daaaaaaaaaniel/claude-schematic-monomachine-workflow/explore/header-candidates/A2/floorplan-control.png

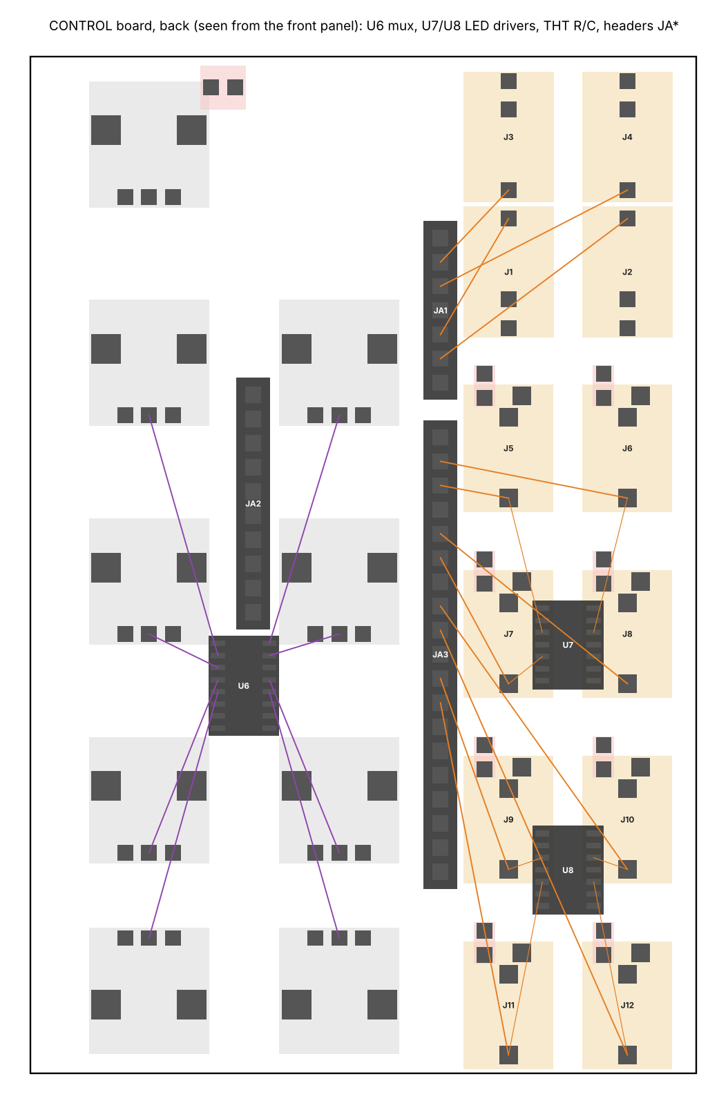
explore/header-candidates/A2/floorplan-control.png
