daaaaaaaaaniel/claude-schematic-monomachine-workflow/explore/header-candidates/A2/floorplan-crossing.png

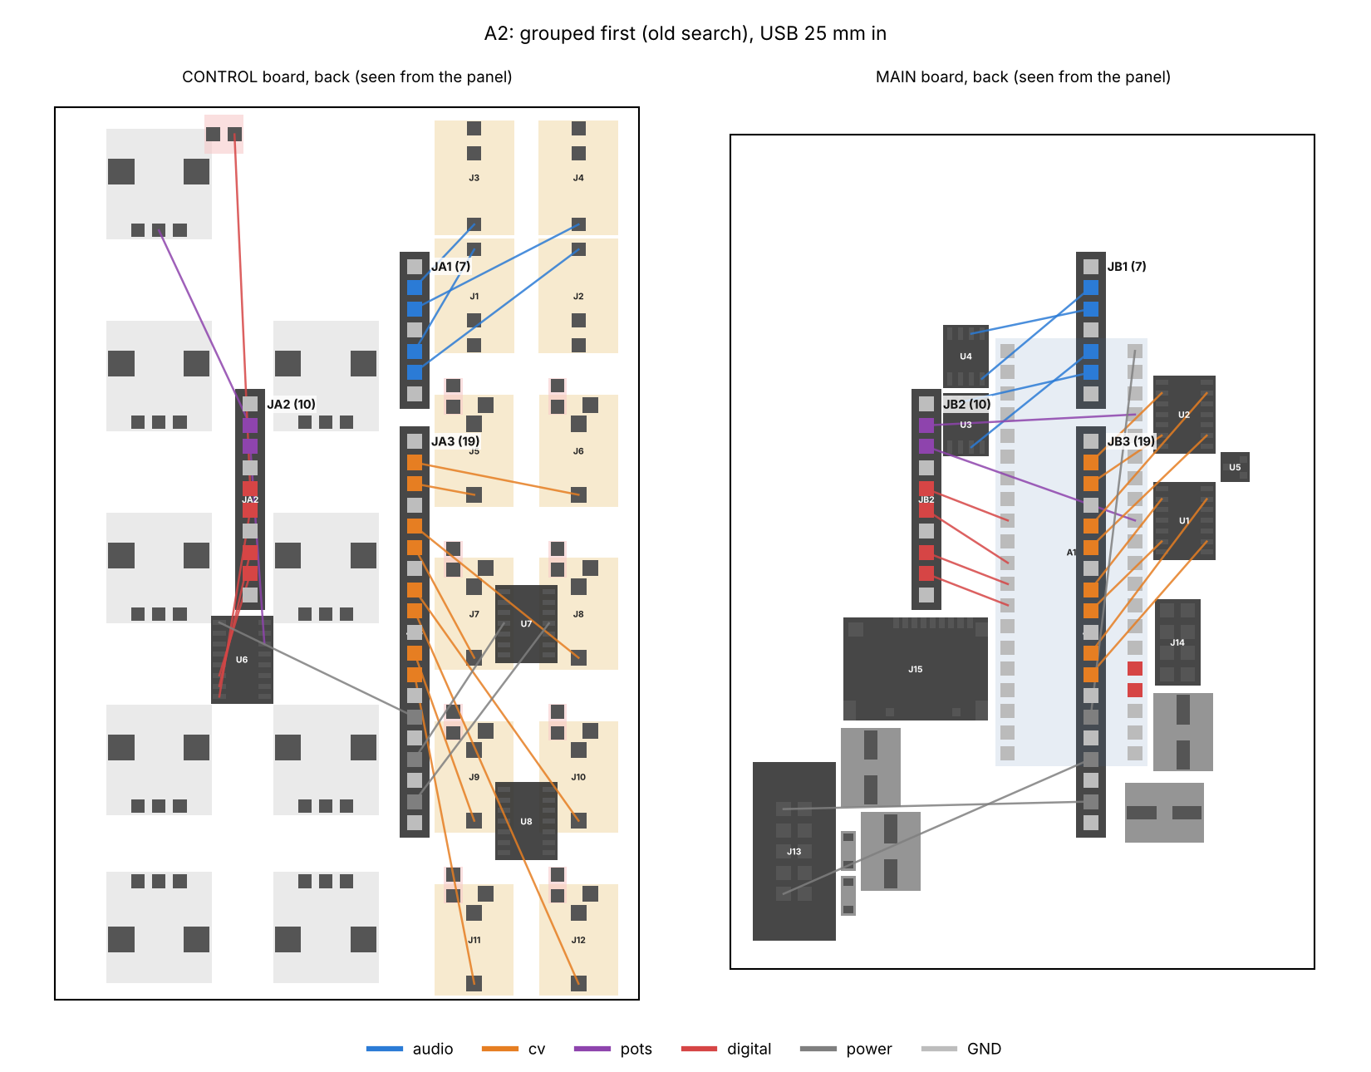
explore/header-candidates/A2/floorplan-crossing.png
