daaaaaaaaaniel/claude-schematic-monomachine-workflow/explore/header-candidates/A2/floorplan-main.png

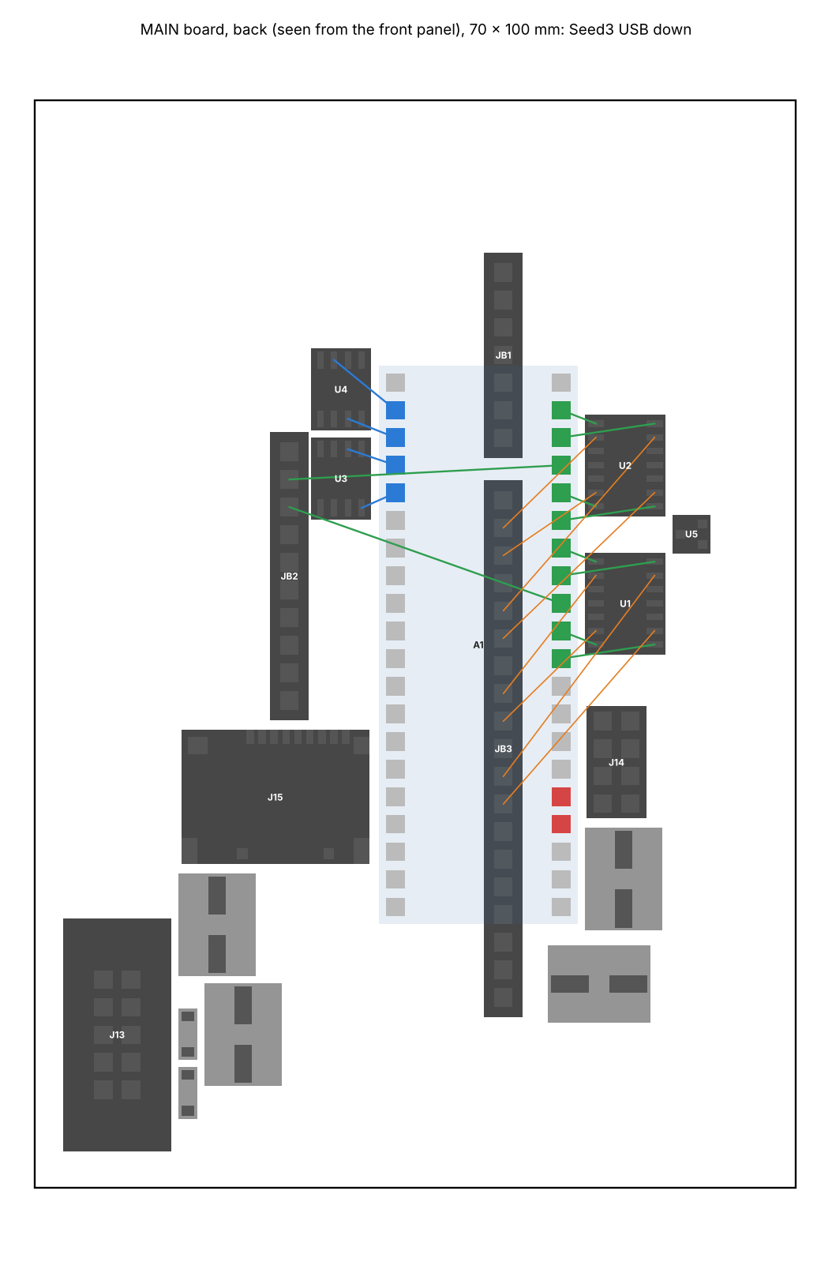
explore/header-candidates/A2/floorplan-main.png
