daaaaaaaaaniel/claude-schematic-monomachine-workflow/explore/header-candidates/A/floorplan-crossing.png

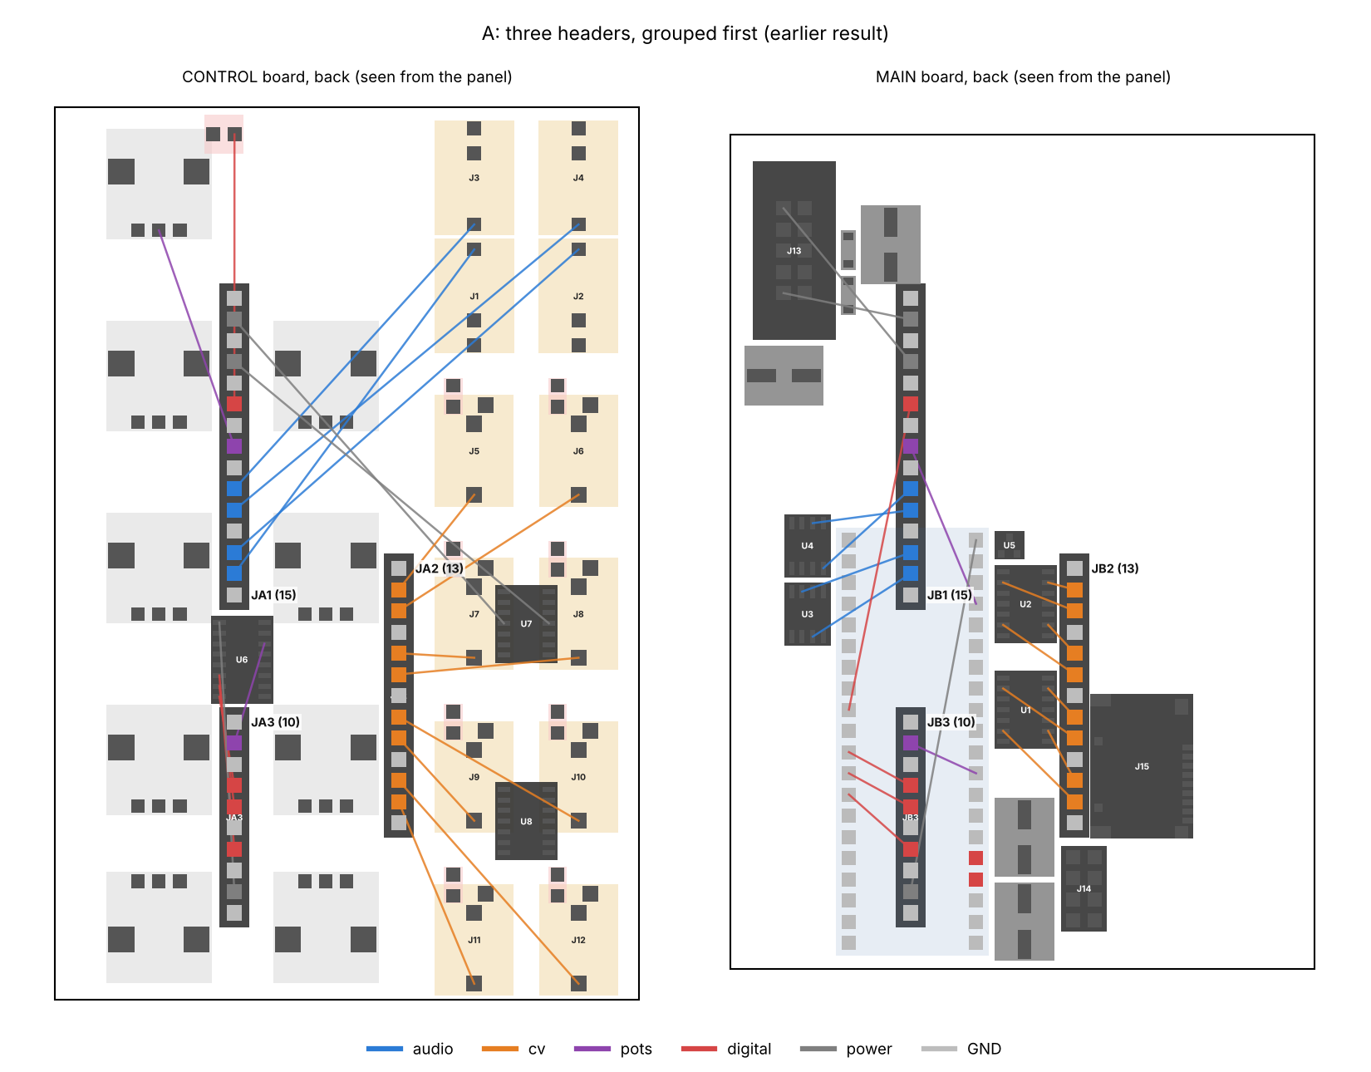
explore/header-candidates/A/floorplan-crossing.png
