daaaaaaaaaniel/claude-schematic-monomachine-workflow/explore/header-candidates/B/floorplan-crossing.png

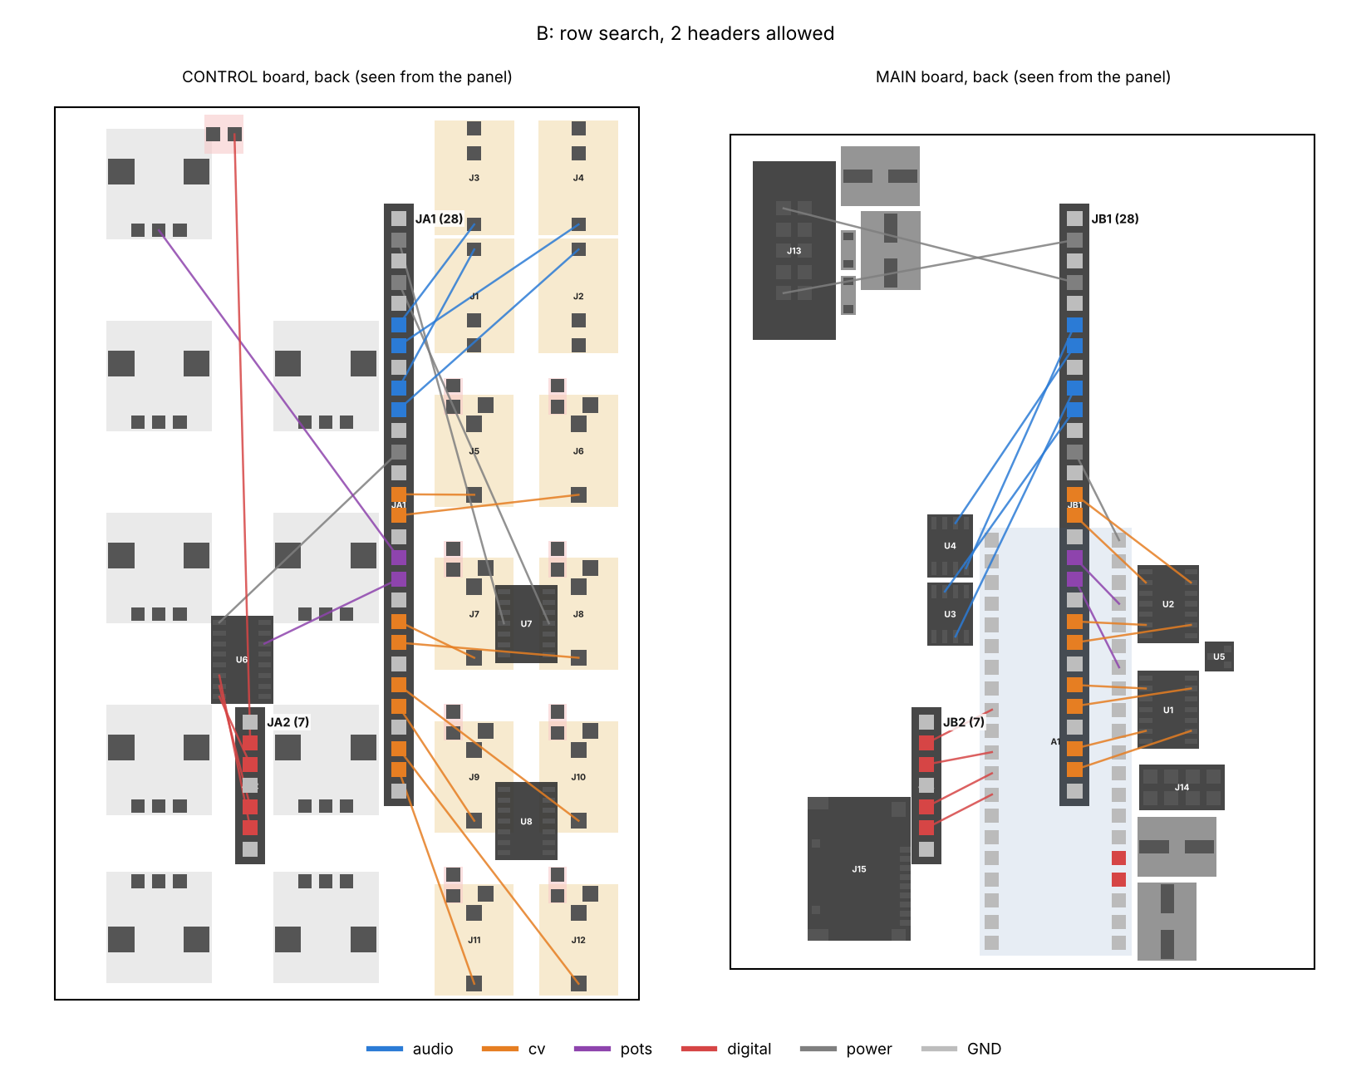
explore/header-candidates/B/floorplan-crossing.png
