daaaaaaaaaniel/claude-schematic-monomachine-workflow/explore/header-candidates/C2/floorplan-control.png

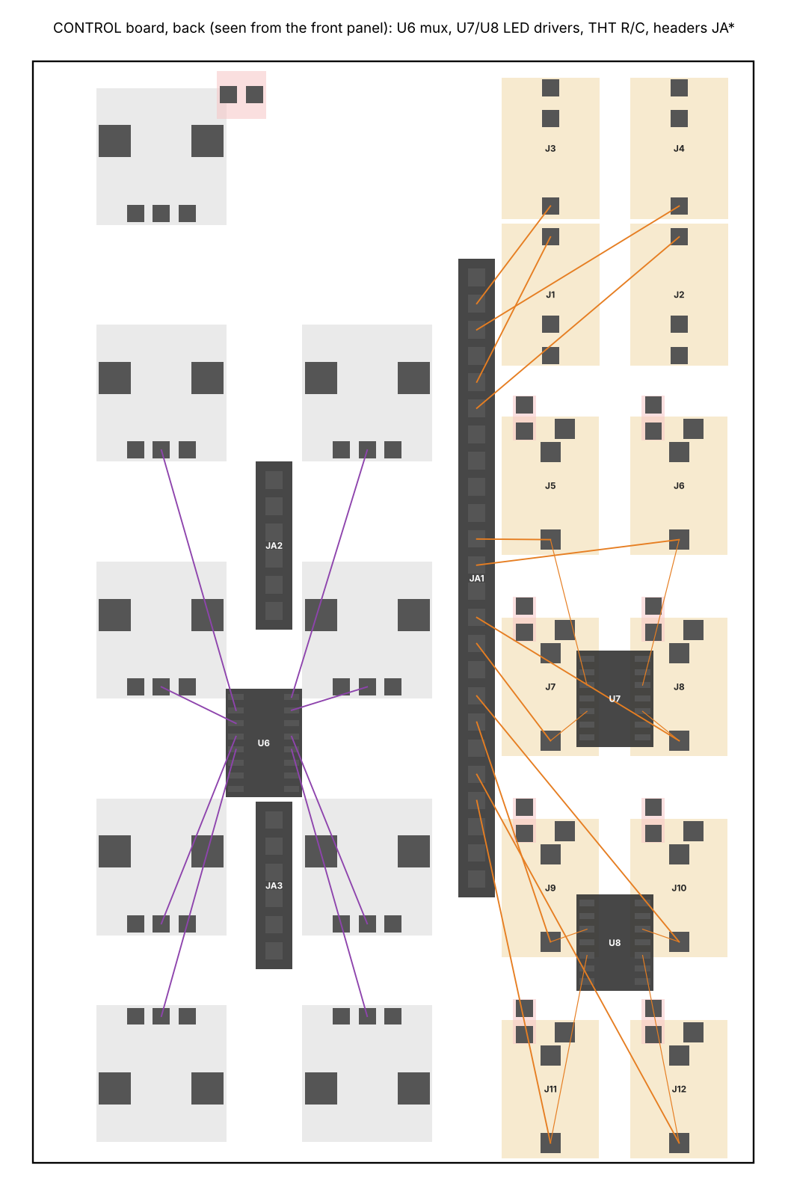
explore/header-candidates/C2/floorplan-control.png
