daaaaaaaaaniel/claude-schematic-monomachine-workflow/explore/header-candidates/C2/floorplan-crossing.png

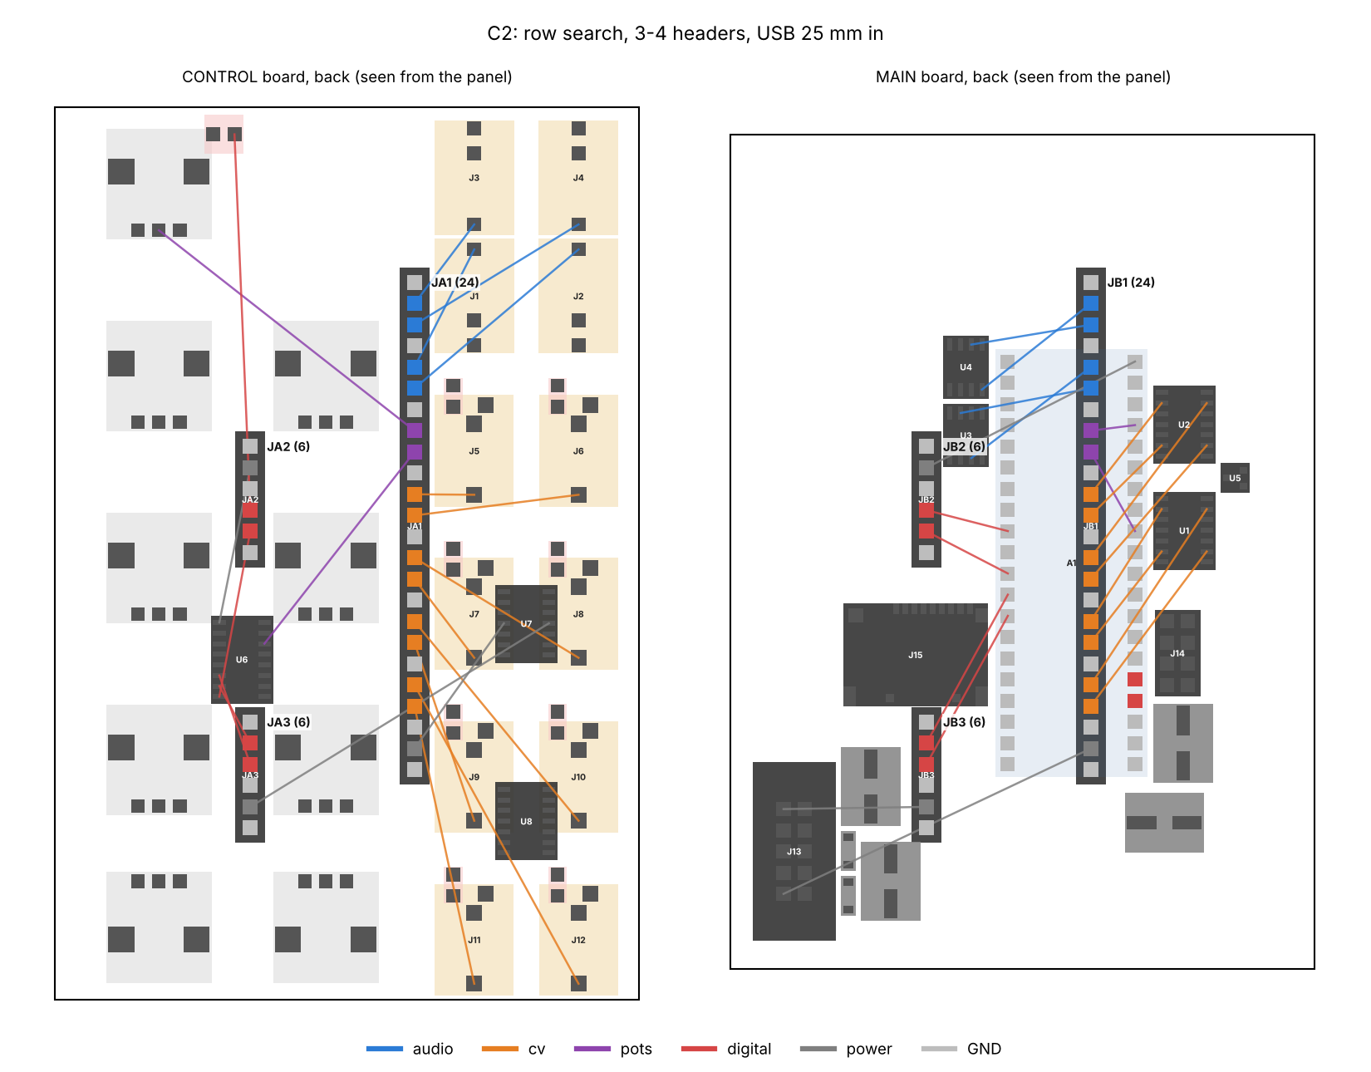
explore/header-candidates/C2/floorplan-crossing.png
