daaaaaaaaaniel/claude-schematic-monomachine-workflow/explore/header-candidates/C/floorplan-crossing.png

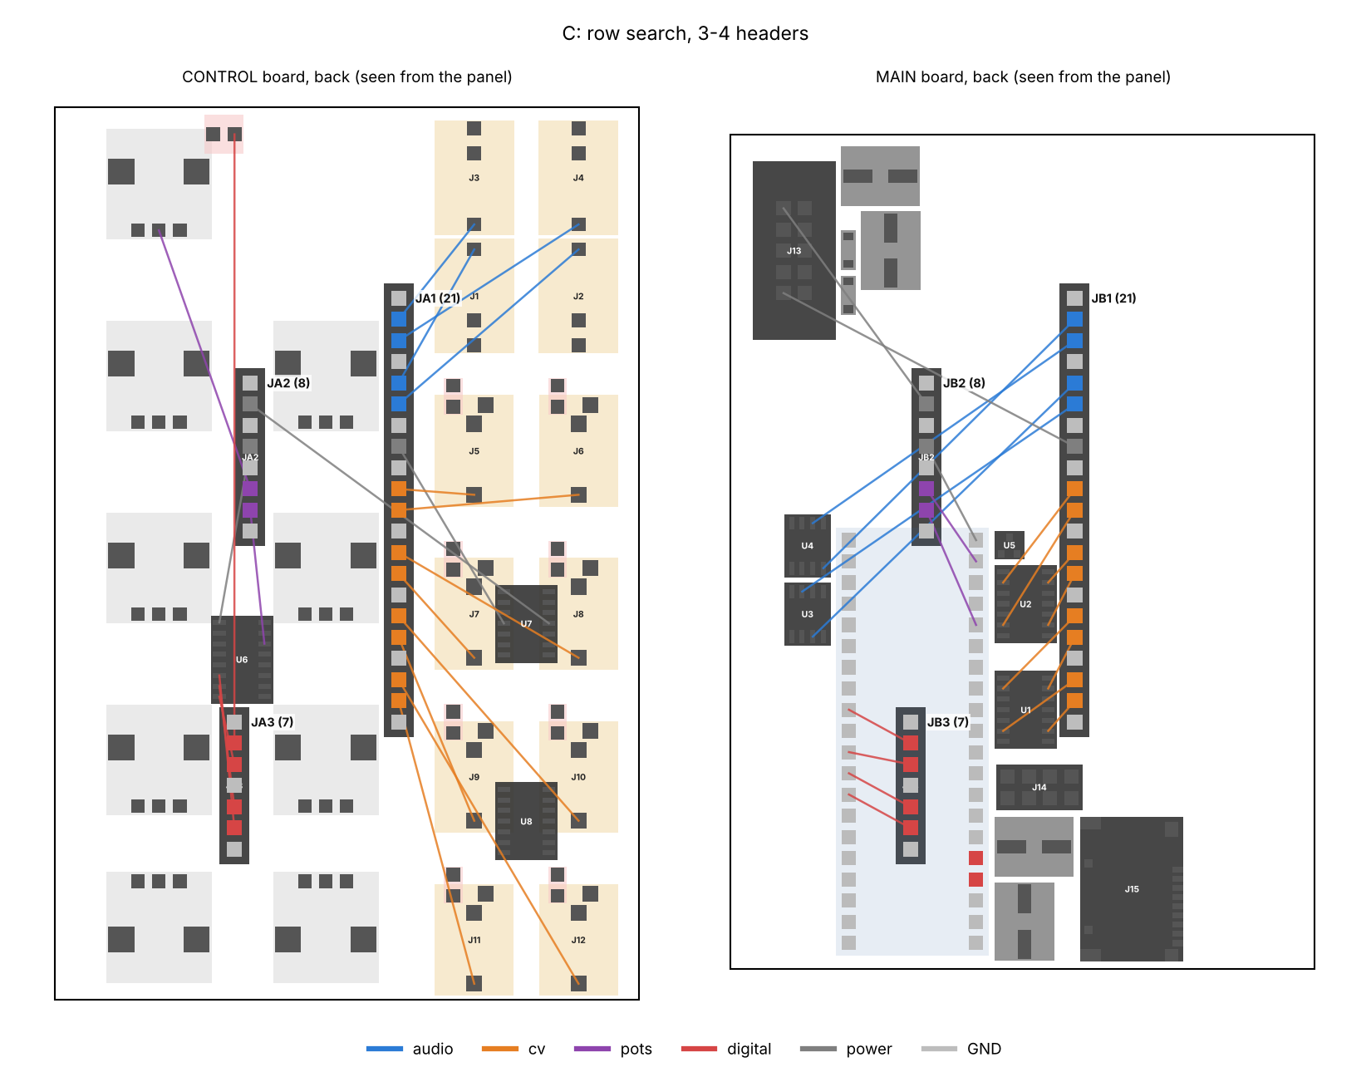
explore/header-candidates/C/floorplan-crossing.png
