daaaaaaaaaniel/claude-schematic-monomachine-workflow/explore/header-candidates/D/floorplan-crossing.png

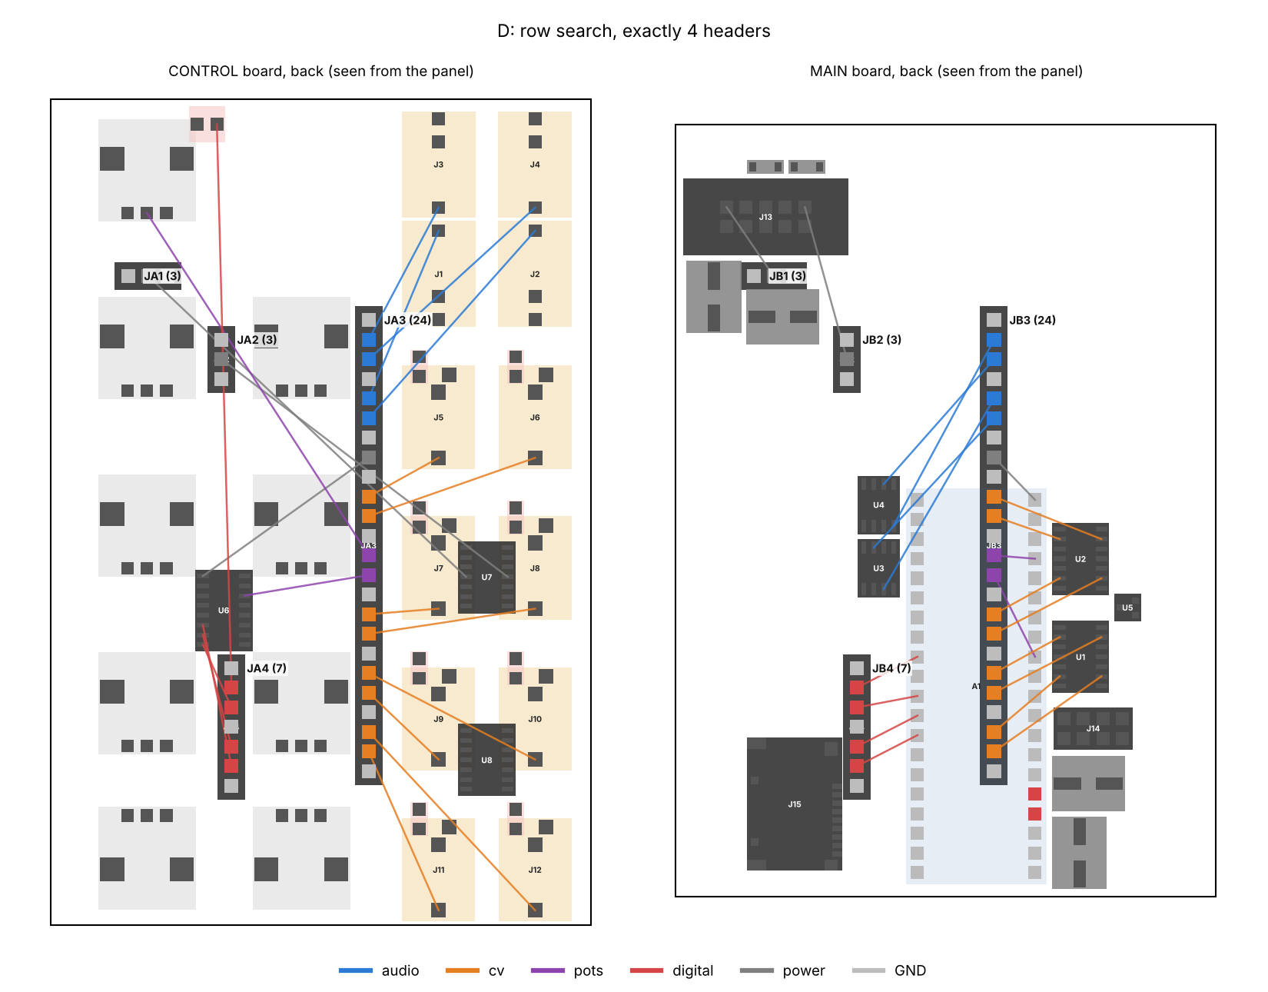
explore/header-candidates/D/floorplan-crossing.png
