daaaaaaaaaniel/claude-schematic-monomachine-workflow/pcb/out/floorplan-control.png

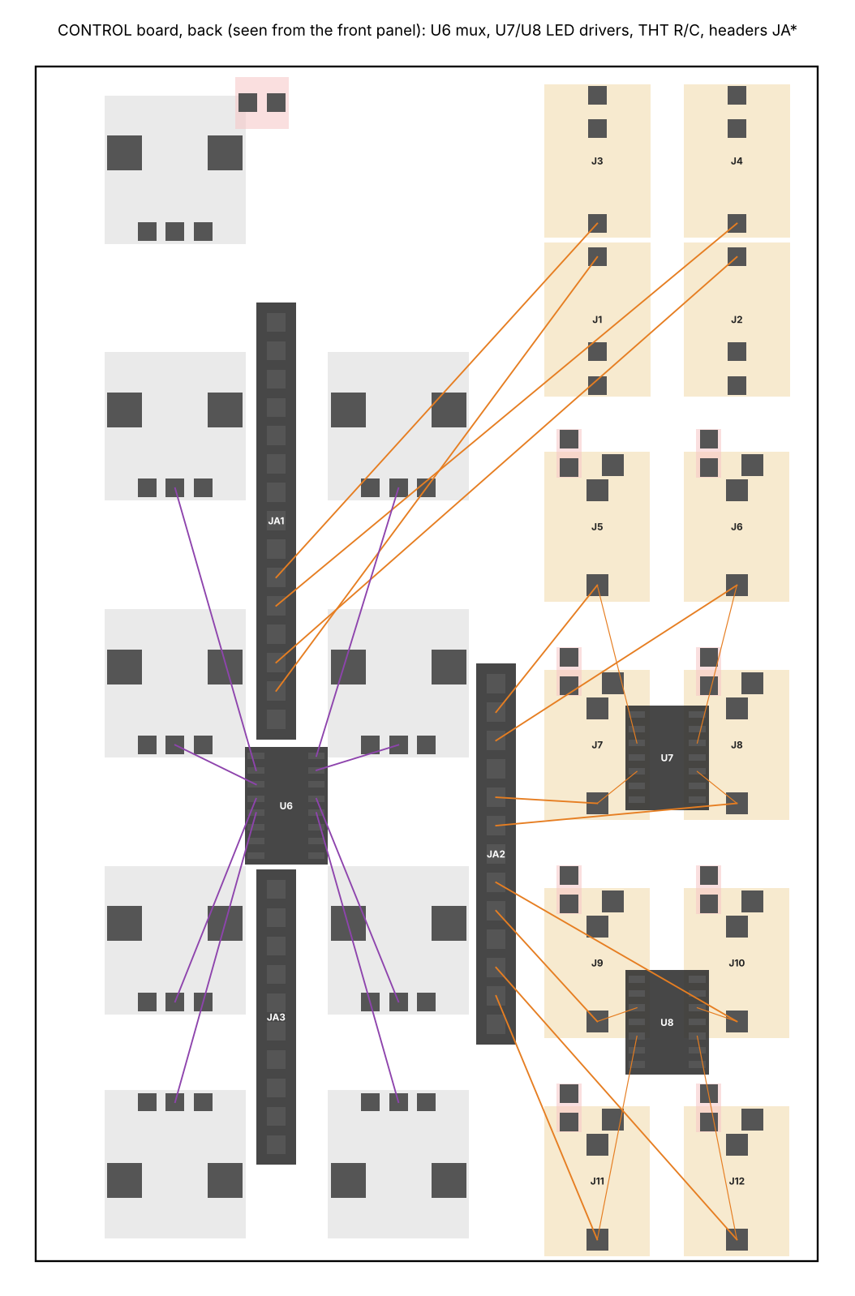
pcb/out/floorplan-control.png
