daaaaaaaaaniel/claude-schematic-monomachine-workflow/pcb/out/floorplan-main.png

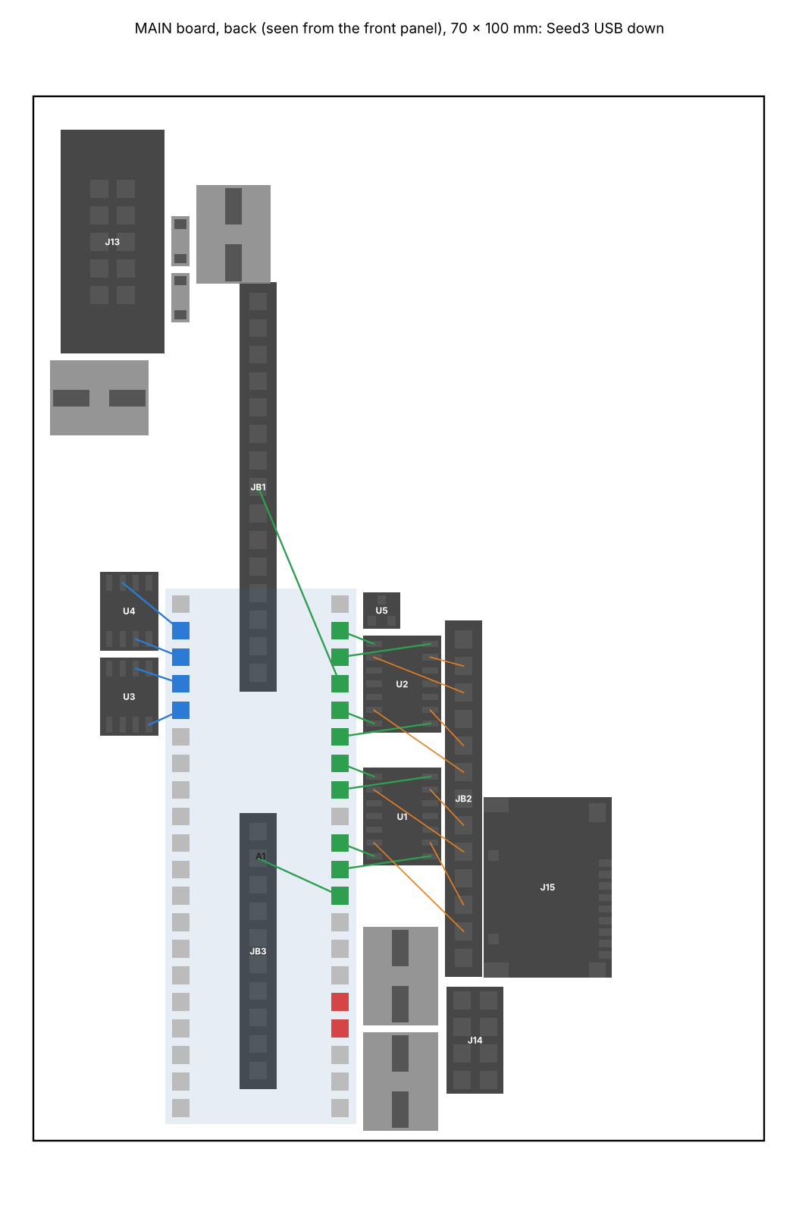
pcb/out/floorplan-main.png
