daaaaaaaaaniel/claude-schematic-monomachine-workflow/pcb/out/pcb-placement.png

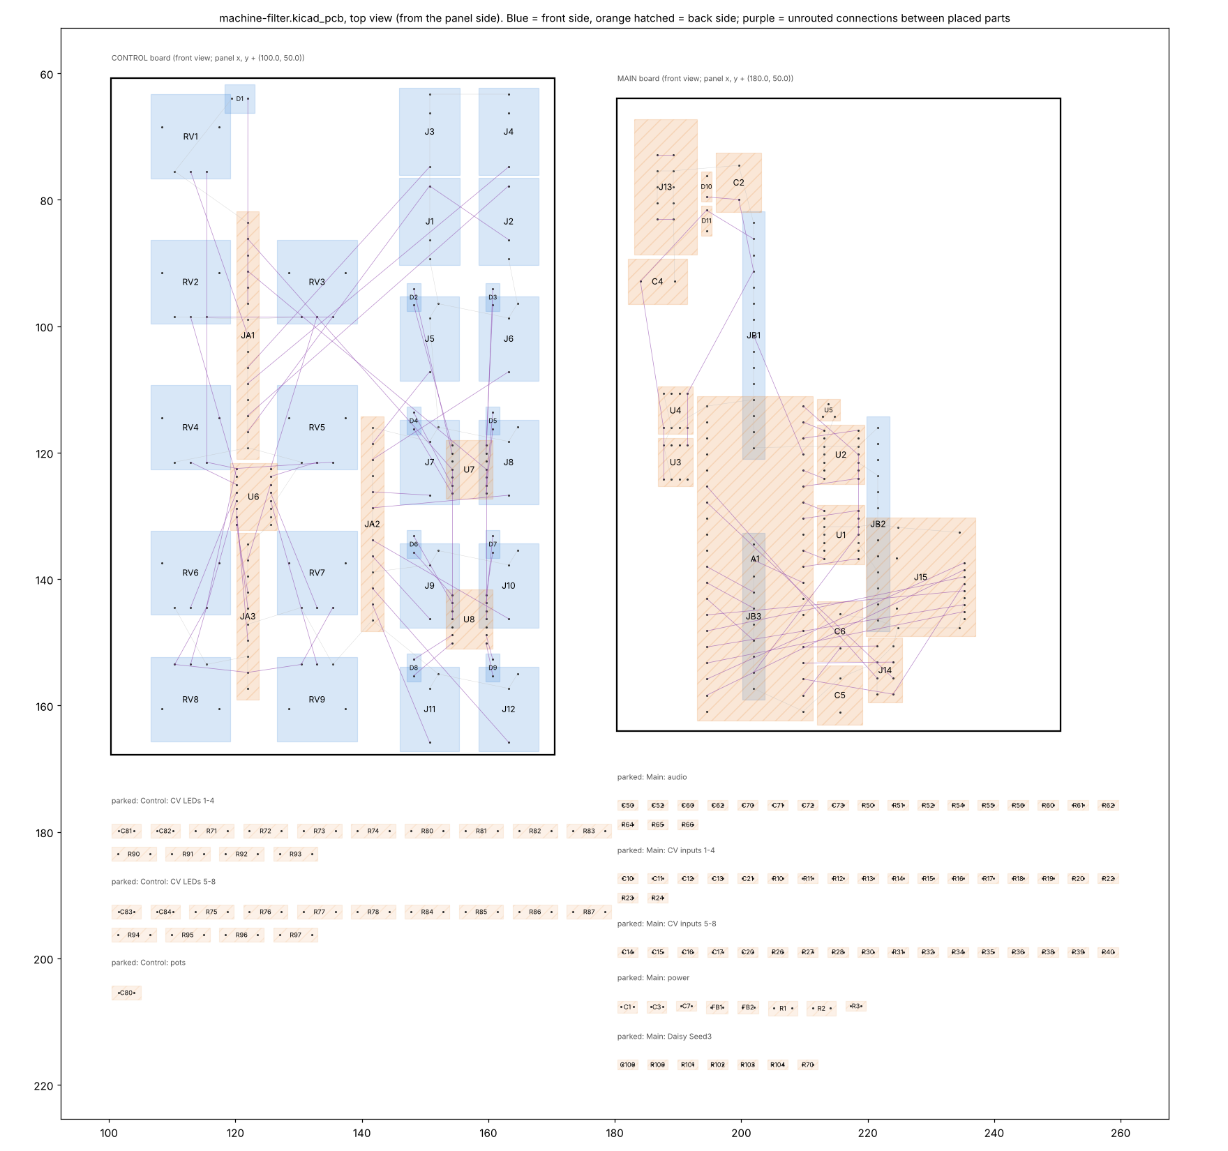
pcb/out/pcb-placement.png
