daaaaaaaaaniel/claude-schematic-monomachine-workflow/pcb/sim/ngspice-checks.png

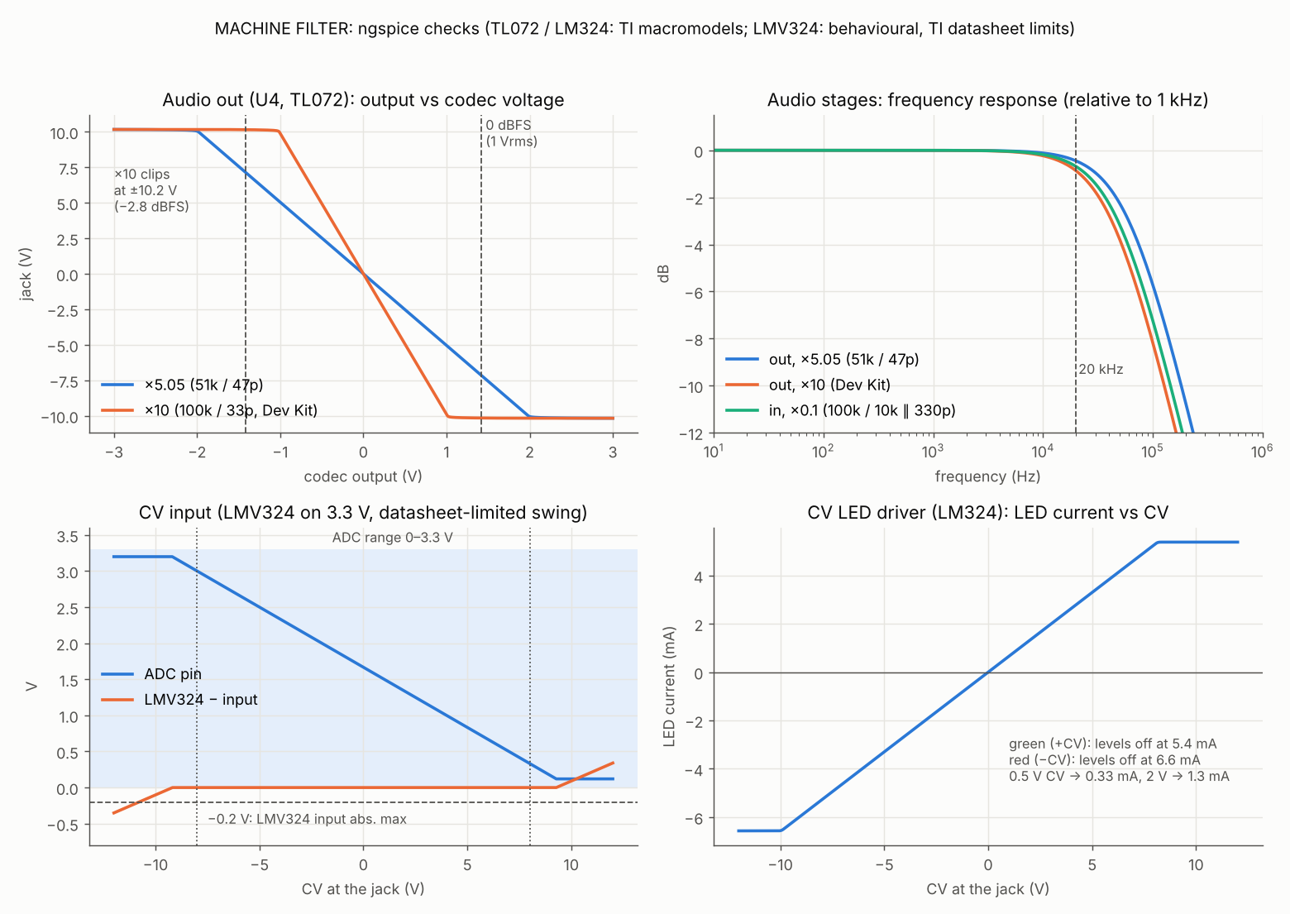
pcb/sim/ngspice-checks.png
