daaaaaaaaaniel/claude-schematic-monomachine-workflow/pcb/out/bom.csv

Reference | Value | Footprint | LCSC | MPN | Board | Assembly | DNP | QUANTITY
A1 | Daisy Seed3 | filter-module:Daisy_Seed_ES_Sockets |  | Electrosmith Daisy Seed3 on 2x 1x20 2.54 mm sockets | main | hand |  | 1
C1,C3 | 10u 25V | filter-module:C_0805 | C15850 | CL21A106KAYNNNE | main | JLC (SMD) |  | 2
C2,C4-C6 | 100u 35V | Capacitor_SMD:CP_Elec_6.3x7.7 | C72478 | RVT1V101M0607 | main | JLC (SMD) |  | 4
C7,C20,C21,C70-C73,C100 | 100n | filter-module:C_0603 | C14663 | CC0603KRX7R9BB104 | main | JLC (SMD) |  | 8
C10-C17 | 1n | filter-module:C_0603 | C1588 | CL10B102KB8NNNC | main | JLC (SMD) |  | 8
C50,C52 | 330p | filter-module:C_0603 | C1664 | CL10C331JB8NNNC | main | JLC (SMD) |  | 2
C60,C62 | 47p | filter-module:C_0603 | C1671 | CL10C470JB8NNNC | main | JLC (SMD) |  | 2
C80-C84 | 100n | Capacitor_THT:C_Disc_D3.0mm_W1.6mm_P2.50mm |  | 100 nF 50 V X7R ceramic, 2.5 mm pitch | control | hand |  | 5
D1 | red 3 mm | filter-module:LED_3mm_C1A2 |  | 3 mm red LED, diffused | control | hand |  | 1
D2-D9 | red/green 3 mm | filter-module:LED_3mm_Raised |  | 3 mm red/green bicolour LED, 2 leads (anti-parallel), diffused | control | hand |  | 8
D10,D11 | B5819W | filter-module:D_SOD-123 | C8598 | B5819W SL | main | JLC (SMD) |  | 2
FB1,FB2 | 600R@100MHz 0.5A | filter-module:R_0805_2012Metric | C1017 | GZ2012D601TF | main | JLC (SMD) |  | 2
J1-J4 | PJ398SM | filter-module:PJ398SM_Jack_ES |  | Thonkiconn PJ398SM | control | hand |  | 4
J5-J12 | PJ398SM | filter-module:PJ398SM_Jack_4ms_BentGND |  | Thonkiconn PJ398SM, sleeve leg bent to the footprint | control | hand |  | 8
J13 | EURO PWR 2x5 | filter-module:Pins_2x05_2.54mm_TH_EurorackPower_Shrouded |  | 2x5 2.54 mm shrouded box header | main | hand |  | 1
J14 | EXPANSION 2x4 | filter-module:Pins_2x04_2.54mm_TH |  | 2x4 2.54 mm pin header, unshrouded (d) | main | hand |  | 1
J15 | TF-01A | filter-module:TF-01A | C91145 | HRO TF-01A microSD socket, push-push (optional, DNP) | main | JLC (SMD) | DNP | 1
JA1 | 1x15 socket | Connector_PinSocket_2.54mm:PinSocket_1x15_P2.54mm_Vertical |  | 2.54 mm female header 1x15, 8.5 mm (as the Seed3 sockets) | control | hand |  | 1
JA2 | 1x13 socket | Connector_PinSocket_2.54mm:PinSocket_1x13_P2.54mm_Vertical |  | 2.54 mm female header 1x13, 8.5 mm (as the Seed3 sockets) | control | hand |  | 1
JA3 | 1x10 socket | Connector_PinSocket_2.54mm:PinSocket_1x10_P2.54mm_Vertical |  | 2.54 mm female header 1x10, 8.5 mm (as the Seed3 sockets) | control | hand |  | 1
JB1 | 1x15 header | Connector_PinHeader_2.54mm:PinHeader_1x15_P2.54mm_Vertical |  | 2.54 mm male pin header 1x15 | main | hand |  | 1
JB2 | 1x13 header | Connector_PinHeader_2.54mm:PinHeader_1x13_P2.54mm_Vertical |  | 2.54 mm male pin header 1x13 | main | hand |  | 1
JB3 | 1x10 header | Connector_PinHeader_2.54mm:PinHeader_1x10_P2.54mm_Vertical |  | 2.54 mm male pin header 1x10 | main | hand |  | 1
R1,R2 | 3.3 0.75W | filter-module:R_1206_3216Metric | C2577888 | SG73P2BTTD3R30F | main | JLC (SMD) |  | 2
R3,R70 | 1k | filter-module:R_0603 | C21190 | 0603WAF1001T5E | main | JLC (SMD) |  | 2
R10,R14 | 100k 0.1% | filter-module:R_0603 | C122538 | RT0603BRD07100KL | main | JLC (SMD) |  | 2
R11,R13,R15,R17 | 20k 0.1% | filter-module:R_0603 | C723637 | RT0603BRD0720KL | main | JLC (SMD) |  | 4
R12,R16 | 120k 25ppm | filter-module:R_0603 | C862537 | RT0603DRD07120KL | main | JLC (SMD) |  | 2
R18,R20,R22,R24,R26,R28,R30,R32,R34,R36,R38,R40 | 120k | filter-module:R_0603 | C25808 | 0603WAF1203T5E | main | JLC (SMD) |  | 12
R19,R23,R27,R31,R35,R39 | 20k | filter-module:R_0603 | C4184 | 0603WAF2002T5E | main | JLC (SMD) |  | 6
R50,R54 | 100k | filter-module:R_0603 | C25803 | 0603WAF1003T5E | main | JLC (SMD) |  | 2
R51,R55,R60,R64 | 10k | filter-module:R_0603 | C25804 | 0603WAF1002T5E | main | JLC (SMD) |  | 4
R52,R56,R62,R66 | 100 | filter-module:R_0603 | C22775 | 0603WAF1000T5E | main | JLC (SMD) |  | 4
R61,R65 | 51k | filter-module:R_0603 | C23196 | 0603WAF5102T5E | main | JLC (SMD) |  | 2
R71-R78 | 1.5k | Resistor_THT:R_Axial_DIN0204_L3.6mm_D1.6mm_P5.08mm_Horizontal |  | 1.5k 1/8 W 1% metal film, axial DIN0204 | control | hand |  | 8
R80-R87 | 10k | Resistor_THT:R_Axial_DIN0204_L3.6mm_D1.6mm_P5.08mm_Horizontal |  | 10k 1/8 W 1% metal film, axial DIN0204 | control | hand |  | 8
R90-R97 | 1M | Resistor_THT:R_Axial_DIN0204_L3.6mm_D1.6mm_P5.08mm_Horizontal |  | 1M 1/8 W 1% metal film, axial DIN0204 | control | hand |  | 8
R100-R104 | 47k | filter-module:R_0603 | C25819 | 0603WAF4702T5E | main | JLC (SMD) |  | 5
RV1-RV9 | B10k | filter-module:Pot_9mm_SnapIn_ES |  | Alpha RD901F 9 mm B10k (any shaft) | control | hand |  | 9
U1,U2 | LMV324 | filter-module:SOIC-14_3.9x8.65mm_Pitch1.27mm | C7974 | LMV324IDR | main | JLC (SMD) |  | 2
U3,U4 | TL072 | filter-module:SOIC-8_3.9x4.9mm_Pitch1.27mm | C6961 | TL072CDT | main | JLC (SMD) |  | 2
U5 | LM4040-10 | filter-module:SOT-23 | C201738 | LM4040C10IDBZR | main | JLC (SMD) |  | 1
U6 | 74HC4051 | filter-module:SOIC-16_3.9x9.9mm_Pitch1.27mm | C9386 | 74HC4051D,653 | control | hand |  | 1
U7,U8 | LM324 | filter-module:SOIC-14_3.9x8.65mm_Pitch1.27mm | C71035 | LM324DT | control | hand |  | 2
