daaaaaaaaaniel/claude-schematic-monomachine-workflow/pcb/out/machine-filter.pdf

1 | 2 | 3 | 4 | 5 | 6 | 7 | 8

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
Size: A3 | Rev: beta | F Date: 2026-10-06
KiCad E.D.A. 10.0.6 | Id: 1/12

## Title: MACHINE FILTER

### File: machine-filter.kicad_sch

### Sheet: /

## MACHINE FILTER (Seed3 build): both boards

Drawn by pcb/design/gen_sch.py from boards.py; netlist checked against machine_filter.py (SKiDL).

Circuit blocks after Electrosmith's Seed3 Eurorack Dev Kit Rev3 (MIT).

### Page 1: MACHINE FILTER: two boards

Control: connector File: control-connector.kicad_sch Control: pots

File: control-pots.kicad_sch

### Control: CV LEDs 5-8

# File: control-cv-leds-5-8.kicad_sch Main: CV inputs 5-8

File: main-cv-inputs-5-8.kicad_sch

### Control: CV LEDs 1-4

File: control-cv-leds-1-4.kicad_sch

Main: power File: main-power.kicad_sch

### Main: CV inputs 1-4

File: main-cv-inputs-1-4.kicad_sch

### Main: Daisy Seed3

File: main-seed3.kicad_sch Control: jacks

File: control-jacks.kicad_sch

### Main: audio

File: main-audio.kicad_sch | Main: connector File: main-connector.kicad_sch

page 11

EQ FREQ, EQ GAIN, DIST, SMPL RATE

# LED drivers (U8) ADC stages (U1) page 5

EQ FREQ, EQ GAIN, DIST, SMPL RATE

page 4 | page 6

JAn plugs onto JBn, pin k to pin k, about 11 mm apart. Every net on the control board is its own copper, so it has its exactly the one-circuit SKiDL netlist (machine_filter.py).

BASE, WIDTH, HP RES, LP RES

ADC stages (U2) page 10 BASE, WIDTH, HP RES, LP RES
LED drivers (U7) | codec -> U4 -> OUT L / OUT R

page 7

JB1, JB2, JB3

to the control board

IN L / IN R -> U3 -> codec page 12

JA1, JA2, JA3

to the main board Daisy Seed3 (A1)

### MAIN board

### CONTROL board

through-hole resistors and capacitors, female headers JA1, JA2, JA3. 1 | MACHINE FILTER: two boards

JLC SMD assembly, 70 x 100 mm. Back: Daisy Seed3 on sockets, power entry, CV ADC stages U1/U2, audio U3/U4,

Hand-soldered, 70 x 107 mm. Front: 12 jacks, 9 pots, 9 LEDs. Back: pot multiplexer U6, LED drivers U7/U8 (SOIC),

How they meet own name: the main board's name with the prefix CTL_ (CTL_GND, CTL_+12V, CTL_CV_BASE, ...). CTL_x meets x only at MAIN board (JLC SMD assembly)

page 2

Eurorack power entry Seed3 VIN filter -10 V reference | page 3

the header pins (pages 7 and 12), as in the hardware. tools/check_netlist.py checks that the boards joined there are

expansion header J14

clip-LED resistor R70 microSD J15 (optional)

# CONTROL board (hand-soldered)

page 8

12 jacks

clip LED D1

page 9

9 pots

pot multiplexer U6

one KiCad project; the PCB file holds both boards side by side, cut apart for fabrication by tools/separate.sh (KiKit) -10 V reference U5, expansion header J14, optional microSD J15 (DNP). Front: male headers JB1 (15 pins), JB2 (13 pins), JB3 (10 pins).

## Two boards, one module

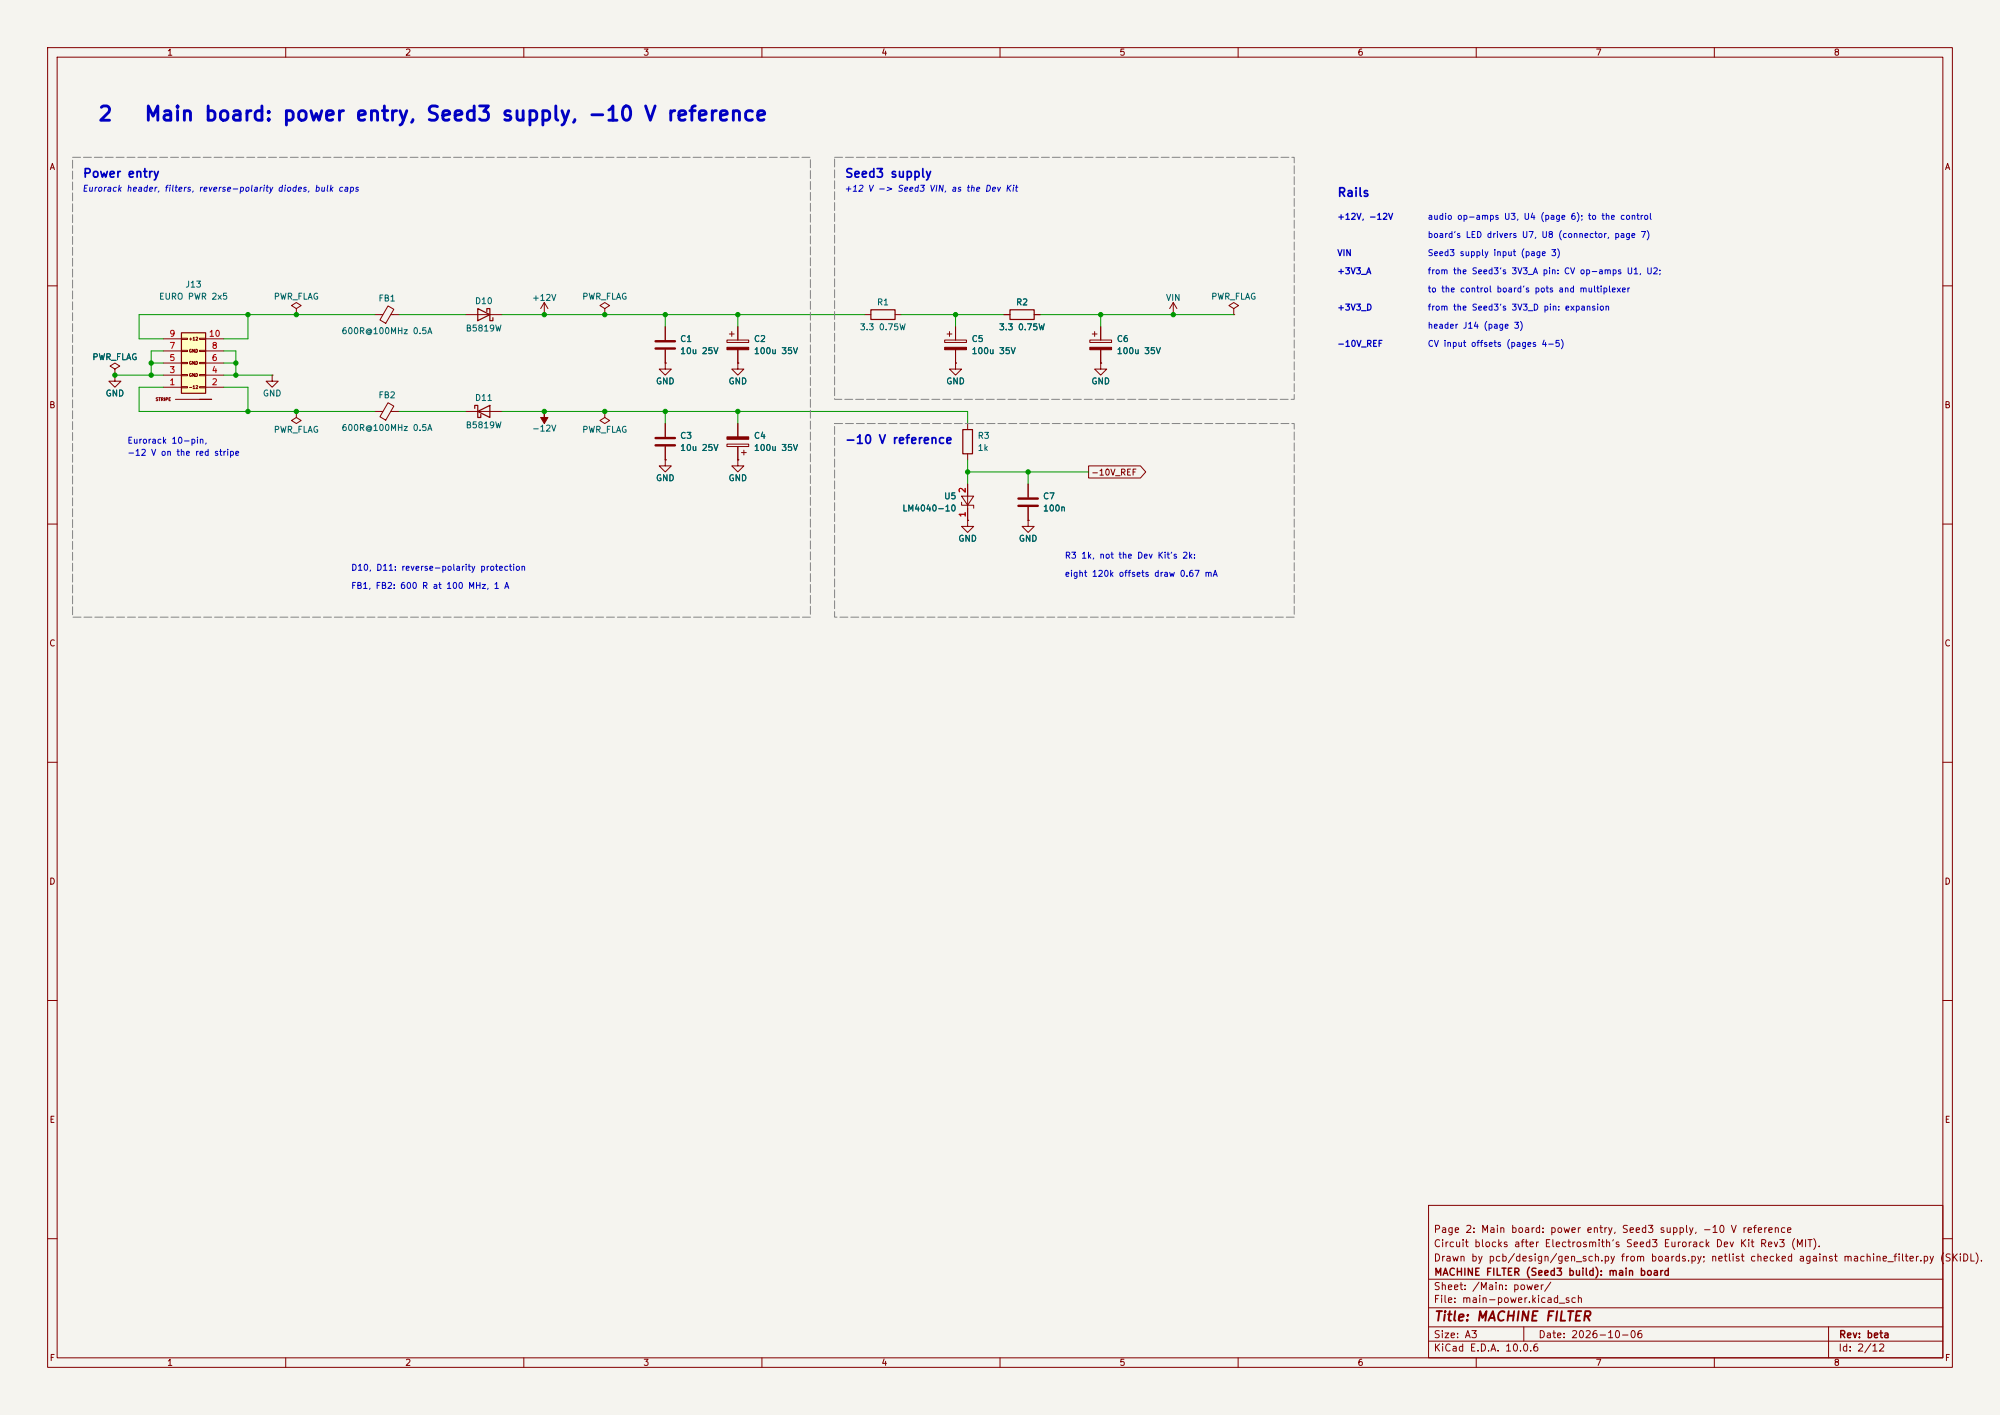
[picture p14: page 2]

FB1, FB2: 600 R at 100 MHz, 1 A Power entry

Rails -12 V on the red stripe Eurorack 10-pin,

from the Seed3's 3V3_A pin: CV op-amps U1, U2; Seed3 supply input (page 3) board's LED drivers U7, U8 (connector, page 7) audio op-amps U3, U4 (page 6); to the control VIN -10 V reference

to the control board's pots and multiplexer

from the Seed3's 3V3_D pin: expansion

GND -12 1 | 2

eight 120k offsets draw 0.67 mA

Page 2: Main board: power entry, Seed3 supply, -10 V reference
Circuit blocks after Electrosmith's Seed3 Eurorack Dev Kit Rev3 (MIT).
Drawn by pcb/design/gen_sch.py from boards.py; netlist checked against machine_filter.py (SKiDL).
MACHINE FILTER (Seed3 build): main board
Sheet: /Main: power/
File: main-power.kicad_sch

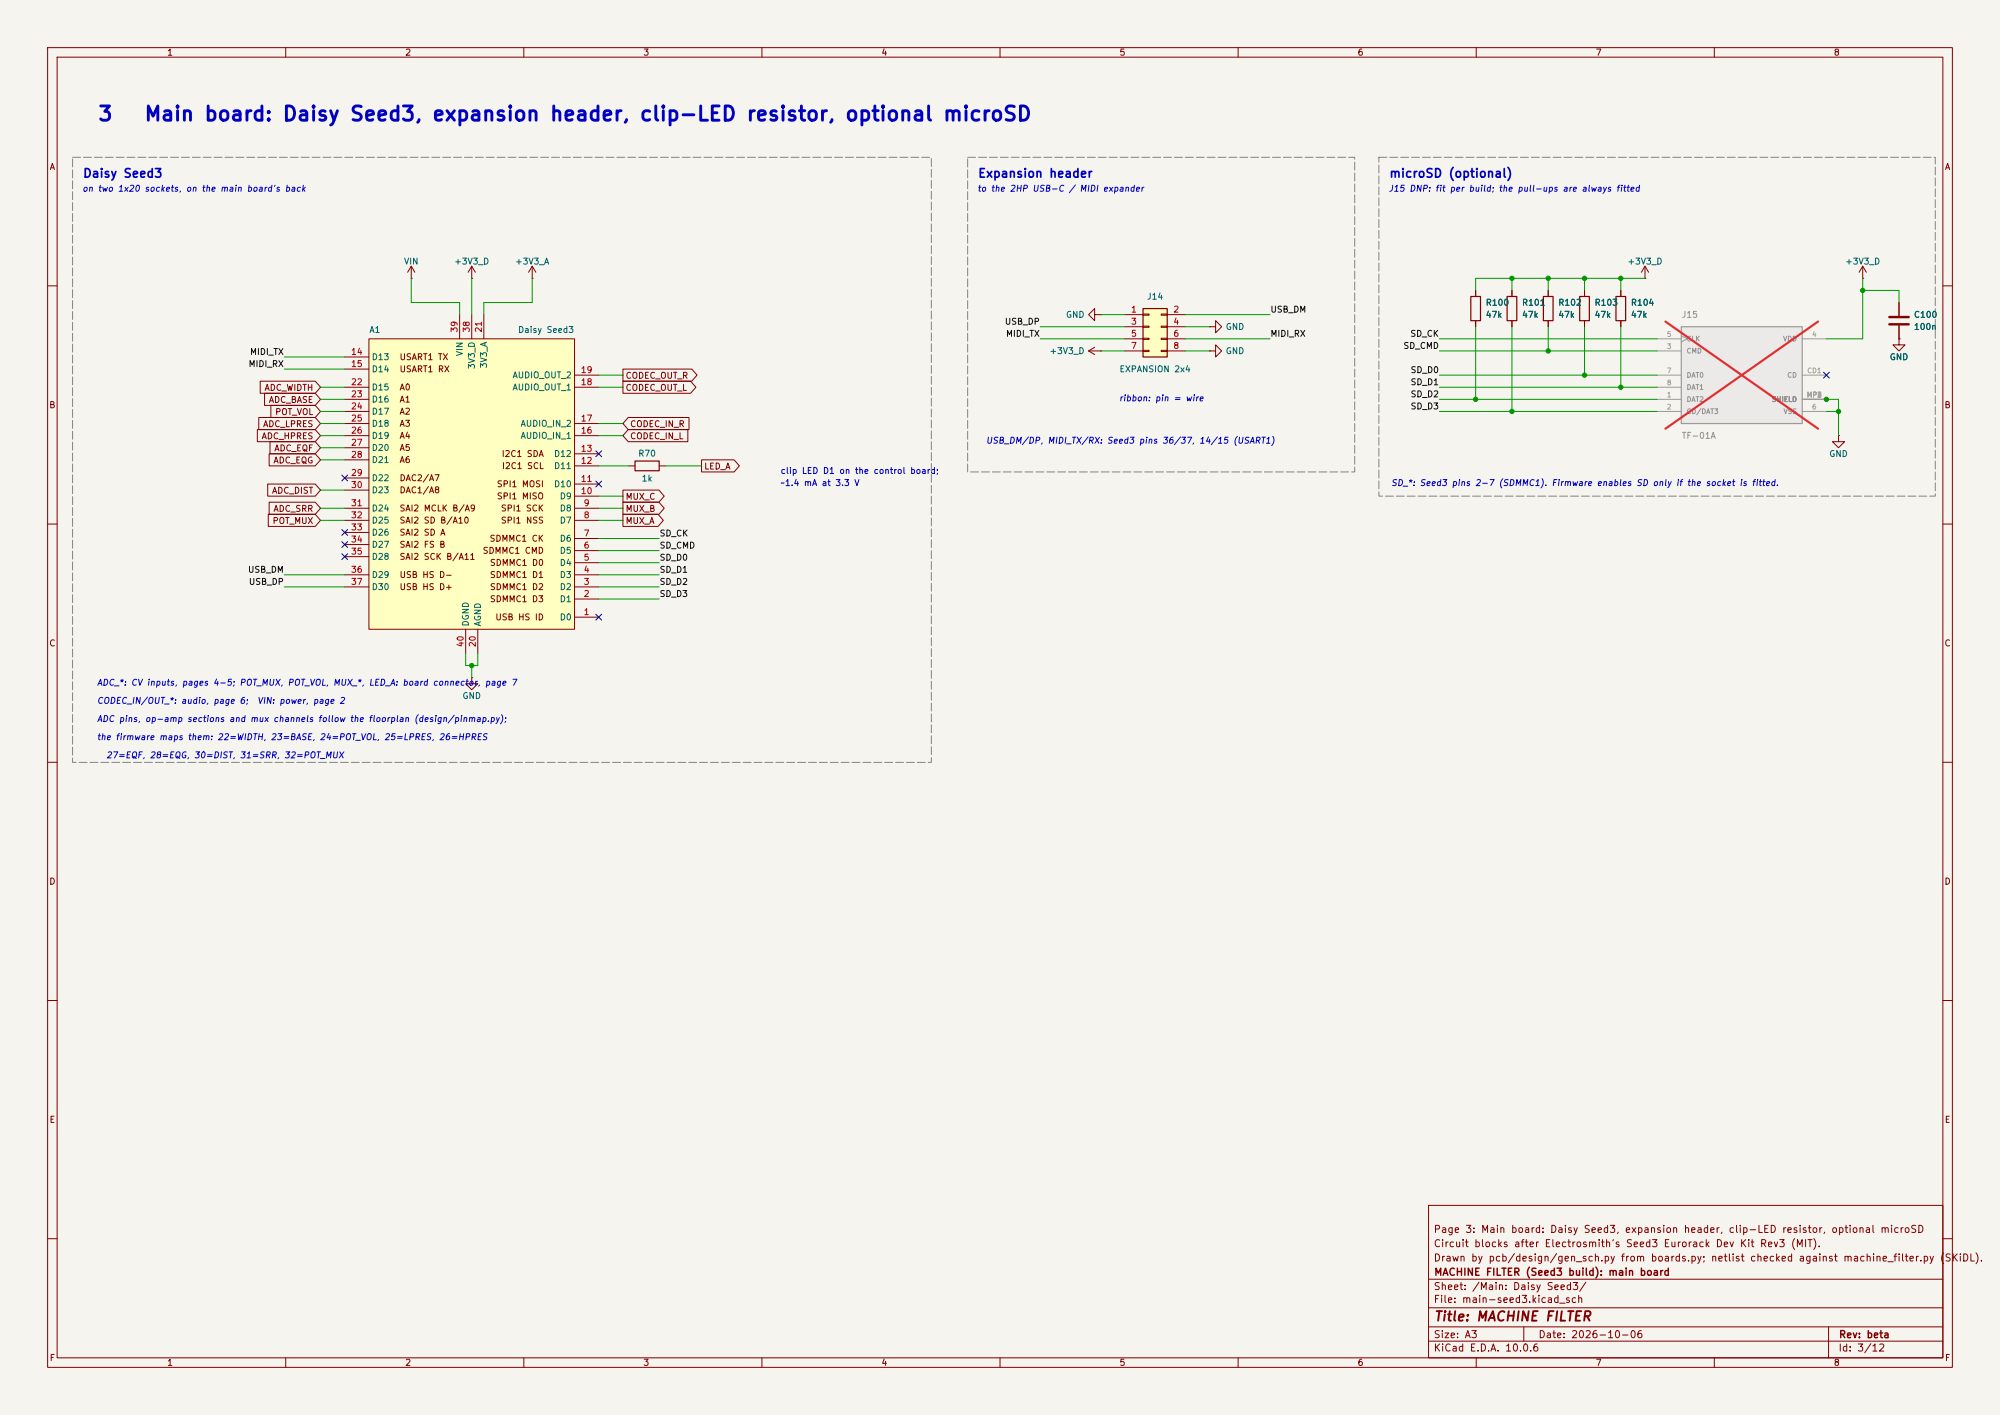
[picture p15: page 3]

ribbon: pin = wire Daisy Seed3

SD_*: Seed3 pins 2-7 (SDMMC1). Firmware enables SD only if the socket is fitted. J15 DNP: fit per build; the pull-ups are always fitted microSD (optional)

to the 2HP USB-C / MIDI expander

ADC_*: CV inputs, pages 4-5; POT_MUX, POT_VOL, MUX_*, LED_A: board connector, page 7

ADC pins, op-amp sections and mux channels follow the floorplan (design/pinmap.py);

the firmware maps them: 22=WIDTH, 23=BASE, 24=POT_VOL, 25=LPRES, 26=HPRES

27=EQF, 28=EQG, 30=DIST, 31=SRR, 32=POT_MUX

Page 3: Main board: Daisy Seed3, expansion header, clip-LED resistor, optional microSD
Circuit blocks after Electrosmith's Seed3 Eurorack Dev Kit Rev3 (MIT).
Drawn by pcb/design/gen_sch.py from boards.py; netlist checked against machine_filter.py (SKiDL).
MACHINE FILTER (Seed3 build): main board
Sheet: /Main: Daisy Seed3/
File: main-seed3.kicad_sch

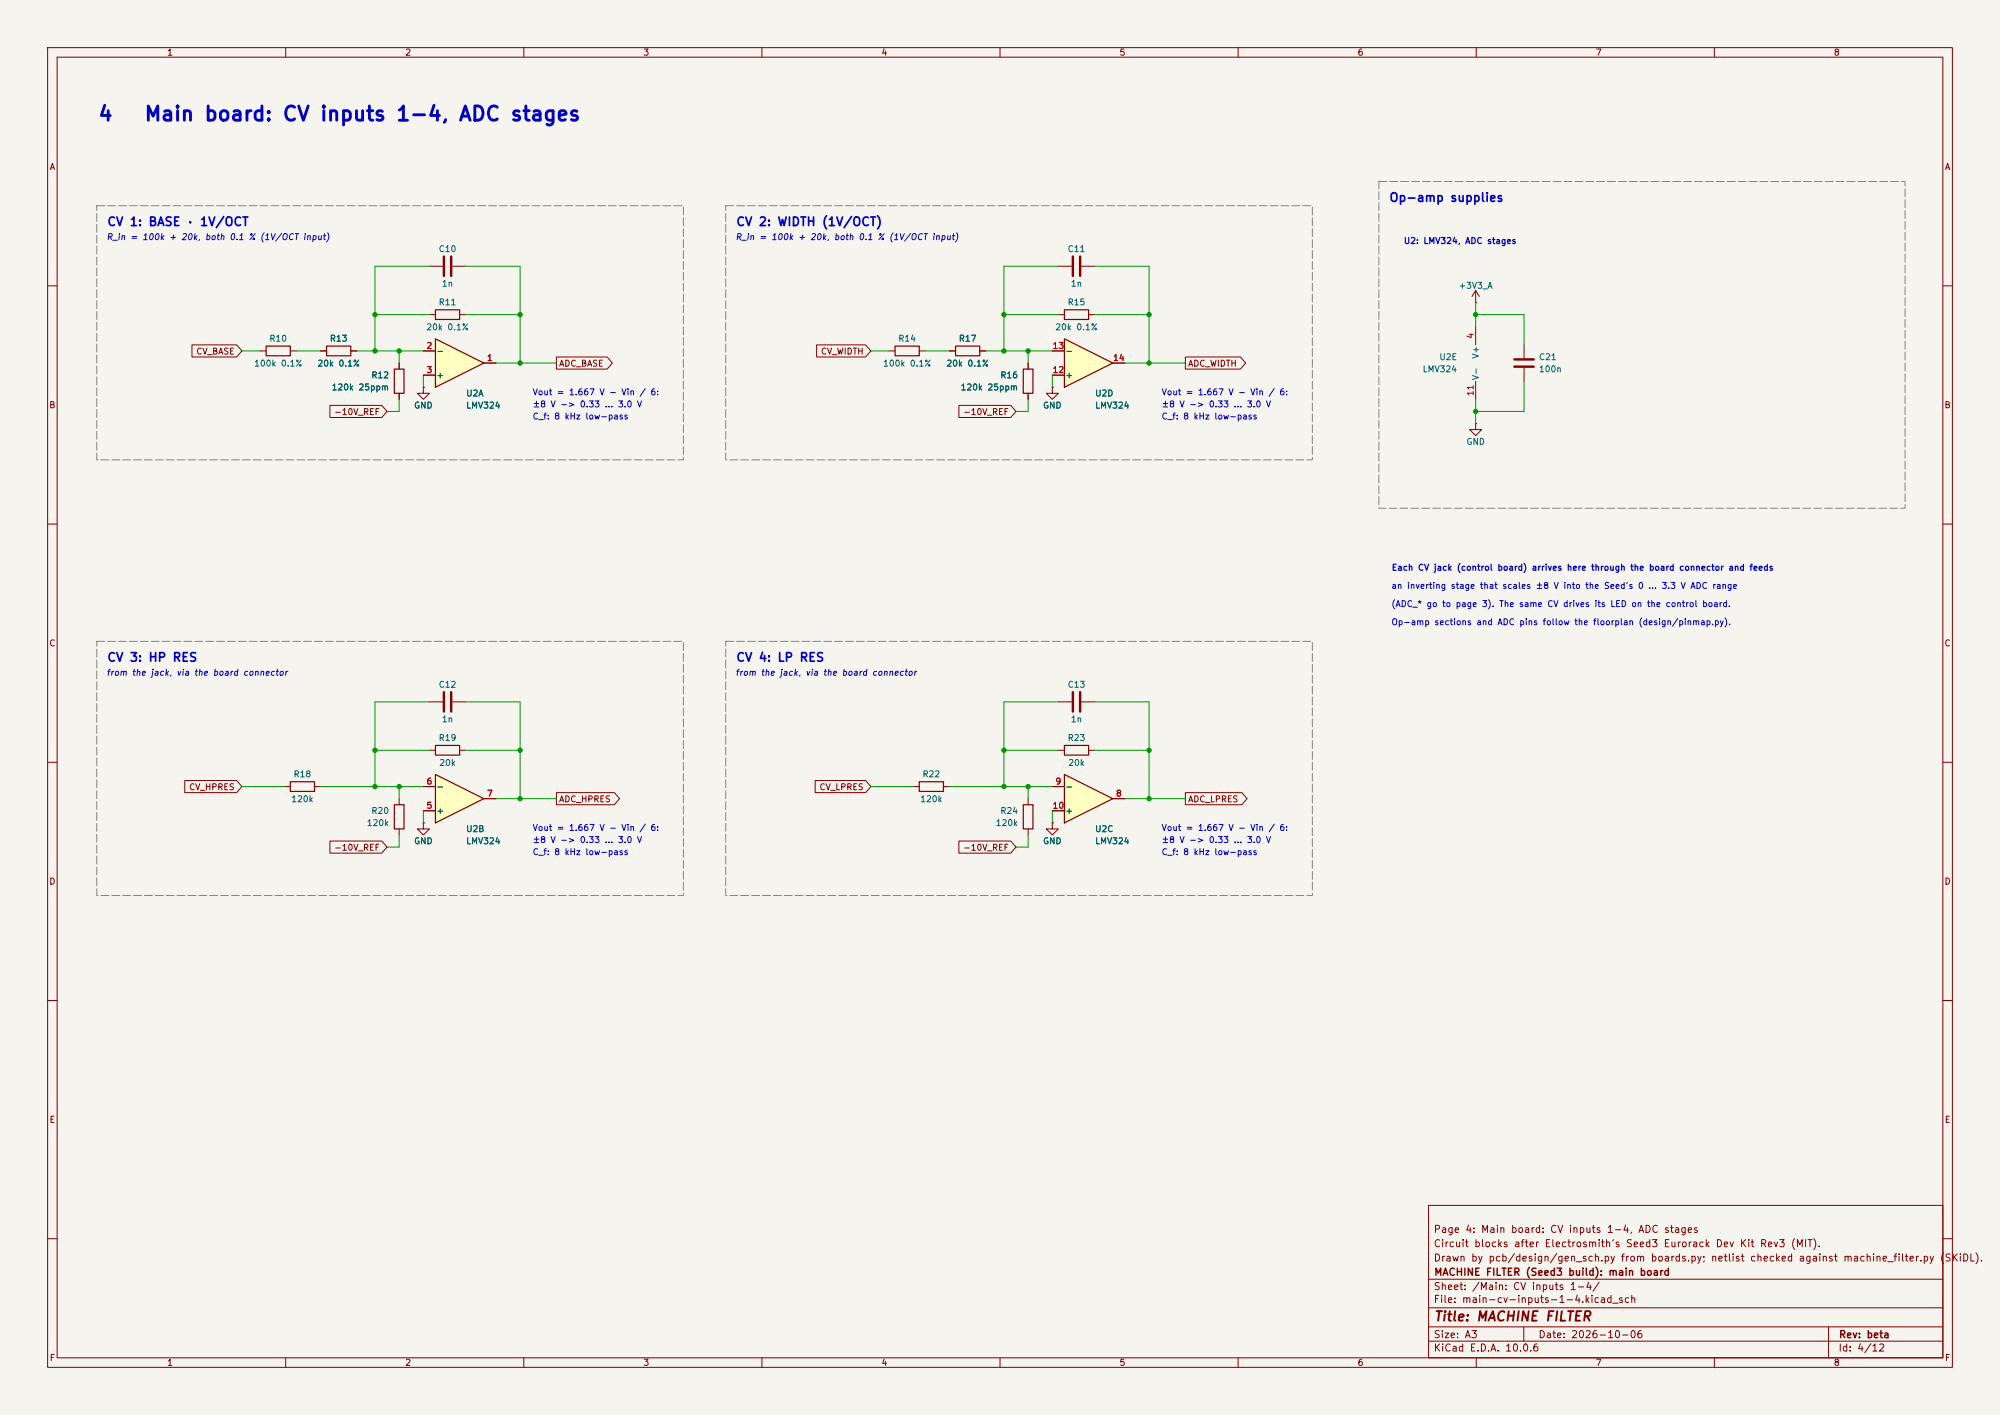
[picture p16: page 4]

Vout = 1.667 V - Vin / 6: C_f: 8 kHz low-pass ±8 V -> 0.33 ... 3.0 V R_in = 100k + 20k, both 0.1 % (1V/OCT input)

C_f: 8 kHz low-pass R_in = 100k + 20k, both 0.1 % (1V/OCT input)

(ADC_* go to page 3). The same CV drives its LED on the control board. Op-amp sections and ADC pins follow the floorplan (design/pinmap.py). Each CV jack (control board) arrives here through the board connector and feeds CV 3: HP RES

an inverting stage that scales ±8 V into the Seed's 0 ... 3.3 V ADC range

Page 4: Main board: CV inputs 1-4, ADC stages R24

Circuit blocks after Electrosmith's Seed3 Eurorack Dev Kit Rev3 (MIT).
Drawn by pcb/design/gen_sch.py from boards.py; netlist checked against machine_filter.py (SKiDL).
MACHINE FILTER (Seed3 build): main board
Sheet: /Main: CV inputs 1-4/
File: main-cv-inputs-1-4.kicad_sch

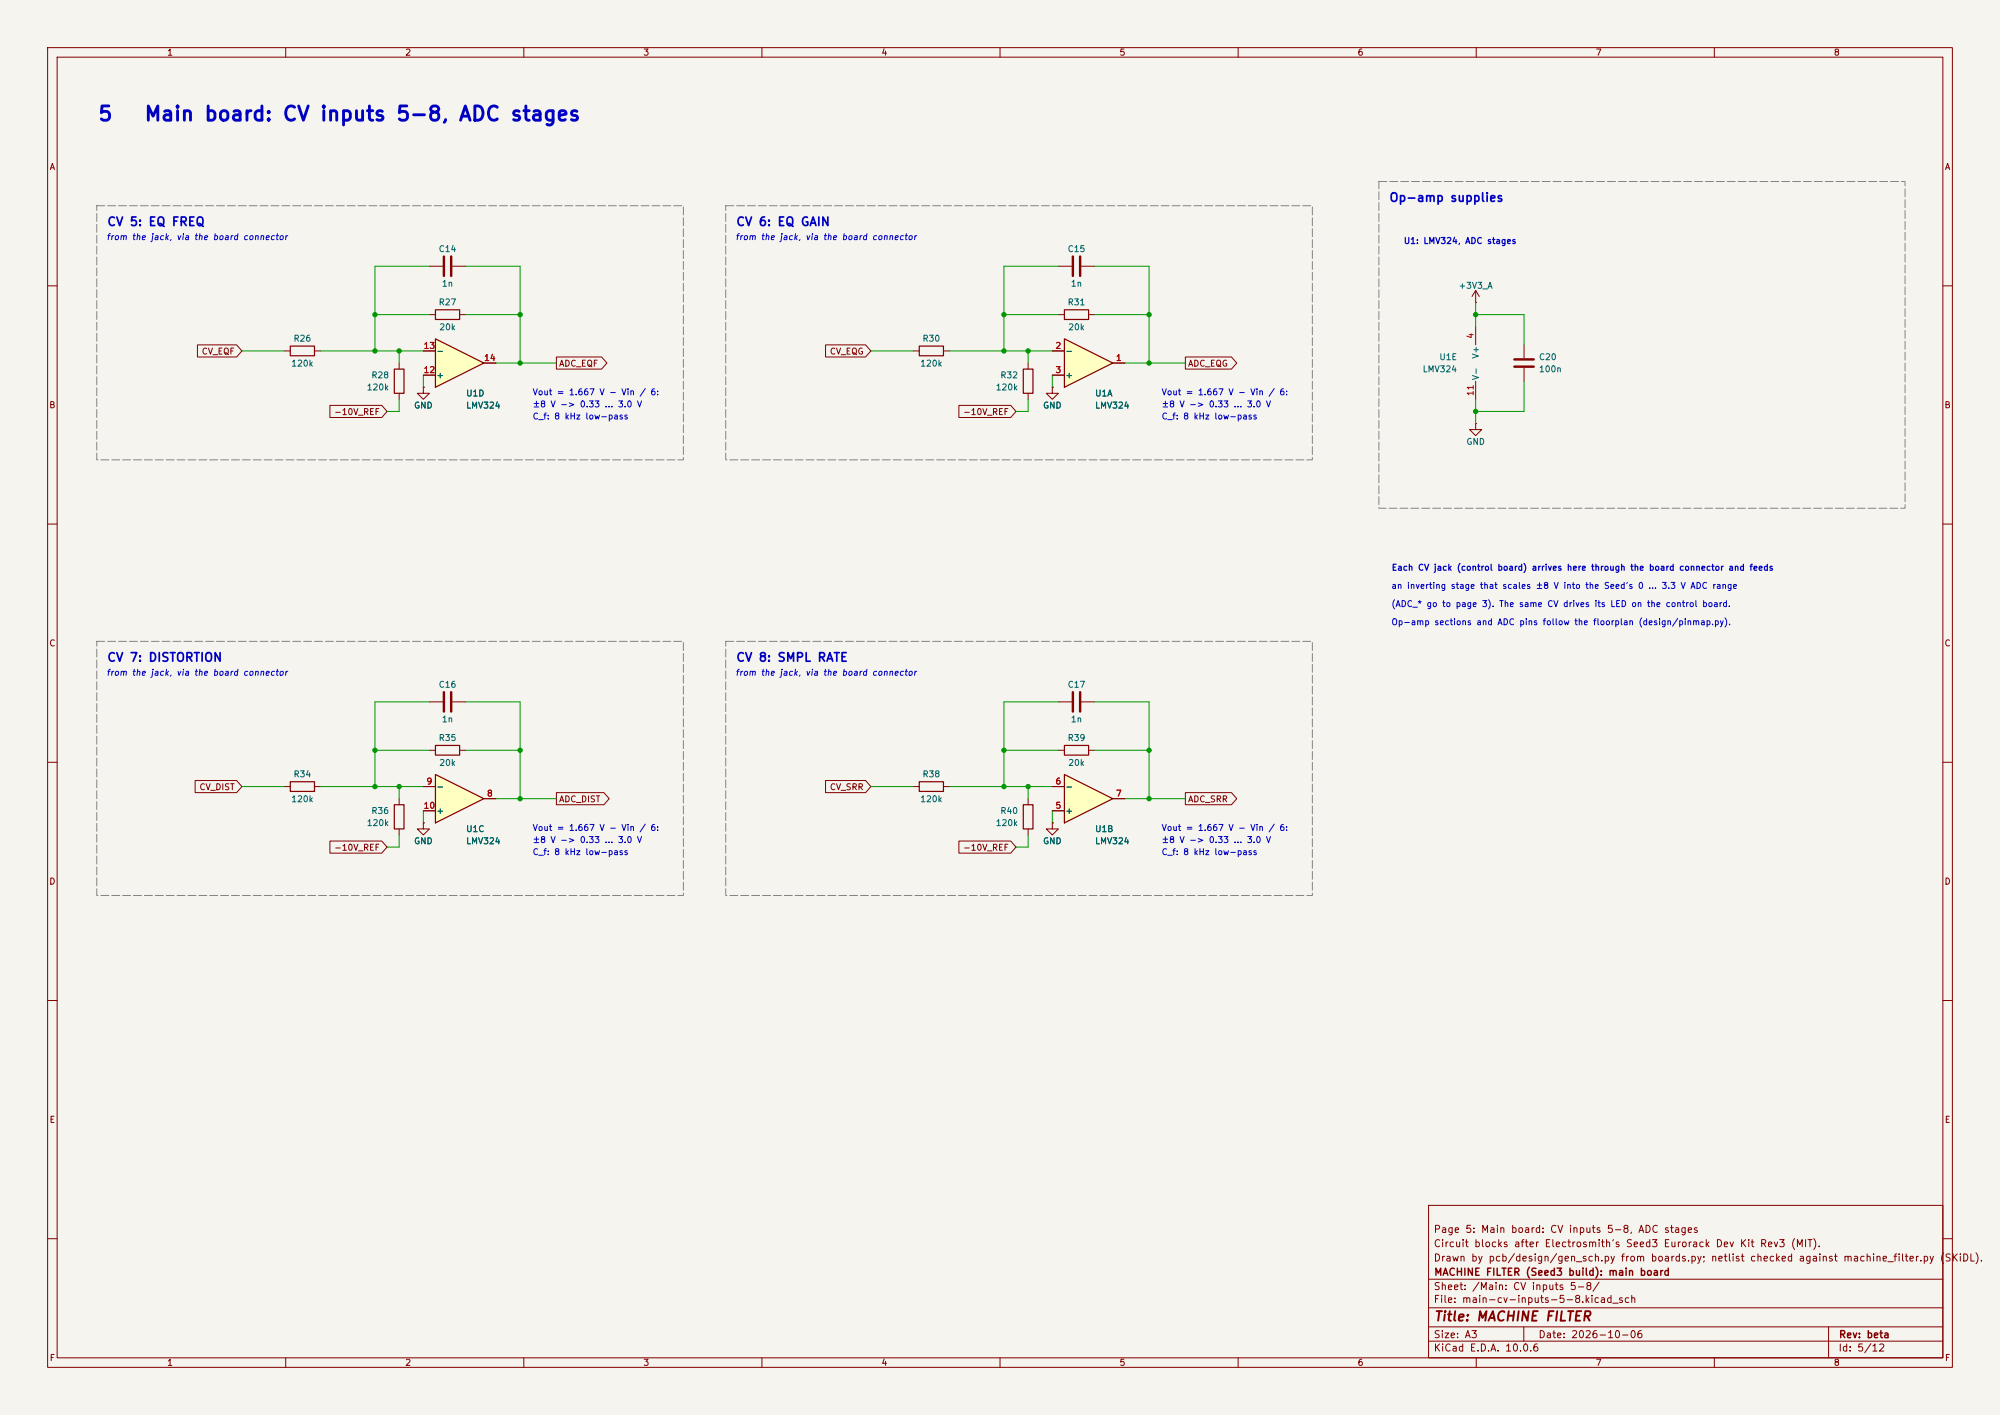
[picture p17: page 5]

from the jack, via the board connector CV 5: EQ FREQ

from the jack, via the board connector

(ADC_* go to page 3). The same CV drives its LED on the control board. an inverting stage that scales ±8 V into the Seed's 0 ... 3.3 V ADC range Each CV jack (control board) arrives here through the board connector and feeds C_f: 8 kHz low-pass

Page 5: Main board: CV inputs 5-8, ADC stages
Circuit blocks after Electrosmith's Seed3 Eurorack Dev Kit Rev3 (MIT).
Drawn by pcb/design/gen_sch.py from boards.py; netlist checked against machine_filter.py (SKiDL).
MACHINE FILTER (Seed3 build): main board
Sheet: /Main: CV inputs 5-8/
File: main-cv-inputs-5-8.kicad_sch

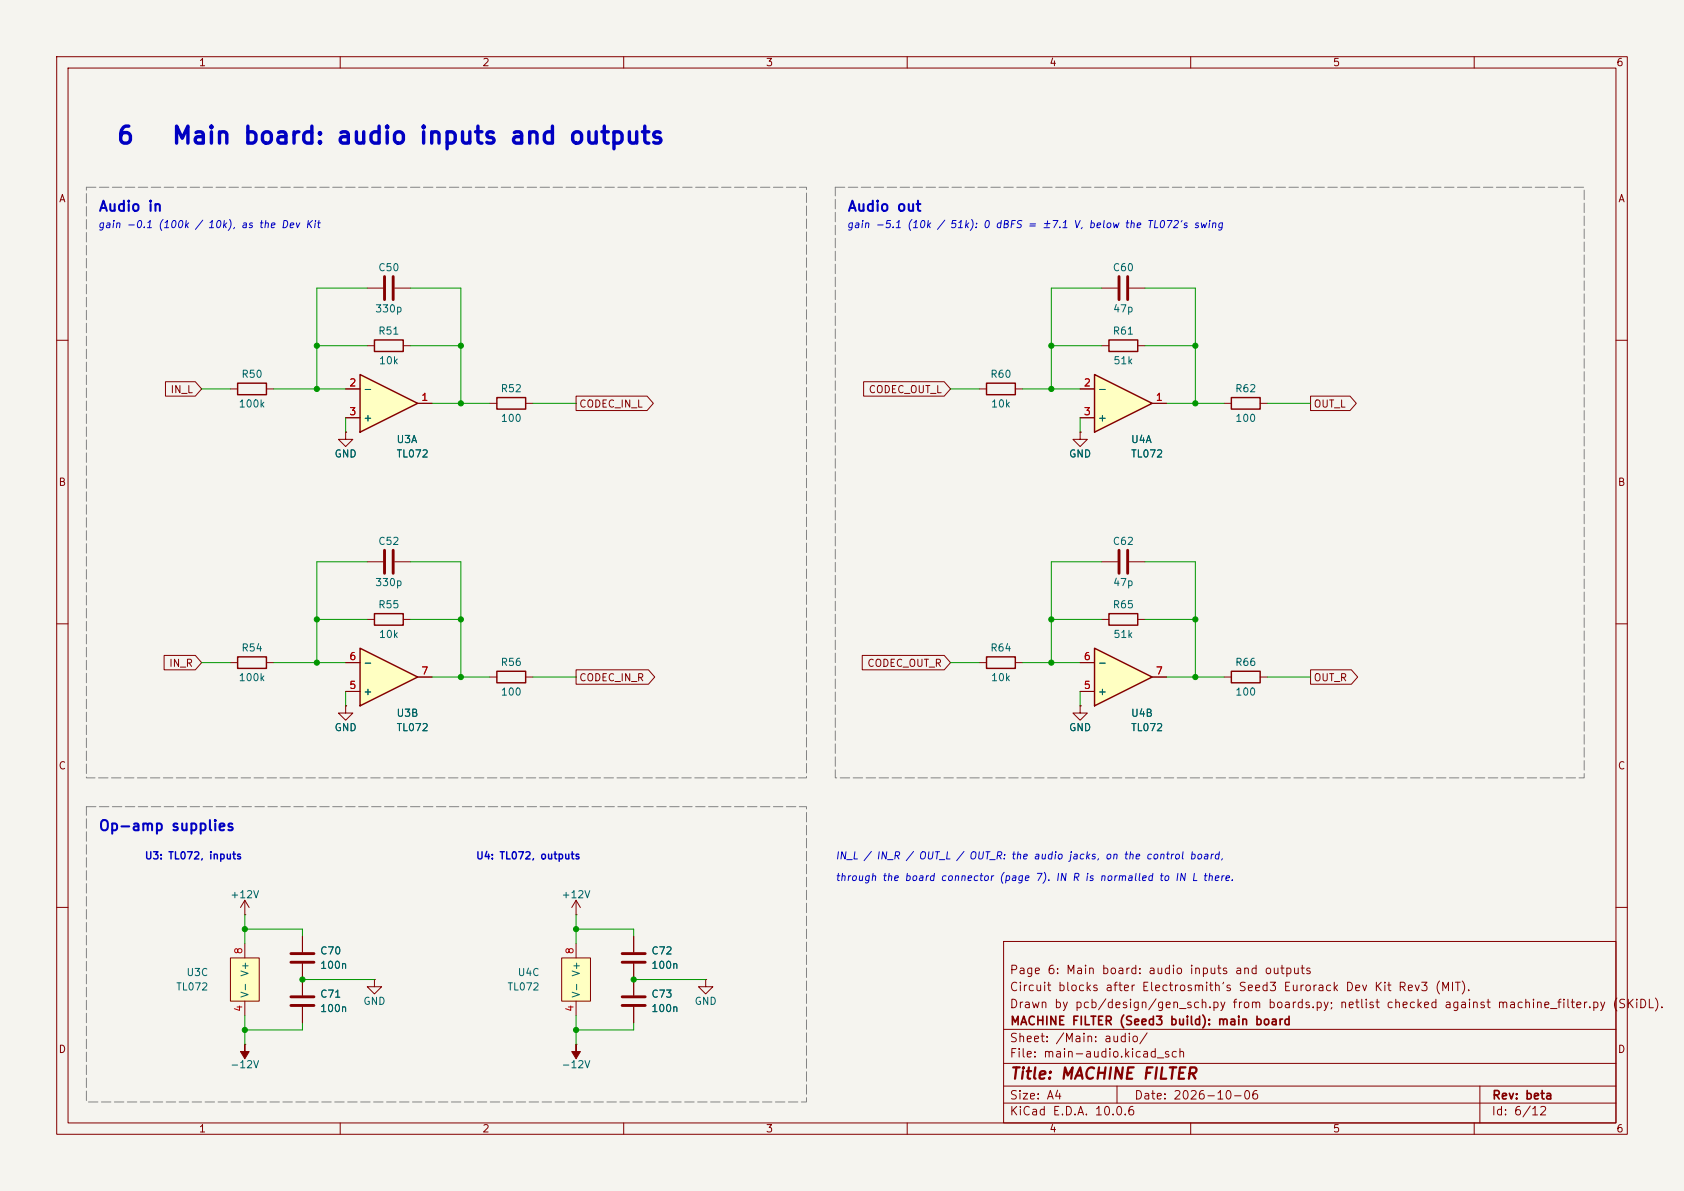
[picture p18: page 6]

gain -0.1 (100k / 10k), as the Dev Kit Audio in

Audio out
gain -5.1 (10k / 51k): 0 dBFS = ±7.1 V, below the TL072's swing

Op-amp supplies U3: TL072, inputs | U4: TL072, outputs

IN_L / IN_R / OUT_L / OUT_R: the audio jacks, on the control board,

through the board connector (page 7). IN R is normalled to IN L there.

Page 6: Main board: audio inputs and outputs GND

Circuit blocks after Electrosmith's Seed3 Eurorack Dev Kit Rev3 (MIT).
Drawn by pcb/design/gen_sch.py from boards.py; netlist checked against machine_filter.py (SKiDL).
MACHINE FILTER (Seed3 build): main board
Sheet: /Main: audio/
File: main-audio.kicad_sch
Title: MACHINE FILTER

Size: A4 | Rev: beta

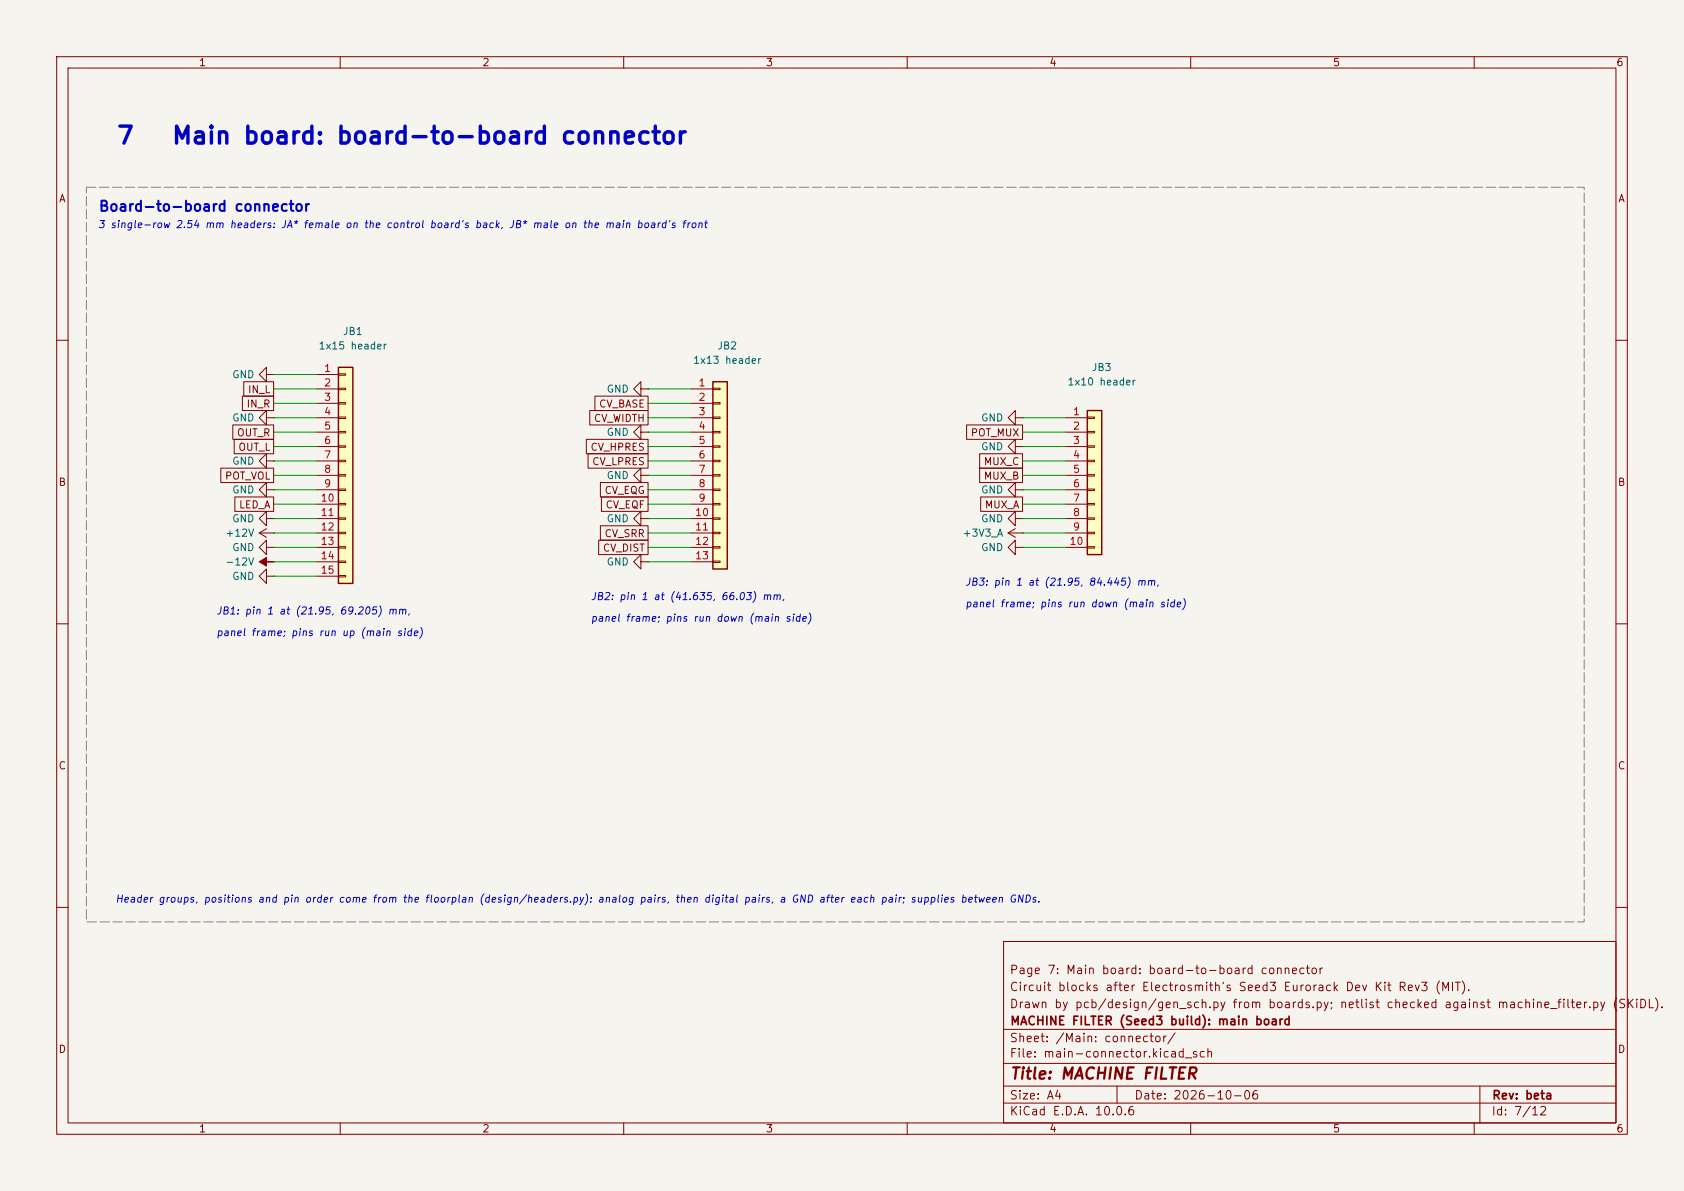
[picture p19: page 7]

JB1: pin 1 at (21.95, 69.205) mm, panel frame; pins run up (main side)

Page 7: Main board: board-to-board connector
Circuit blocks after Electrosmith's Seed3 Eurorack Dev Kit Rev3 (MIT).
Drawn by pcb/design/gen_sch.py from boards.py; netlist checked against machine_filter.py (SKiDL).
MACHINE FILTER (Seed3 build): main board
Sheet: /Main: connector/
File: main-connector.kicad_sch
Title: MACHINE FILTER

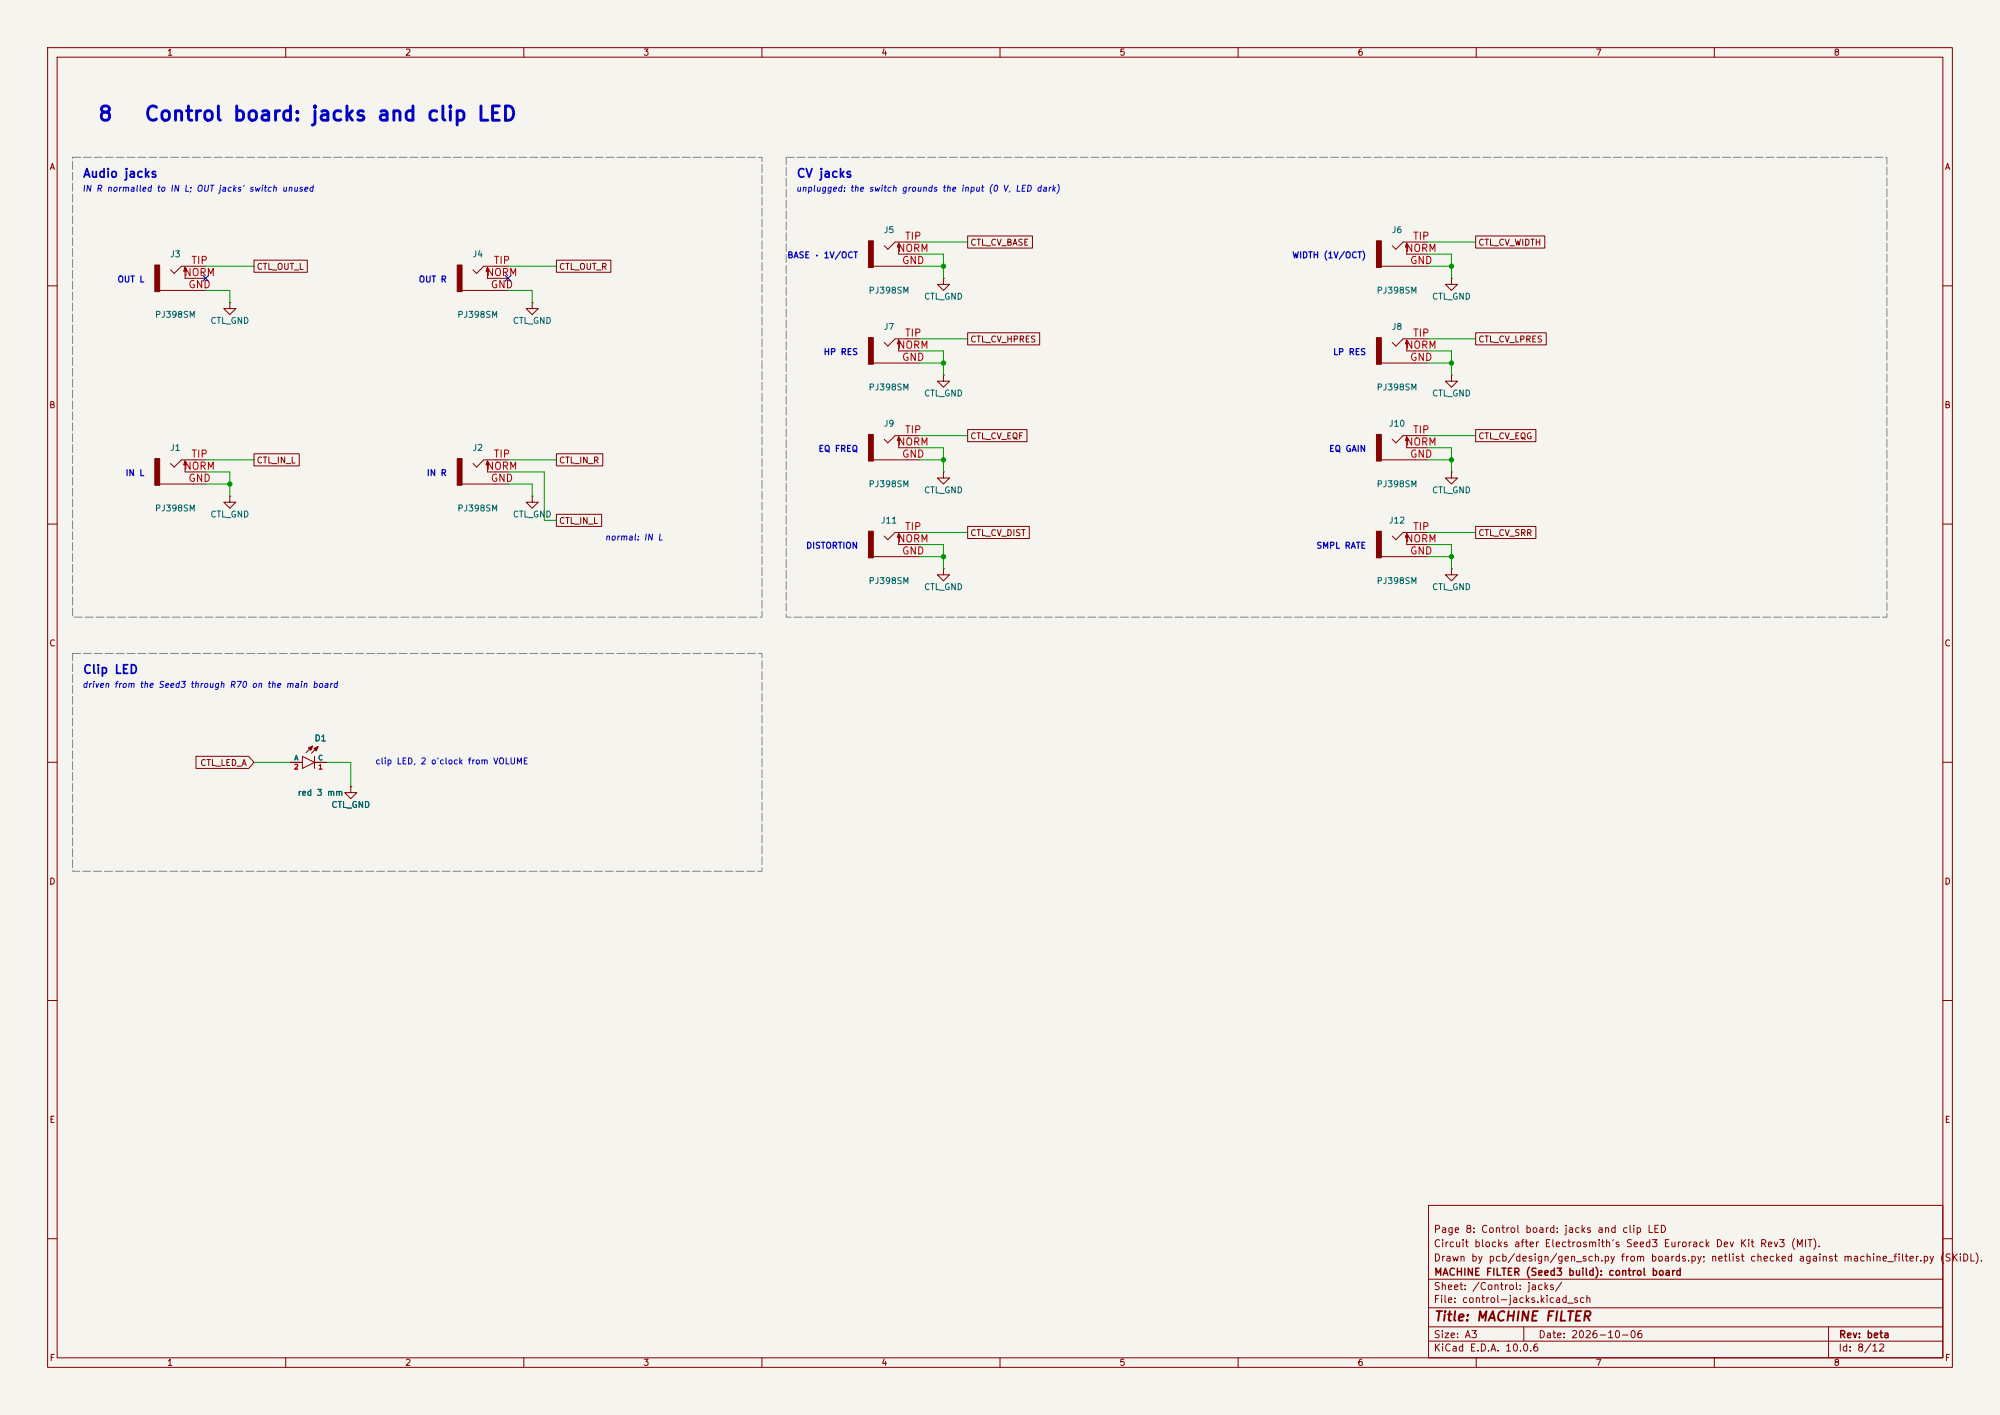
[picture p20: page 8]

unplugged: the switch grounds the input (0 V, LED dark) BASE · 1V/OCT

normal: IN L clip LED, 2 o'clock from VOLUME Clip LED

driven from the Seed3 through R70 on the main board

Page 8: Control board: jacks and clip LED
Circuit blocks after Electrosmith's Seed3 Eurorack Dev Kit Rev3 (MIT).
Drawn by pcb/design/gen_sch.py from boards.py; netlist checked against machine_filter.py (SKiDL).
MACHINE FILTER (Seed3 build): control board
Sheet: /Control: jacks/
File: control-jacks.kicad_sch

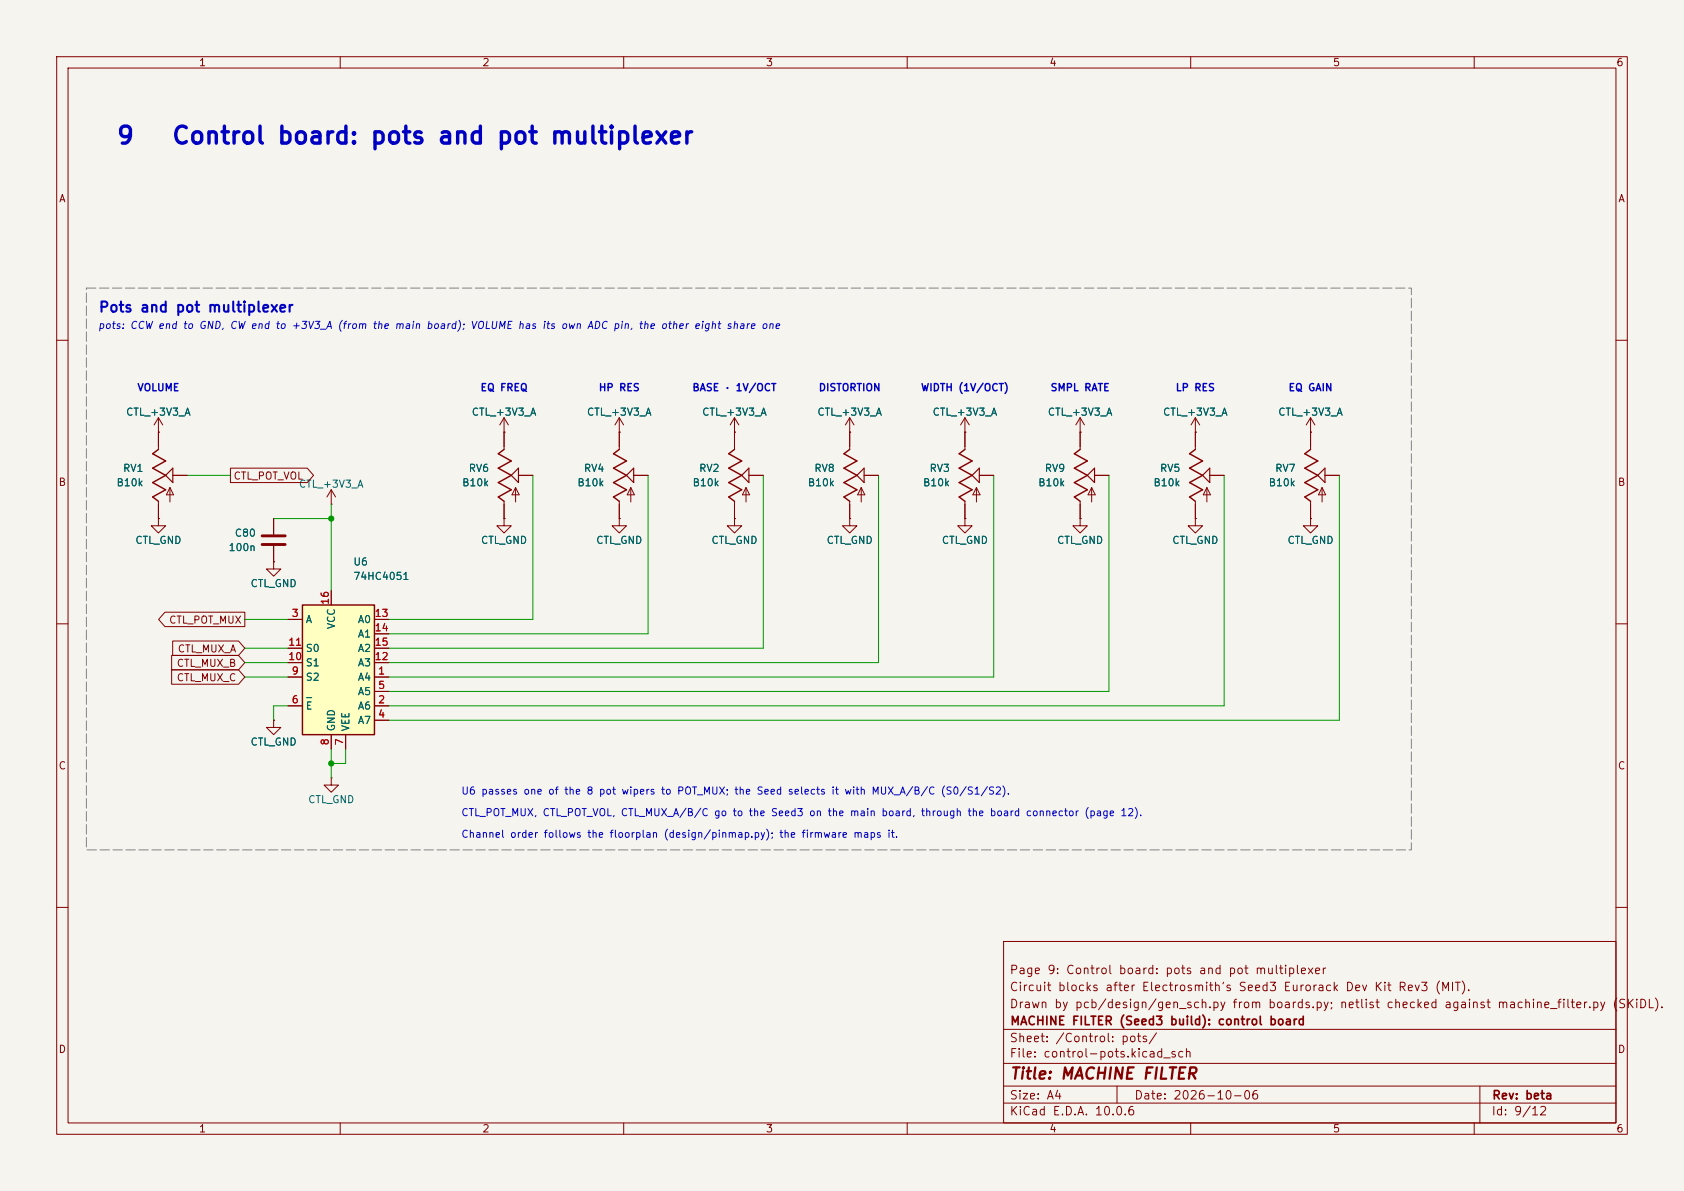
[picture p21: page 9]

CTL_POT_MUX, CTL_POT_VOL, CTL_MUX_A/B/C go to the Seed3 on the main board, through the board connector (page 12). DISTORTION

Channel order follows the floorplan (design/pinmap.py); the firmware maps it. U6

Page 9: Control board: pots and pot multiplexer
Circuit blocks after Electrosmith's Seed3 Eurorack Dev Kit Rev3 (MIT).
Drawn by pcb/design/gen_sch.py from boards.py; netlist checked against machine_filter.py (SKiDL).
MACHINE FILTER (Seed3 build): control board
Sheet: /Control: pots/
File: control-pots.kicad_sch
Title: MACHINE FILTER

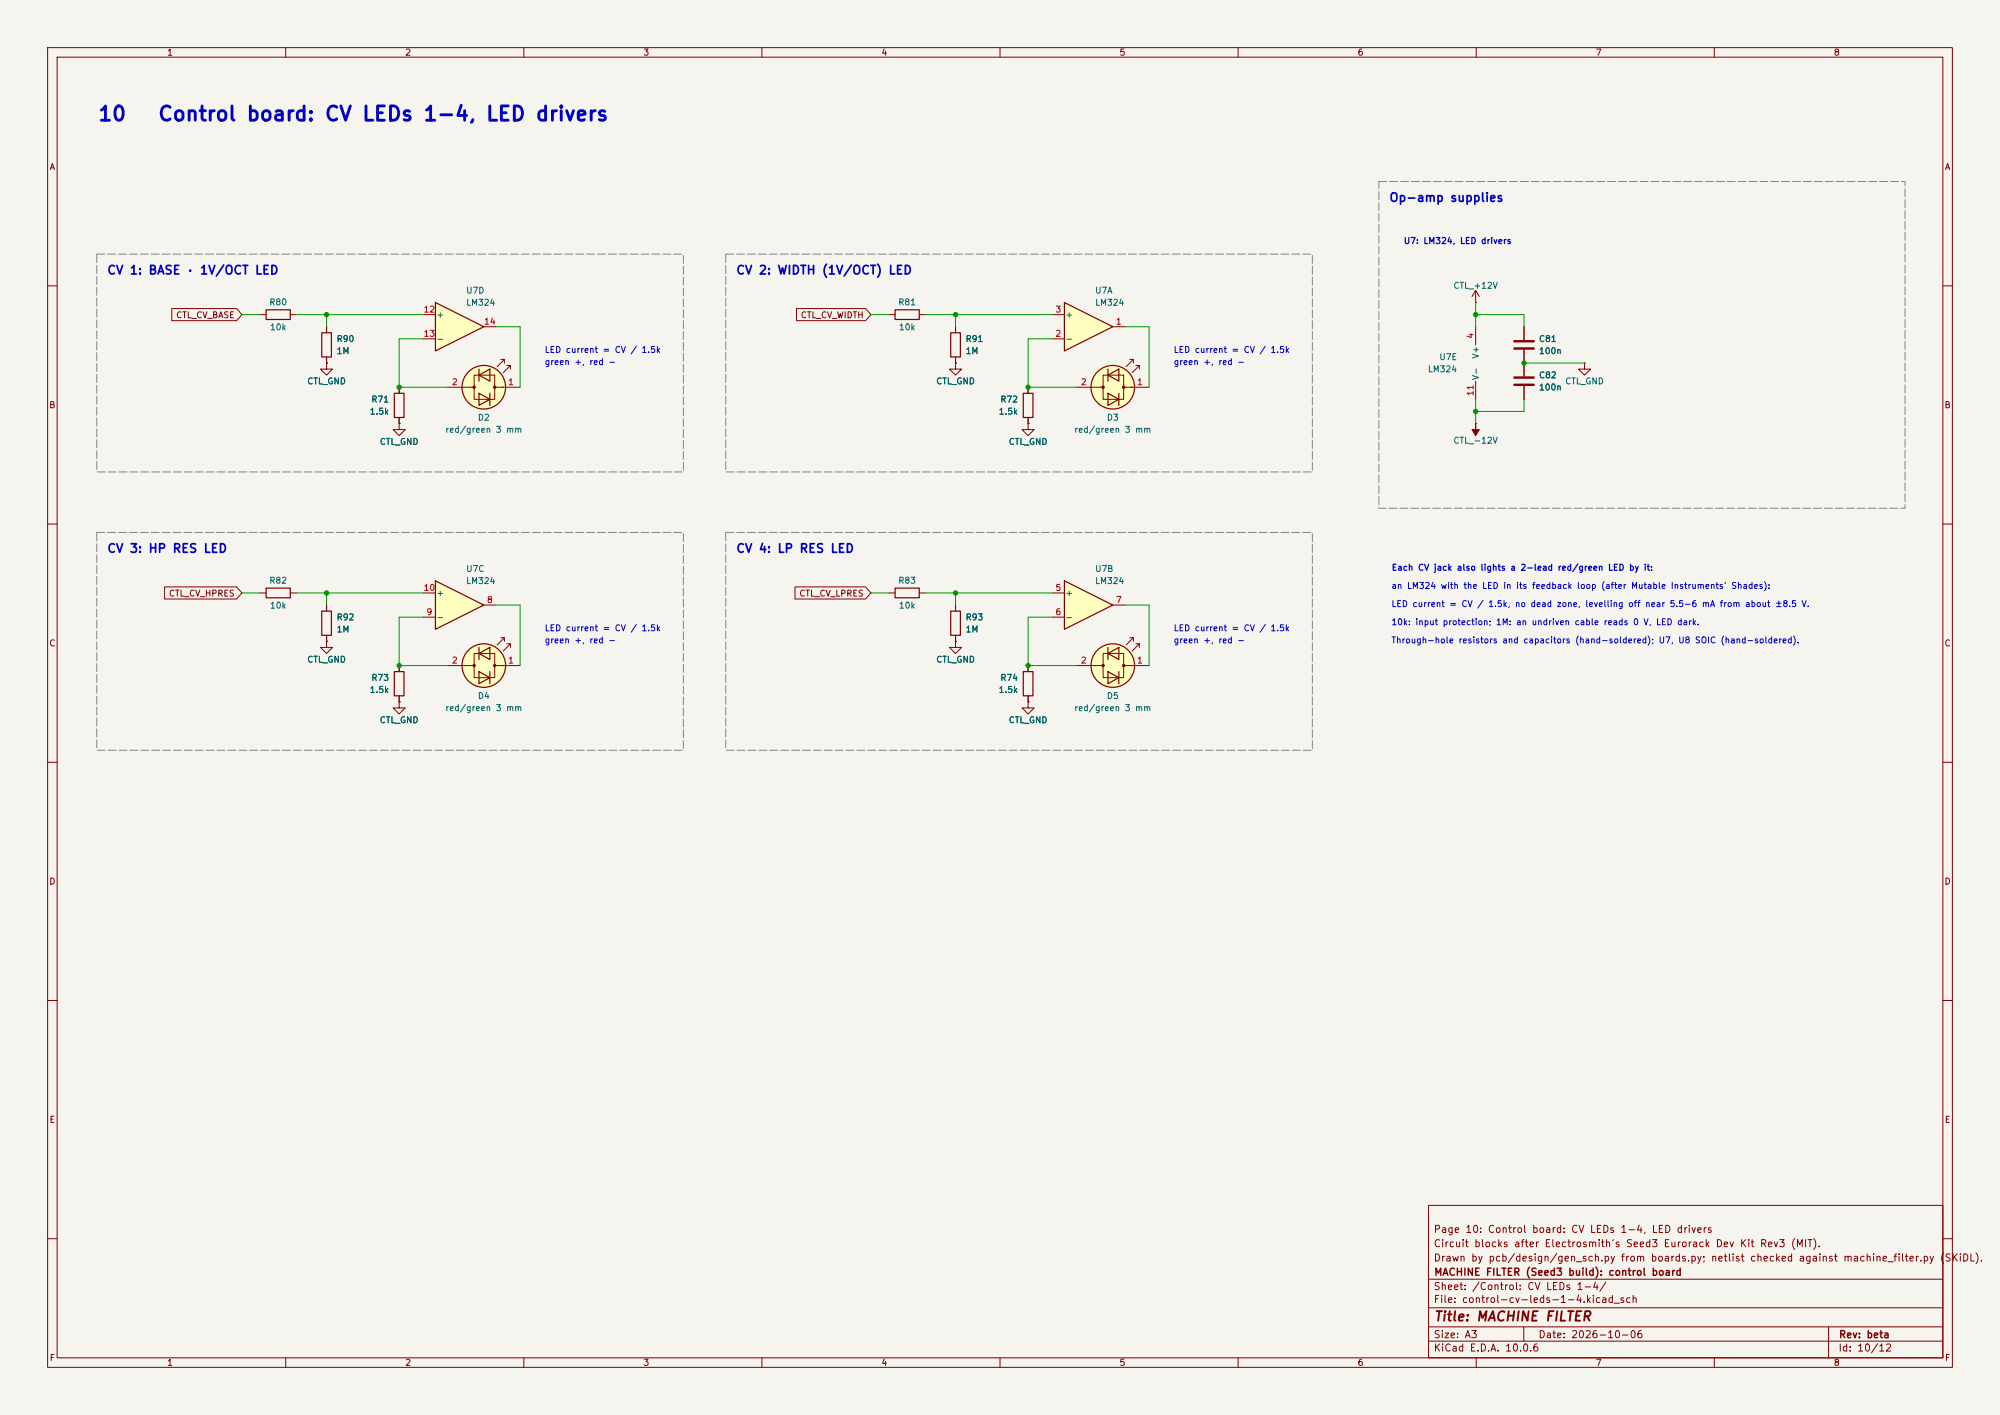
[picture p22: page 10]

U7: LM324, LED drivers Each CV jack also lights a 2-lead red/green LED by it: an LM324 with the LED in its feedback loop (after Mutable Instruments' Shades): LED current = CV / 1.5k, no dead zone, levelling off near 5.5-6 mA from about ±8.5 V. 10k: input protection; 1M: an undriven cable reads 0 V, LED dark. Through-hole resistors and capacitors (hand-soldered); U7, U8 SOIC (hand-soldered). LED current = CV / 1.5k CTL_GND

LED current = CV / 1.5k CV 1: BASE · 1V/OCT LED

LED current = CV / 1.5k green +, red - CV 2: WIDTH (1V/OCT) LED

CV 3: HP RES LED

CV 4: LP RES LED

Page 10: Control board: CV LEDs 1-4, LED drivers
Circuit blocks after Electrosmith's Seed3 Eurorack Dev Kit Rev3 (MIT).
Drawn by pcb/design/gen_sch.py from boards.py; netlist checked against machine_filter.py (SKiDL).
MACHINE FILTER (Seed3 build): control board
Sheet: /Control: CV LEDs 1-4/
File: control-cv-leds-1-4.kicad_sch

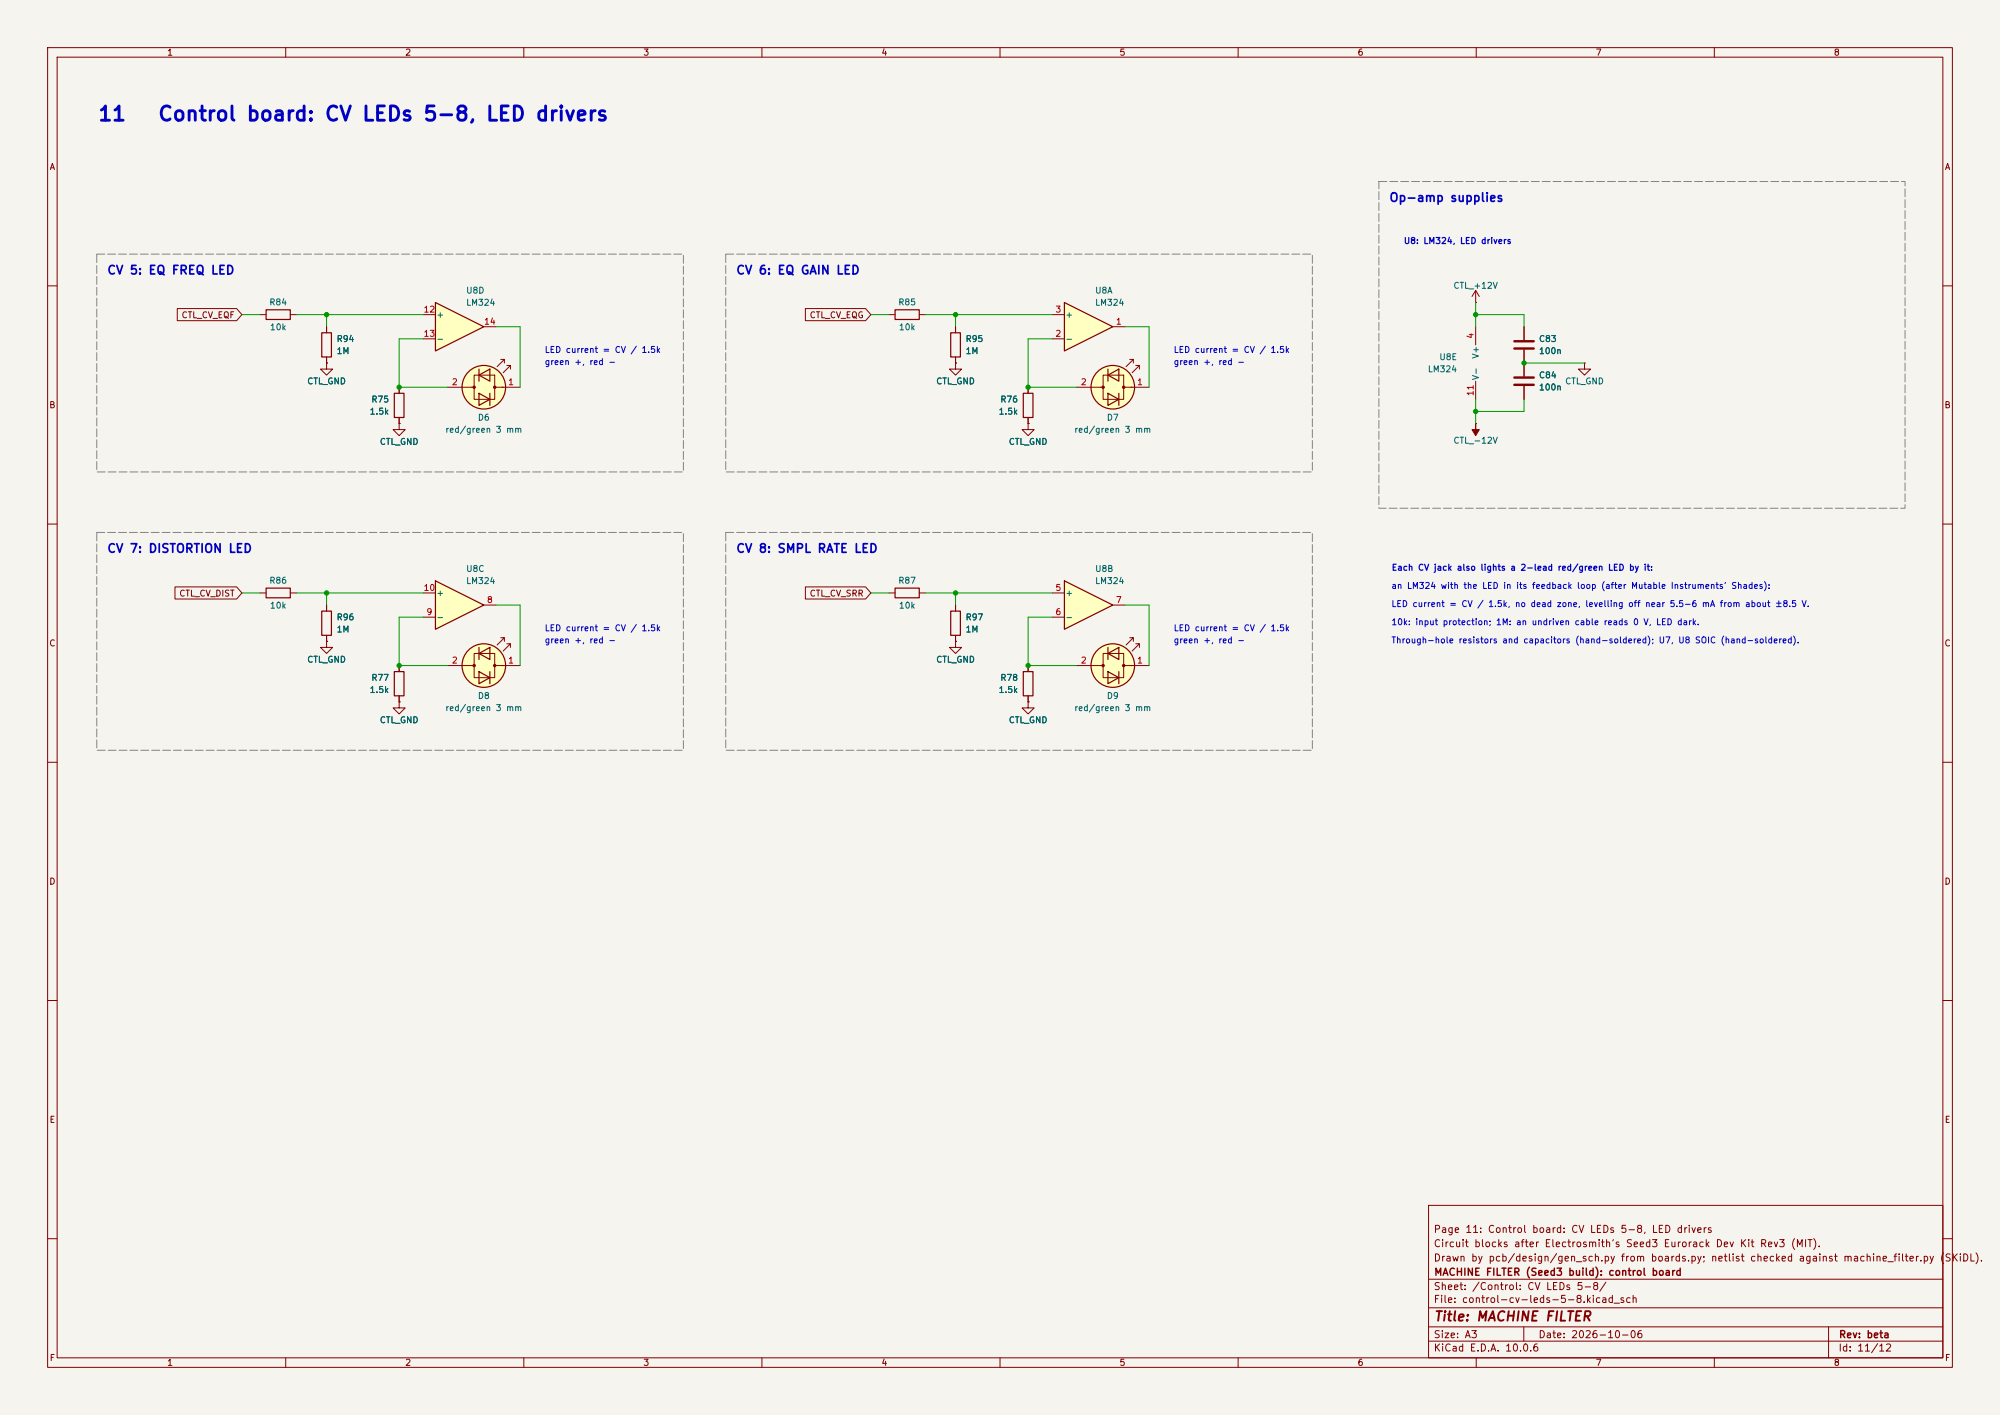
[picture p23: page 11]

U8: LM324, LED drivers Each CV jack also lights a 2-lead red/green LED by it: an LM324 with the LED in its feedback loop (after Mutable Instruments' Shades): LED current = CV / 1.5k, no dead zone, levelling off near 5.5-6 mA from about ±8.5 V. 10k: input protection; 1M: an undriven cable reads 0 V, LED dark. Through-hole resistors and capacitors (hand-soldered); U7, U8 SOIC (hand-soldered). LED current = CV / 1.5k CTL_GND

LED current = CV / 1.5k CV 5: EQ FREQ LED

LED current = CV / 1.5k green +, red - CV 6: EQ GAIN LED

CV 8: SMPL RATE LED

Page 11: Control board: CV LEDs 5-8, LED drivers
Circuit blocks after Electrosmith's Seed3 Eurorack Dev Kit Rev3 (MIT).
Drawn by pcb/design/gen_sch.py from boards.py; netlist checked against machine_filter.py (SKiDL).
MACHINE FILTER (Seed3 build): control board
Sheet: /Control: CV LEDs 5-8/
File: control-cv-leds-5-8.kicad_sch

1 | 2 | 3 | 4 | 5 | 6
1 | 2 | 3 | 4 | 5 | 6

AB

C

D

AB

C

### D Date: 2026-10-06

Size: A4 | Rev: beta

## Title: MACHINE FILTER

### File: control-connector.kicad_sch

### Sheet: /Control: connector/

## MACHINE FILTER (Seed3 build): control board

Drawn by pcb/design/gen_sch.py from boards.py; netlist checked against machine_filter.py (SKiDL).

Circuit blocks after Electrosmith's Seed3 Eurorack Dev Kit Rev3 (MIT).

### Page 12: Control board: board-to-board connector CTL_GND

CTL_GND

CTL_-12V | 1
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
| 10
| 11
| 12
| 13
| 14
| 15

JA1
1x15 socket CTL_+12V PWR_FLAG

CTL_GND

CTL_GND

PWR_FLAG

CTL_-12V | CTL_GND
CTL_+3V3_A CTL_+12V | CTL_GND

CTL_GND

CTL_GND

CTL_GND

CTL_GND

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
1x10 socket CTL_GND

CTL_GND

CTL_GND
CTL_GND

CTL_GND

PWR_FLAG

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
# 1x13 socket PWR_FLAG

CTL_GND

CTL_GND

CTL_GND

CTL_+3V3_A CTL_CV_EQG

CTL_MUX_A CTL_CV_WIDTH

CTL_POT_MUX CTL_CV_BASE | CTL_MUX_B

CTL_MUX_C

CTL_LED_A CTL_OUT_L CTL_OUT_R

CTL_IN_R

CTL_IN_L CTL_POT_VOL | CTL_CV_DIST CTL_CV_SRR
CTL_CV_HPRES CTL_CV_LPRES CTL_CV_EQF panel frame; pins run up (main side) | JA2: pin 1 at (41.635, 66.03) mm, panel frame; pins run down (main side)

panel frame; pins run down (main side)

Supplies from the main board (PWR_FLAG: driven through the connector) | JA3: pin 1 at (21.95, 84.445) mm, JA1: pin 1 at (21.95, 69.205) mm, Board-to-board connector Header groups, positions and pin order come from the floorplan (design/headers.py): analog pairs, then digital pairs, a GND after each pair; supplies between GNDs. 12 | Control board: board-to-board connector

3 single-row 2.54 mm headers: JA* female on the control board's back, JB* male on the main board's front
