daaaaaaaaaniel/claude-schematic-monomachine-workflow/pcb/machine-filter/machine-filter.kicad_pcb

## KiCad design pcb/machine-filter/machine-filter.kicad_pcb (2026-10-06)

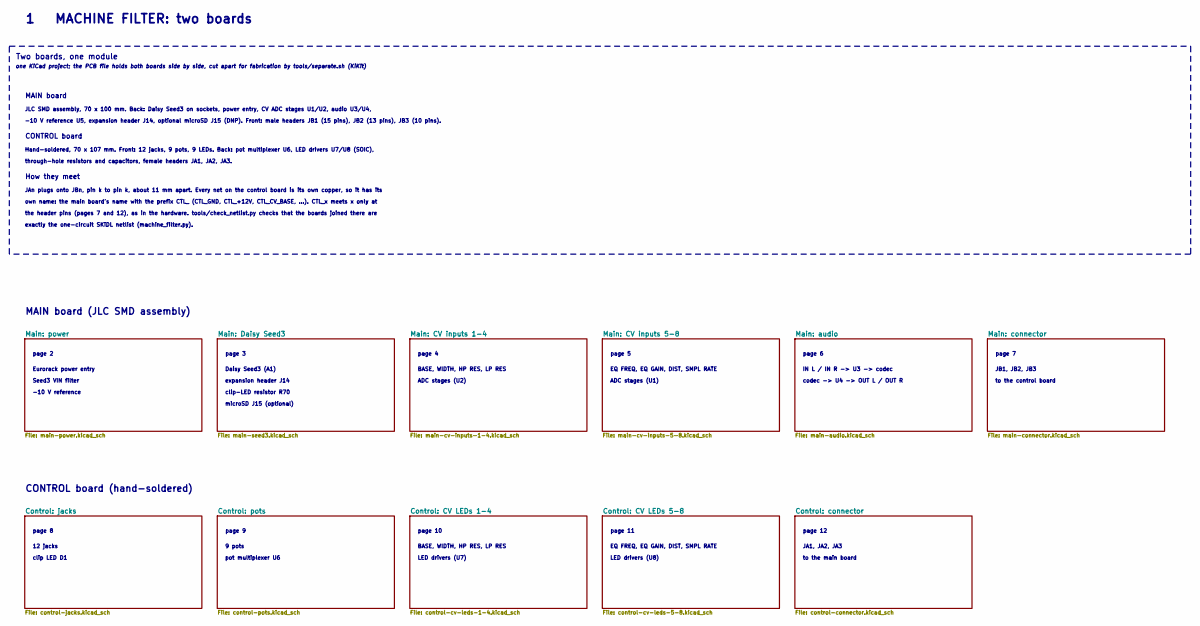
[picture p24: schematic machine-filter.kicad_sch, MACHINE FILTER]

Notes on the sheet:
Two boards, one module
one KiCad project; the PCB file holds both boards side by side, cut apart for fabrication by tools/separate.sh (KiKit)
MAIN board
JLC SMD assembly, 70 x 100 mm. Back: Daisy Seed3 on sockets, power entry, CV ADC stages U1/U2, audio U3/U4,
-10 V reference U5, expansion header J14, optional microSD J15 (DNP). Front: male headers JB1 (15 pins), JB2 (13 pins), JB3 (10 pins).
CONTROL board
Hand-soldered, 70 x 107 mm. Front: 12 jacks, 9 pots, 9 LEDs. Back: pot multiplexer U6, LED drivers U7/U8 (SOIC),
through-hole resistors and capacitors, female headers JA1, JA2, JA3.
How they meet
JAn plugs onto JBn, pin k to pin k, about 11 mm apart. Every net on the control board is its own copper, so it has its
own name: the main board's name with the prefix CTL_ (CTL_GND, CTL_+12V, CTL_CV_BASE, ...). CTL_x meets x only at
the header pins (pages 7 and 12), as in the hardware. tools/check_netlist.py checks that the boards joined there are
exactly the one-circuit SKiDL netlist (machine_filter.py).
MAIN board (JLC SMD assembly)
page 2
Eurorack power entry
Seed3 VIN filter
-10 V reference
page 3
Daisy Seed3 (A1)
expansion header J14
clip-LED resistor R70
microSD J15 (optional)
page 4
BASE, WIDTH, HP RES, LP RES
ADC stages (U2)
page 5
EQ FREQ, EQ GAIN, DIST, SMPL RATE
ADC stages (U1)
page 6
IN L / IN R -> U3 -> codec
codec -> U4 -> OUT L / OUT R
page 7
JB1, JB2, JB3
to the control board
CONTROL board (hand-soldered)
page 8
12 jacks
clip LED D1
page 9
9 pots
pot multiplexer U6
page 10
LED drivers (U7)
page 11
LED drivers (U8)
page 12
JA1, JA2, JA3
to the main board
1 MACHINE FILTER: two boards

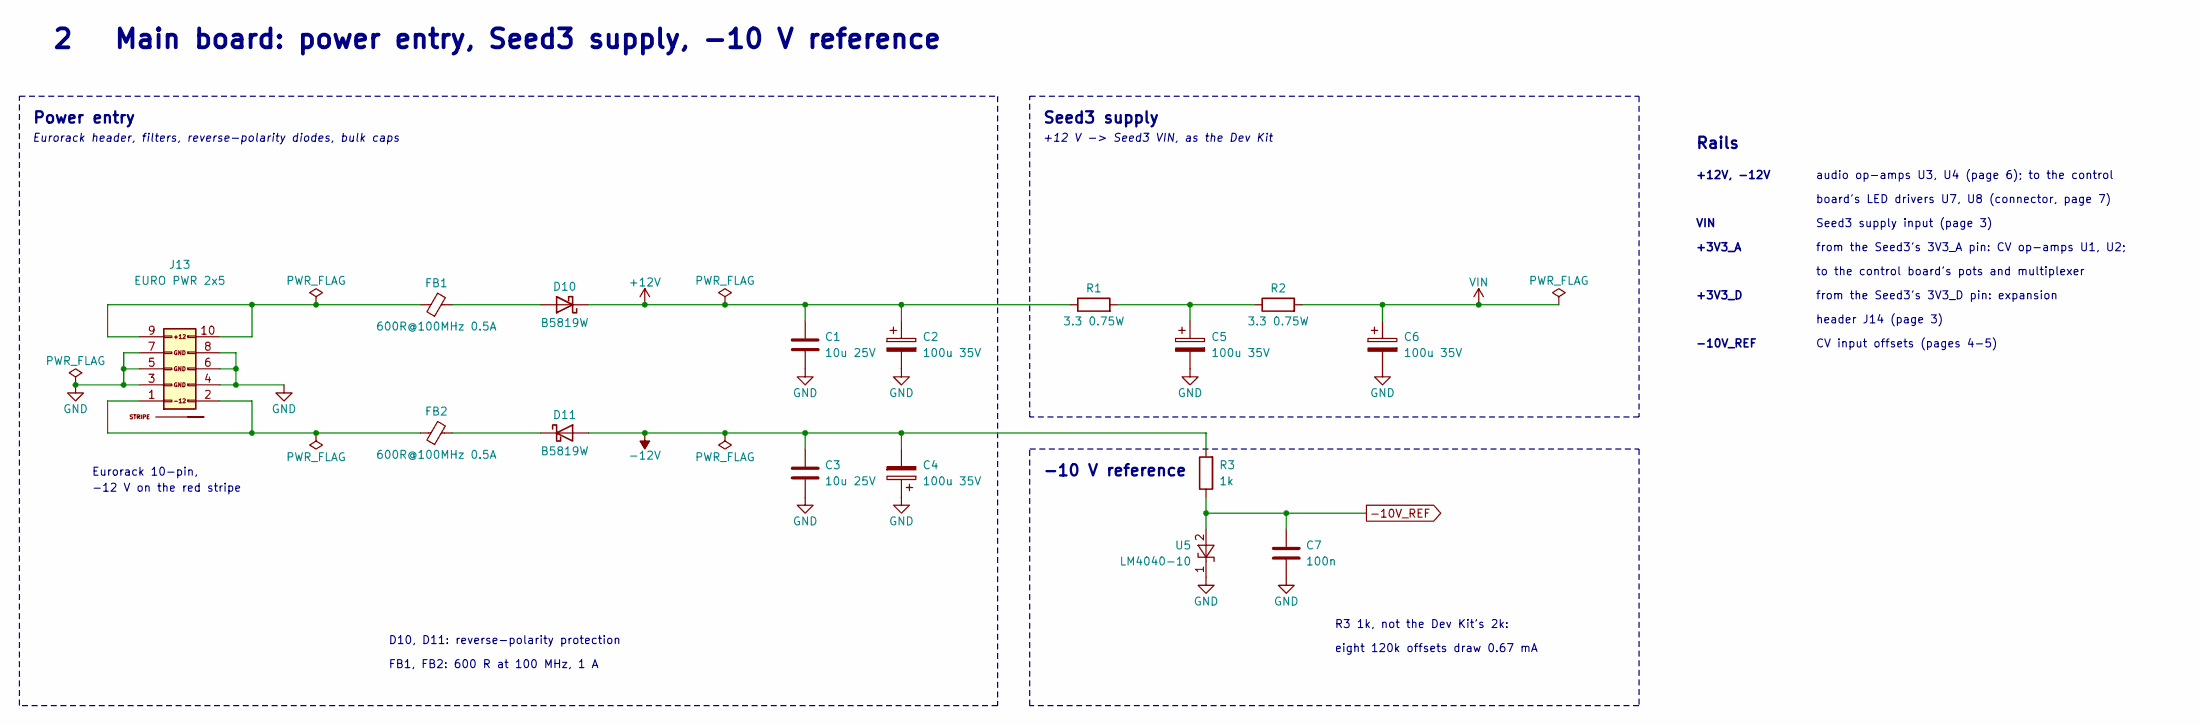
[picture p25: schematic main-power.kicad_sch, MACHINE FILTER]

Parts:
C1, C3: 10u 25V; C_0805; MPN CL21A106KAYNNNE; LCSC C15850
C2, C4, C5, C6: 100u 35V; CP_Elec_6.3x7.7; MPN RVT1V101M0607; LCSC C72478
C7: 100n; C_0603; MPN CC0603KRX7R9BB104; LCSC C14663
D10, D11: B5819W; D_SOD-123; MPN B5819W SL; LCSC C8598
FB1, FB2: 600R@100MHz 0.5A; R_0805_2012Metric; MPN GZ2012D601TF; LCSC C1017
J13: EURO PWR 2x5; Pins_2x05_2.54mm_TH_EurorackPower_Shrouded; MPN 2x5 2.54 mm shrouded box header
R1, R2: 3.3 0.75W; R_1206_3216Metric; MPN SG73P2BTTD3R30F; LCSC C2577888
R3: 1k; R_0603; MPN 0603WAF1001T5E; LCSC C21190
U5: LM4040-10; SOT-23; MPN LM4040C10IDBZR; LCSC C201738

Connections:
+12V: C1.1, C2.1, D10.1 (K), R1.1; also elsewhere on the board
-10V_REF: C7.1, R3.1, U5.2 (A); also elsewhere on the board
-12V: C3.2, C4.2, D11.2 (A), R3.2; also elsewhere on the board
GND: C1.2, C2.2, C3.1, C4.1, C5.2, C6.2, C7.2, J13.3 (GND), J13.4 (GND), J13.5 (GND), J13.6 (GND), J13.7 (GND), J13.8 (GND), U5.1 (K); also elsewhere on the board
unnamed: C5.1, R1.2, R2.1
unnamed: D10.2 (A), FB1.2
unnamed: D11.1 (K), FB2.2
unnamed: FB1.1, J13.9 (+12V), J13.10 (+12V)
unnamed: FB2.1, J13.1 (-12V), J13.2 (-12V)
VIN: C6.1, R2.2; also elsewhere on the board

Notes on the sheet:
Power entry
Eurorack header, filters, reverse-polarity diodes, bulk caps
Eurorack 10-pin,
-12 V on the red stripe
Seed3 supply
+12 V -> Seed3 VIN, as the Dev Kit
D10, D11: reverse-polarity protection
FB1, FB2: 600 R at 100 MHz, 1 A
-10 V reference
R3 1k, not the Dev Kit's 2k:
eight 120k offsets draw 0.67 mA
Rails
+12V, -12V
audio op-amps U3, U4 (page 6); to the control
board's LED drivers U7, U8 (connector, page 7)
VIN
Seed3 supply input (page 3)
+3V3_A
from the Seed3's 3V3_A pin: CV op-amps U1, U2;
to the control board's pots and multiplexer
+3V3_D
from the Seed3's 3V3_D pin: expansion
header J14 (page 3)
-10V_REF
CV input offsets (pages 4-5)
2 Main board: power entry, Seed3 supply, -10 V reference

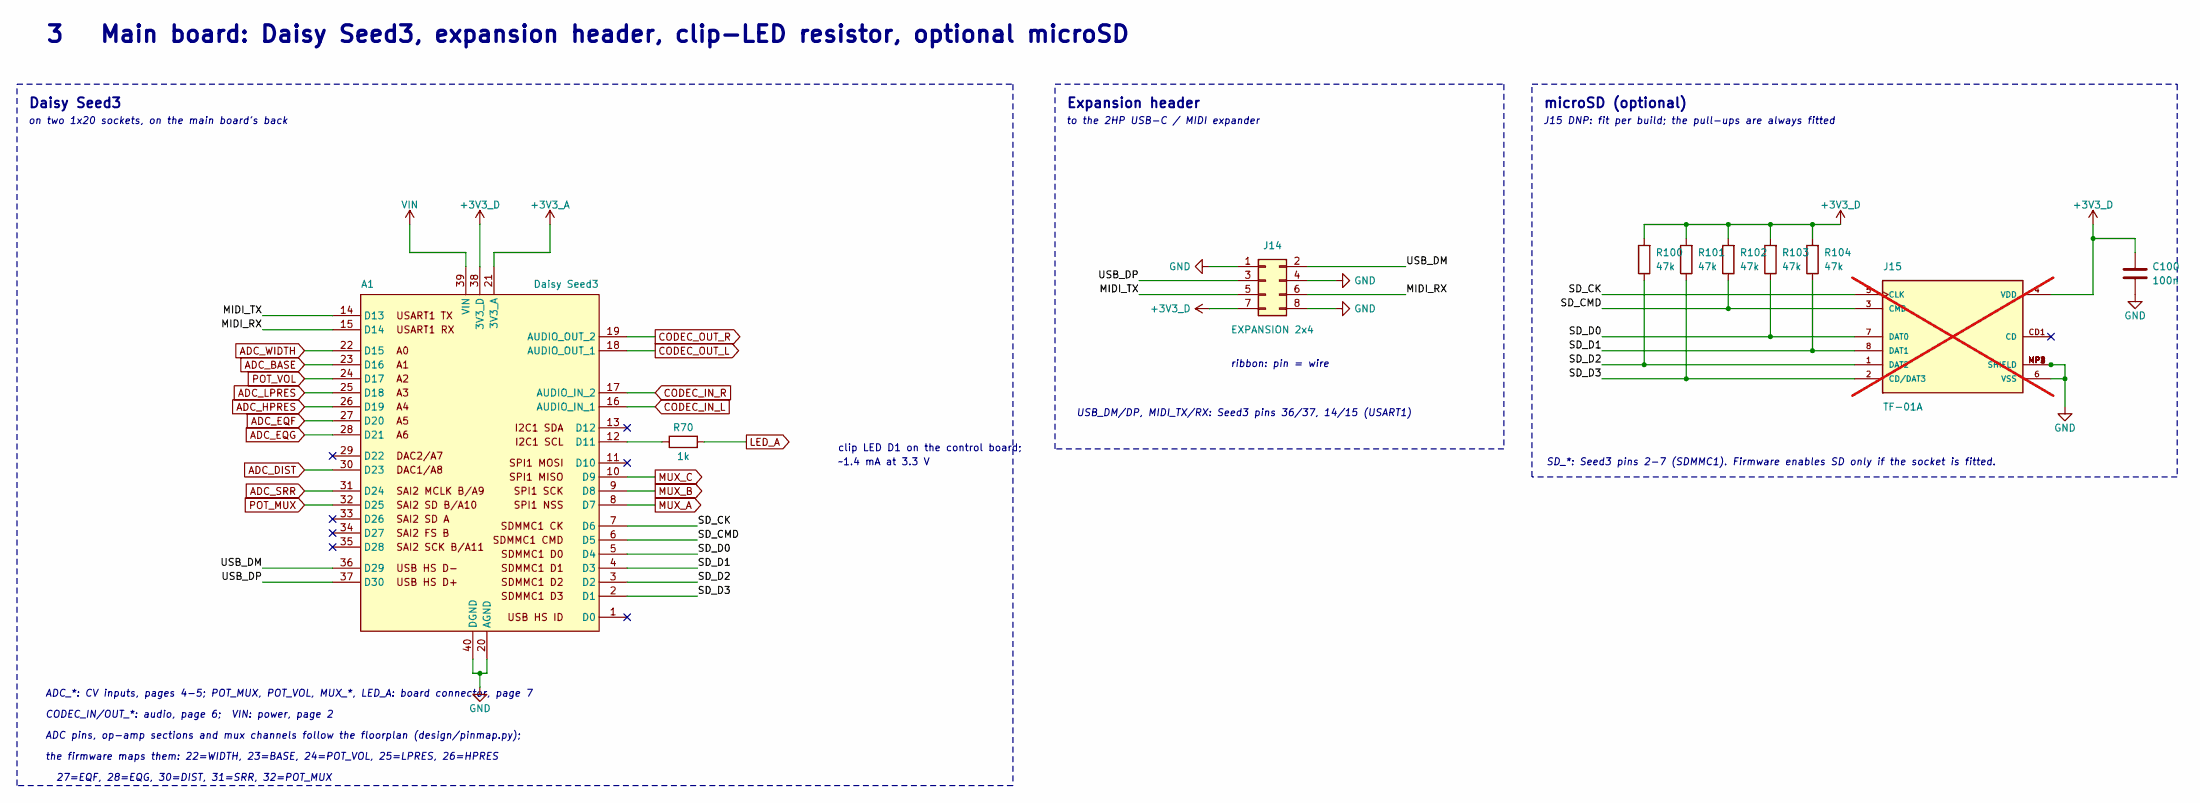
[picture p26: schematic main-seed3.kicad_sch, MACHINE FILTER]

Parts:
A1: Daisy Seed3; Daisy_Seed_ES_Sockets; MPN Electrosmith Daisy Seed3 on 2x 1x20 2.5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
C100: 100n; C_0603; MPN CC0603KRX7R9BB104; LCSC C14663
J14: EXPANSION 2x4; Pins_2x04_2.54mm_TH; MPN 2x4 2.54 mm pin header, unshrouded (d)
J15: TF-01A; MPN HRO TF-01A microSD socket, push-push (o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; LCSC C91145; not fitted
R70: 1k; R_0603; MPN 0603WAF1001T5E; LCSC C21190
R100, R101, R102, R103, R104: 47k; R_0603; MPN 0603WAF4702T5E; LCSC C25819

Connections:
+3V3_A: A1.21 (3V3_A); also elsewhere on the board
+3V3_D: A1.38 (3V3_D), C100.1, J14.7, J15.4 (VDD), R100.2, R101.2, R102.2, R103.2, R104.2
/Main: Daisy Seed3/MIDI_RX: A1.15 (D14), J14.6
/Main: Daisy Seed3/MIDI_TX: A1.14 (D13), J14.5
/Main: Daisy Seed3/SD_CK: A1.7 (D6), J15.5 (CLK)
/Main: Daisy Seed3/SD_CMD: A1.6 (D5), J15.3 (CMD), R102.1
/Main: Daisy Seed3/SD_D0: A1.5 (D4), J15.7 (DAT0), R103.1
/Main: Daisy Seed3/SD_D1: A1.4 (D3), J15.8 (DAT1), R104.1
/Main: Daisy Seed3/SD_D2: A1.3 (D2), J15.1 (DAT2), R100.1
/Main: Daisy Seed3/SD_D3: A1.2 (D1), J15.2 (CD/DAT3), R101.1
/Main: Daisy Seed3/USB_DM: A1.36 (D29), J14.2
/Main: Daisy Seed3/USB_DP: A1.37 (D30), J14.3
ADC_BASE: A1.23 (D16); also elsewhere on the board
ADC_DIST: A1.30 (D23); also elsewhere on the board
ADC_EQF: A1.27 (D20); also elsewhere on the board
ADC_EQG: A1.28 (D21); also elsewhere on the board
ADC_HPRES: A1.26 (D19); also elsewhere on the board
ADC_LPRES: A1.25 (D18); also elsewhere on the board
ADC_SRR: A1.31 (D24); also elsewhere on the board
ADC_WIDTH: A1.22 (D15); also elsewhere on the board
CODEC_IN_L: A1.16 (AUDIO_IN_1); also elsewhere on the board
CODEC_IN_R: A1.17 (AUDIO_IN_2); also elsewhere on the board
CODEC_OUT_L: A1.18 (AUDIO_OUT_1); also elsewhere on the board
CODEC_OUT_R: A1.19 (AUDIO_OUT_2); also elsewhere on the board
GND: A1.20 (AGND), A1.40 (DGND), C100.2, J14.1, J14.4, J14.8, J15.6 (VSS), J15.MP1 (SHIELD), J15.MP2 (SHIELD), J15.MP3 (SHIELD), J15.MP4 (SHIELD); also elsewhere on the board
LED_A: R70.2; also elsewhere on the board
MUX_A: A1.8 (D7); also elsewhere on the board
MUX_B: A1.9 (D8); also elsewhere on the board
MUX_C: A1.10 (D9); also elsewhere on the board
unnamed: A1.12 (D11), R70.1
POT_MUX: A1.32 (D25); also elsewhere on the board
POT_VOL: A1.24 (D17); also elsewhere on the board
VIN: A1.39 (VIN); also elsewhere on the board

Notes on the sheet:
Daisy Seed3
on two 1x20 sockets, on the main board's back
clip LED D1 on the control board;
~1.4 mA at 3.3 V
ADC_*: CV inputs, pages 4-5; POT_MUX, POT_VOL, MUX_*, LED_A: board connector, page 7
CODEC_IN/OUT_*: audio, page 6; VIN: power, page 2
ADC pins, op-amp sections and mux channels follow the floorplan (design/pinmap.py);
the firmware maps them: 22=WIDTH, 23=BASE, 24=POT_VOL, 25=LPRES, 26=HPRES
27=EQF, 28=EQG, 30=DIST, 31=SRR, 32=POT_MUX
Expansion header
to the 2HP USB-C / MIDI expander
ribbon: pin = wire
USB_DM/DP, MIDI_TX/RX: Seed3 pins 36/37, 14/15 (USART1)
microSD (optional)
J15 DNP: fit per build; the pull-ups are always fitted
SD_*: Seed3 pins 2-7 (SDMMC1). Firmware enables SD only if the socket is fitted.
3 Main board: Daisy Seed3, expansion header, clip-LED resistor, optional microSD

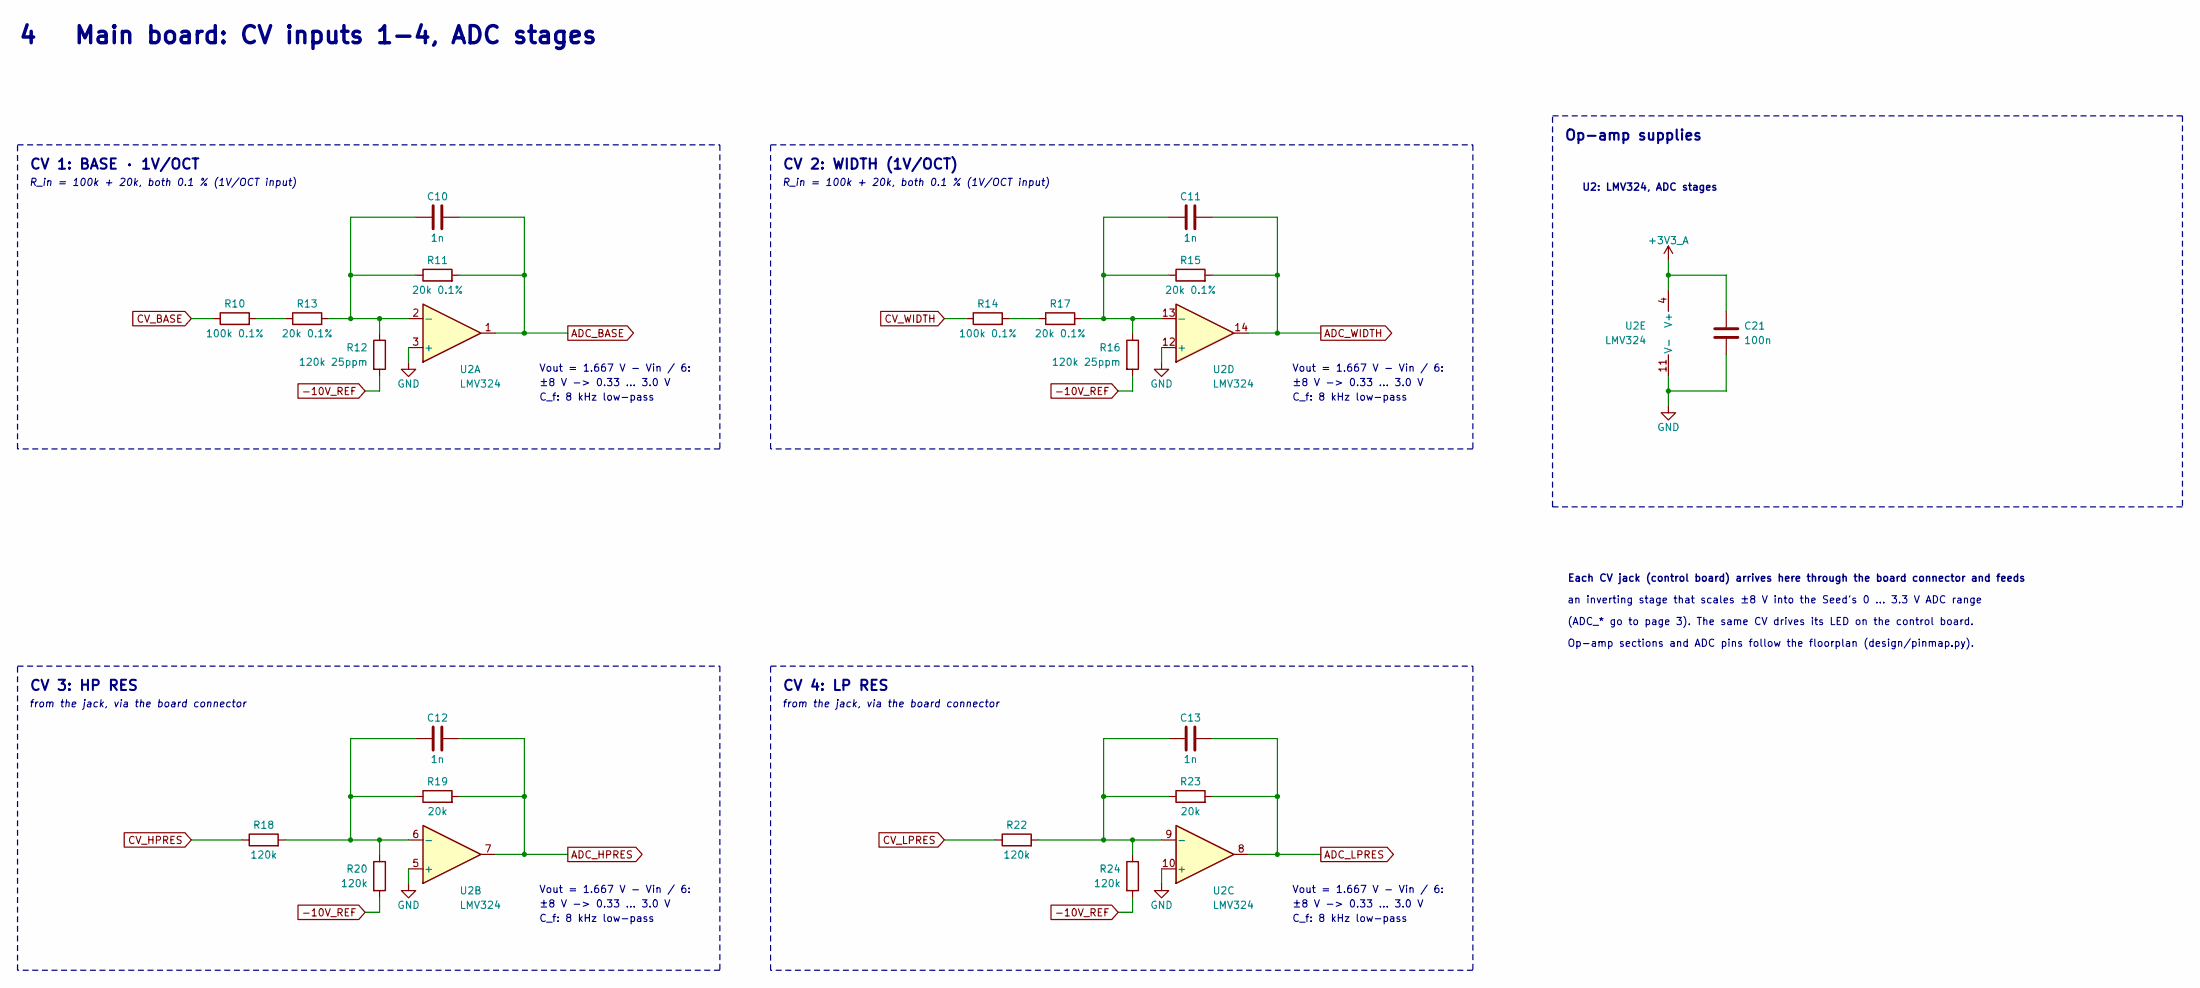
[picture p27: schematic main-cv-inputs-1-4.kicad_sch, MACHINE FILTER]

Parts:
C10, C11, C12, C13: 1n; C_0603; MPN CL10B102KB8NNNC; LCSC C1588
C21: 100n; C_0603; MPN CC0603KRX7R9BB104; LCSC C14663
R10, R14: 100k 0.1%; R_0603; MPN RT0603BRD07100KL; LCSC C122538
R11, R13, R15, R17: 20k 0.1%; R_0603; MPN RT0603BRD0720KL; LCSC C723637
R12, R16: 120k 25ppm; R_0603; MPN RT0603DRD07120KL; LCSC C862537
R18, R20, R22, R24: 120k; R_0603; MPN 0603WAF1203T5E; LCSC C25808
R19, R23: 20k; R_0603; MPN 0603WAF2002T5E; LCSC C4184
U2: LMV324; SOIC-14_3.9x8.65mm_Pitch1.27mm; MPN LMV324IDR; LCSC C7974

Connections:
+3V3_A: C21.1, U2.4 (V+); also elsewhere on the board
-10V_REF: R12.2, R16.2, R20.2, R24.2; also elsewhere on the board
ADC_BASE: C10.2, R11.2, U2.1; also elsewhere on the board
ADC_HPRES: C12.2, R19.2, U2.7; also elsewhere on the board
ADC_LPRES: C13.2, R23.2, U2.8; also elsewhere on the board
ADC_WIDTH: C11.2, R15.2, U2.14; also elsewhere on the board
CV_BASE: R10.1; also elsewhere on the board
CV_HPRES: R18.1; also elsewhere on the board
CV_LPRES: R22.1; also elsewhere on the board
CV_WIDTH: R14.1; also elsewhere on the board
GND: C21.2, U2.3 (+), U2.5 (+), U2.10 (+), U2.11 (V-), U2.12 (+); also elsewhere on the board
unnamed: R10.2, R13.1
unnamed: R14.2, R17.1
unnamed: C10.1, R11.1, R12.1, R13.2, U2.2 (-)
unnamed: C12.1, R18.2, R19.1, R20.1, U2.6 (-)
unnamed: C13.1, R22.2, R23.1, R24.1, U2.9 (-)
unnamed: C11.1, R15.1, R16.1, R17.2, U2.13 (-)

Notes on the sheet:
CV 1: BASE · 1V/OCT
R_in = 100k + 20k, both 0.1 % (1V/OCT input)
Vout = 1.667 V - Vin / 6:
±8 V -> 0.33 ... 3.0 V
C_f: 8 kHz low-pass
CV 2: WIDTH (1V/OCT)
CV 3: HP RES
from the jack, via the board connector
CV 4: LP RES
Op-amp supplies
U2: LMV324, ADC stages
Each CV jack (control board) arrives here through the board connector and feeds
an inverting stage that scales ±8 V into the Seed's 0 ... 3.3 V ADC range
(ADC_* go to page 3). The same CV drives its LED on the control board.
Op-amp sections and ADC pins follow the floorplan (design/pinmap.py).
4 Main board: CV inputs 1-4, ADC stages

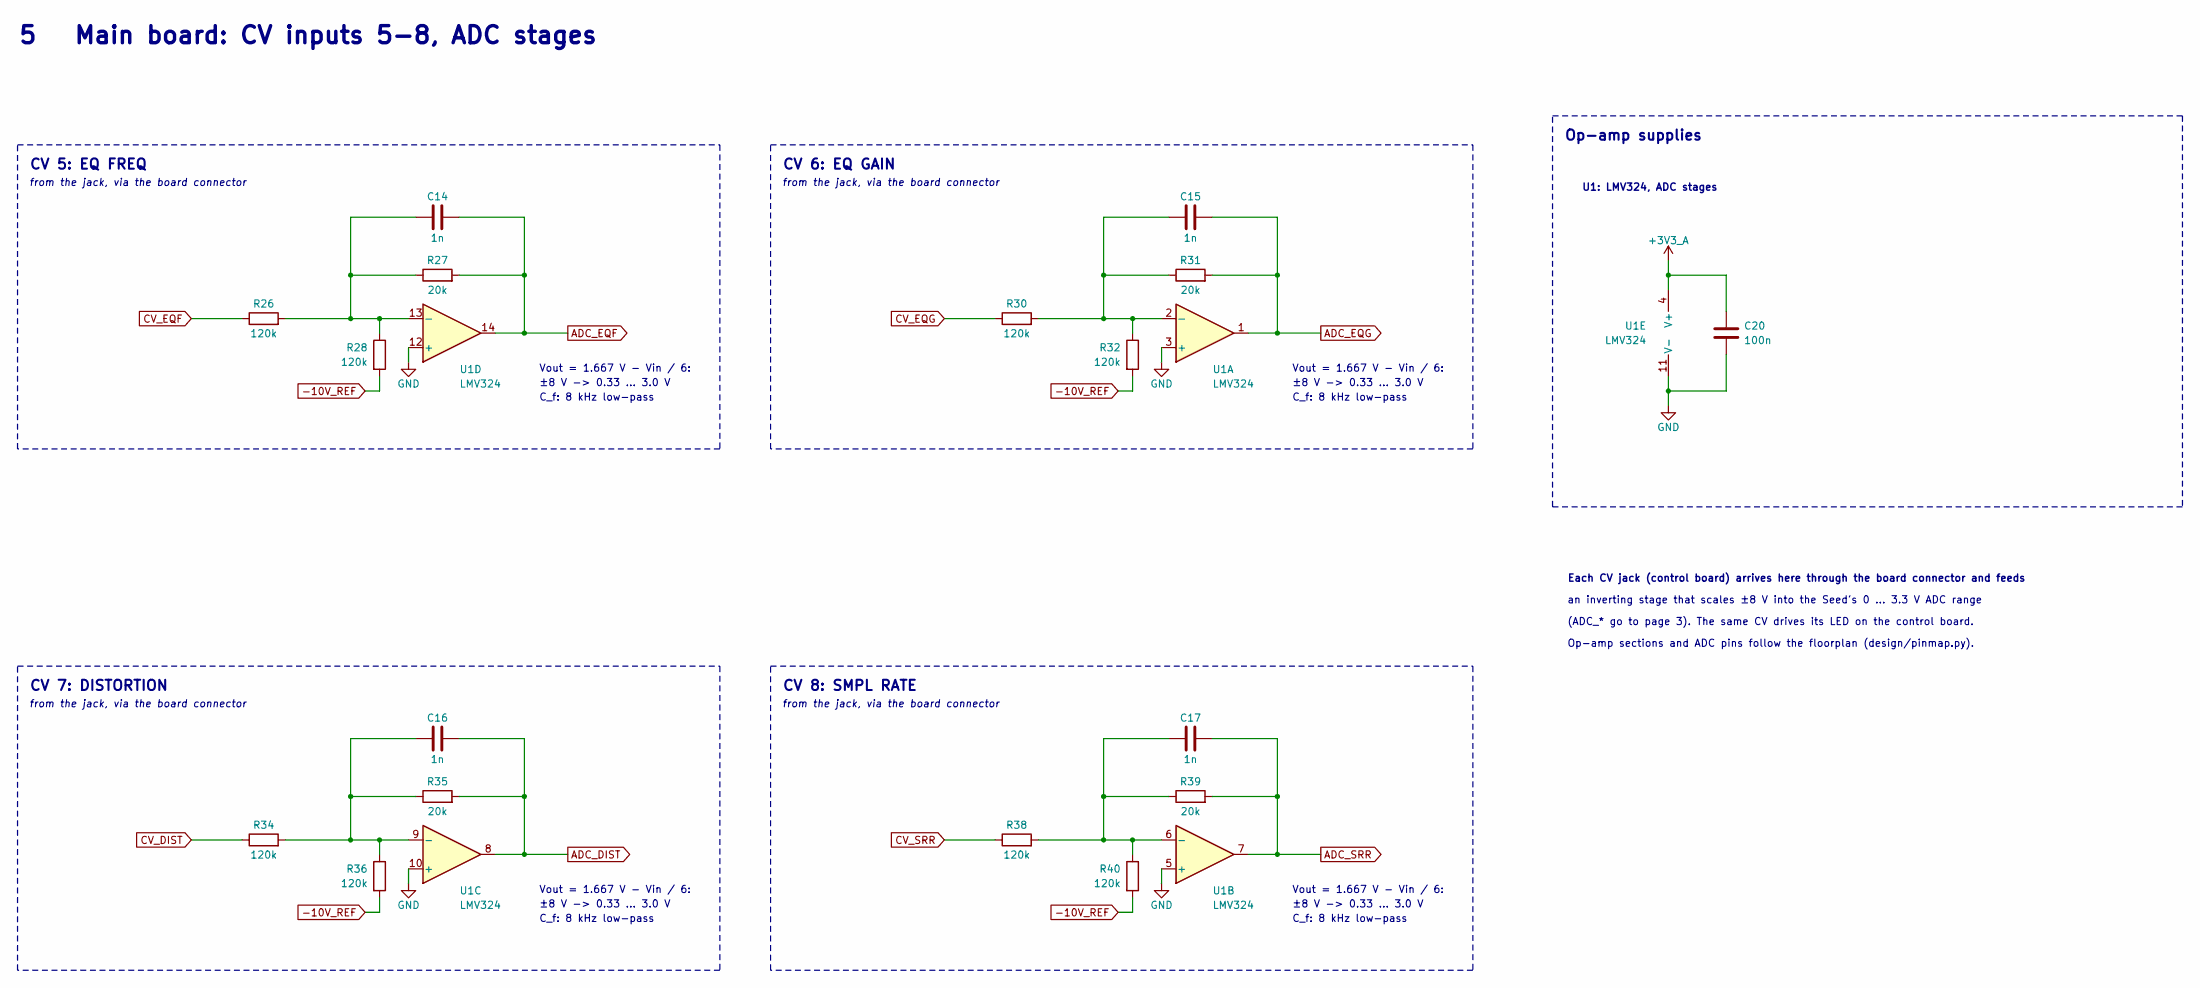
[picture p28: schematic main-cv-inputs-5-8.kicad_sch, MACHINE FILTER]

Parts:
C14, C15, C16, C17: 1n; C_0603; MPN CL10B102KB8NNNC; LCSC C1588
C20: 100n; C_0603; MPN CC0603KRX7R9BB104; LCSC C14663
R26, R28, R30, R32, R34, R36, R38, R40: 120k; R_0603; MPN 0603WAF1203T5E; LCSC C25808
R27, R31, R35, R39: 20k; R_0603; MPN 0603WAF2002T5E; LCSC C4184
U1: LMV324; SOIC-14_3.9x8.65mm_Pitch1.27mm; MPN LMV324IDR; LCSC C7974

Connections:
+3V3_A: C20.1, U1.4 (V+); also elsewhere on the board
-10V_REF: R28.2, R32.2, R36.2, R40.2; also elsewhere on the board
ADC_DIST: C16.2, R35.2, U1.8; also elsewhere on the board
ADC_EQF: C14.2, R27.2, U1.14; also elsewhere on the board
ADC_EQG: C15.2, R31.2, U1.1; also elsewhere on the board
ADC_SRR: C17.2, R39.2, U1.7; also elsewhere on the board
CV_DIST: R34.1; also elsewhere on the board
CV_EQF: R26.1; also elsewhere on the board
CV_EQG: R30.1; also elsewhere on the board
CV_SRR: R38.1; also elsewhere on the board
GND: C20.2, U1.3 (+), U1.5 (+), U1.10 (+), U1.11 (V-), U1.12 (+); also elsewhere on the board
unnamed: C15.1, R30.2, R31.1, R32.1, U1.2 (-)
unnamed: C17.1, R38.2, R39.1, R40.1, U1.6 (-)
unnamed: C16.1, R34.2, R35.1, R36.1, U1.9 (-)
unnamed: C14.1, R26.2, R27.1, R28.1, U1.13 (-)

Notes on the sheet:
CV 5: EQ FREQ
from the jack, via the board connector
Vout = 1.667 V - Vin / 6:
±8 V -> 0.33 ... 3.0 V
C_f: 8 kHz low-pass
CV 6: EQ GAIN
CV 7: DISTORTION
CV 8: SMPL RATE
Op-amp supplies
U1: LMV324, ADC stages
Each CV jack (control board) arrives here through the board connector and feeds
an inverting stage that scales ±8 V into the Seed's 0 ... 3.3 V ADC range
(ADC_* go to page 3). The same CV drives its LED on the control board.
Op-amp sections and ADC pins follow the floorplan (design/pinmap.py).
5 Main board: CV inputs 5-8, ADC stages

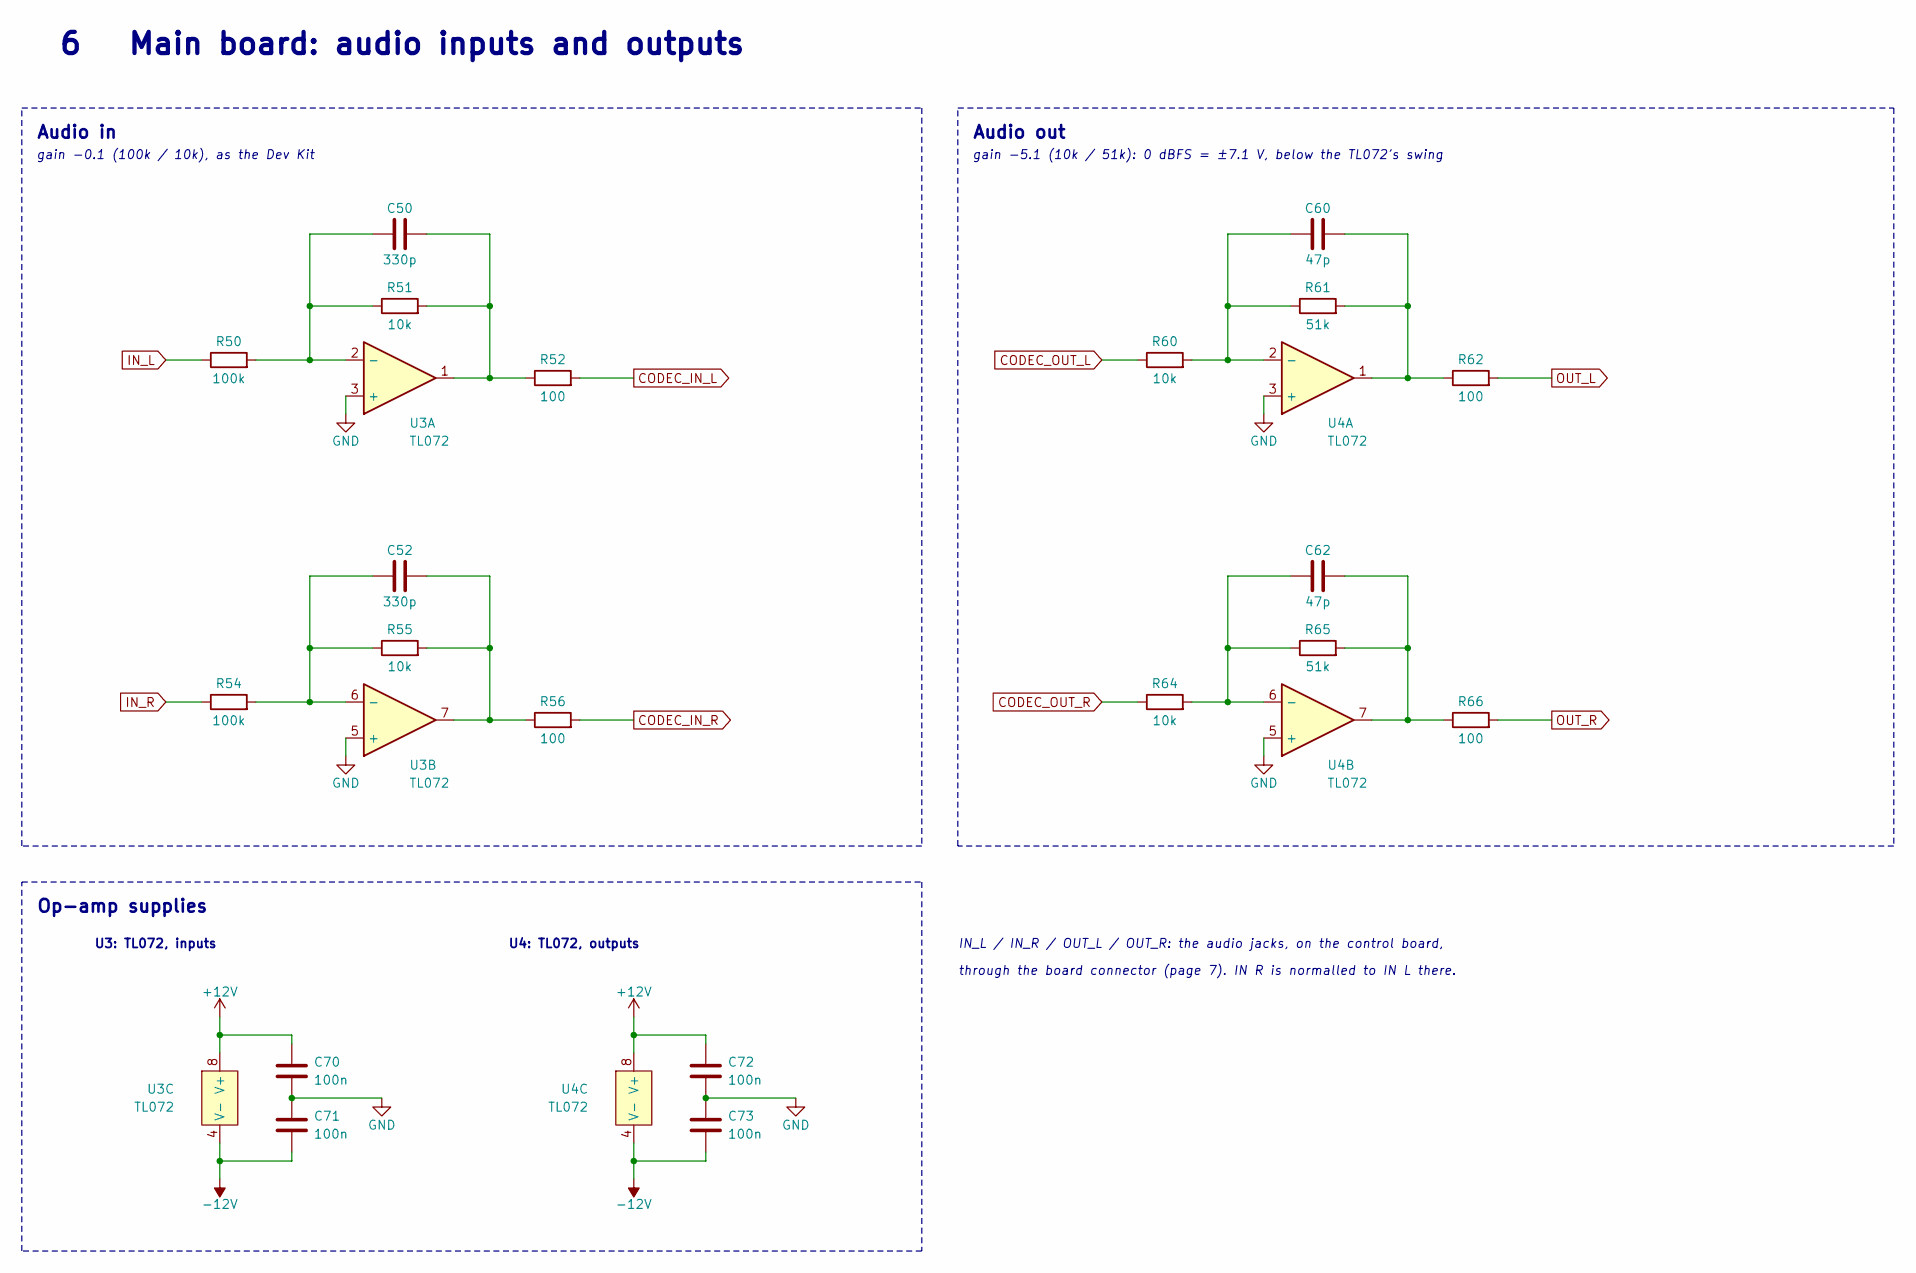
[picture p29: schematic main-audio.kicad_sch, MACHINE FILTER]

Parts:
C50, C52: 330p; C_0603; MPN CL10C331JB8NNNC; LCSC C1664
C60, C62: 47p; C_0603; MPN CL10C470JB8NNNC; LCSC C1671
C70, C71, C72, C73: 100n; C_0603; MPN CC0603KRX7R9BB104; LCSC C14663
R50, R54: 100k; R_0603; MPN 0603WAF1003T5E; LCSC C25803
R51, R55, R60, R64: 10k; R_0603; MPN 0603WAF1002T5E; LCSC C25804
R52, R56, R62, R66: 100; R_0603; MPN 0603WAF1000T5E; LCSC C22775
R61, R65: 51k; R_0603; MPN 0603WAF5102T5E; LCSC C23196
U3, U4: TL072; SOIC-8_3.9x4.9mm_Pitch1.27mm; MPN TL072CDT; LCSC C6961

Connections:
+12V: C70.1, C72.1, U3.8 (V+), U4.8 (V+); also elsewhere on the board
-12V: C71.2, C73.2, U3.4 (V-), U4.4 (V-); also elsewhere on the board
CODEC_IN_L: R52.2; also elsewhere on the board
CODEC_IN_R: R56.2; also elsewhere on the board
CODEC_OUT_L: R60.1; also elsewhere on the board
CODEC_OUT_R: R64.1; also elsewhere on the board
GND: C70.2, C71.1, C72.2, C73.1, U3.3 (+), U3.5 (+), U4.3 (+), U4.5 (+); also elsewhere on the board
IN_L: R50.1; also elsewhere on the board
IN_R: R54.1; also elsewhere on the board
unnamed: C50.2, R51.2, R52.1, U3.1
unnamed: C52.2, R55.2, R56.1, U3.7
unnamed: C60.2, R61.2, R62.1, U4.1
unnamed: C62.2, R65.2, R66.1, U4.7
unnamed: C50.1, R50.2, R51.1, U3.2 (-)
unnamed: C52.1, R54.2, R55.1, U3.6 (-)
unnamed: C60.1, R60.2, R61.1, U4.2 (-)
unnamed: C62.1, R64.2, R65.1, U4.6 (-)
OUT_L: R62.2; also elsewhere on the board
OUT_R: R66.2; also elsewhere on the board

Notes on the sheet:
Audio in
gain -0.1 (100k / 10k), as the Dev Kit
Audio out
gain -5.1 (10k / 51k): 0 dBFS = ±7.1 V, below the TL072's swing
Op-amp supplies
U3: TL072, inputs
U4: TL072, outputs
IN_L / IN_R / OUT_L / OUT_R: the audio jacks, on the control board,
through the board connector (page 7). IN R is normalled to IN L there.
6 Main board: audio inputs and outputs

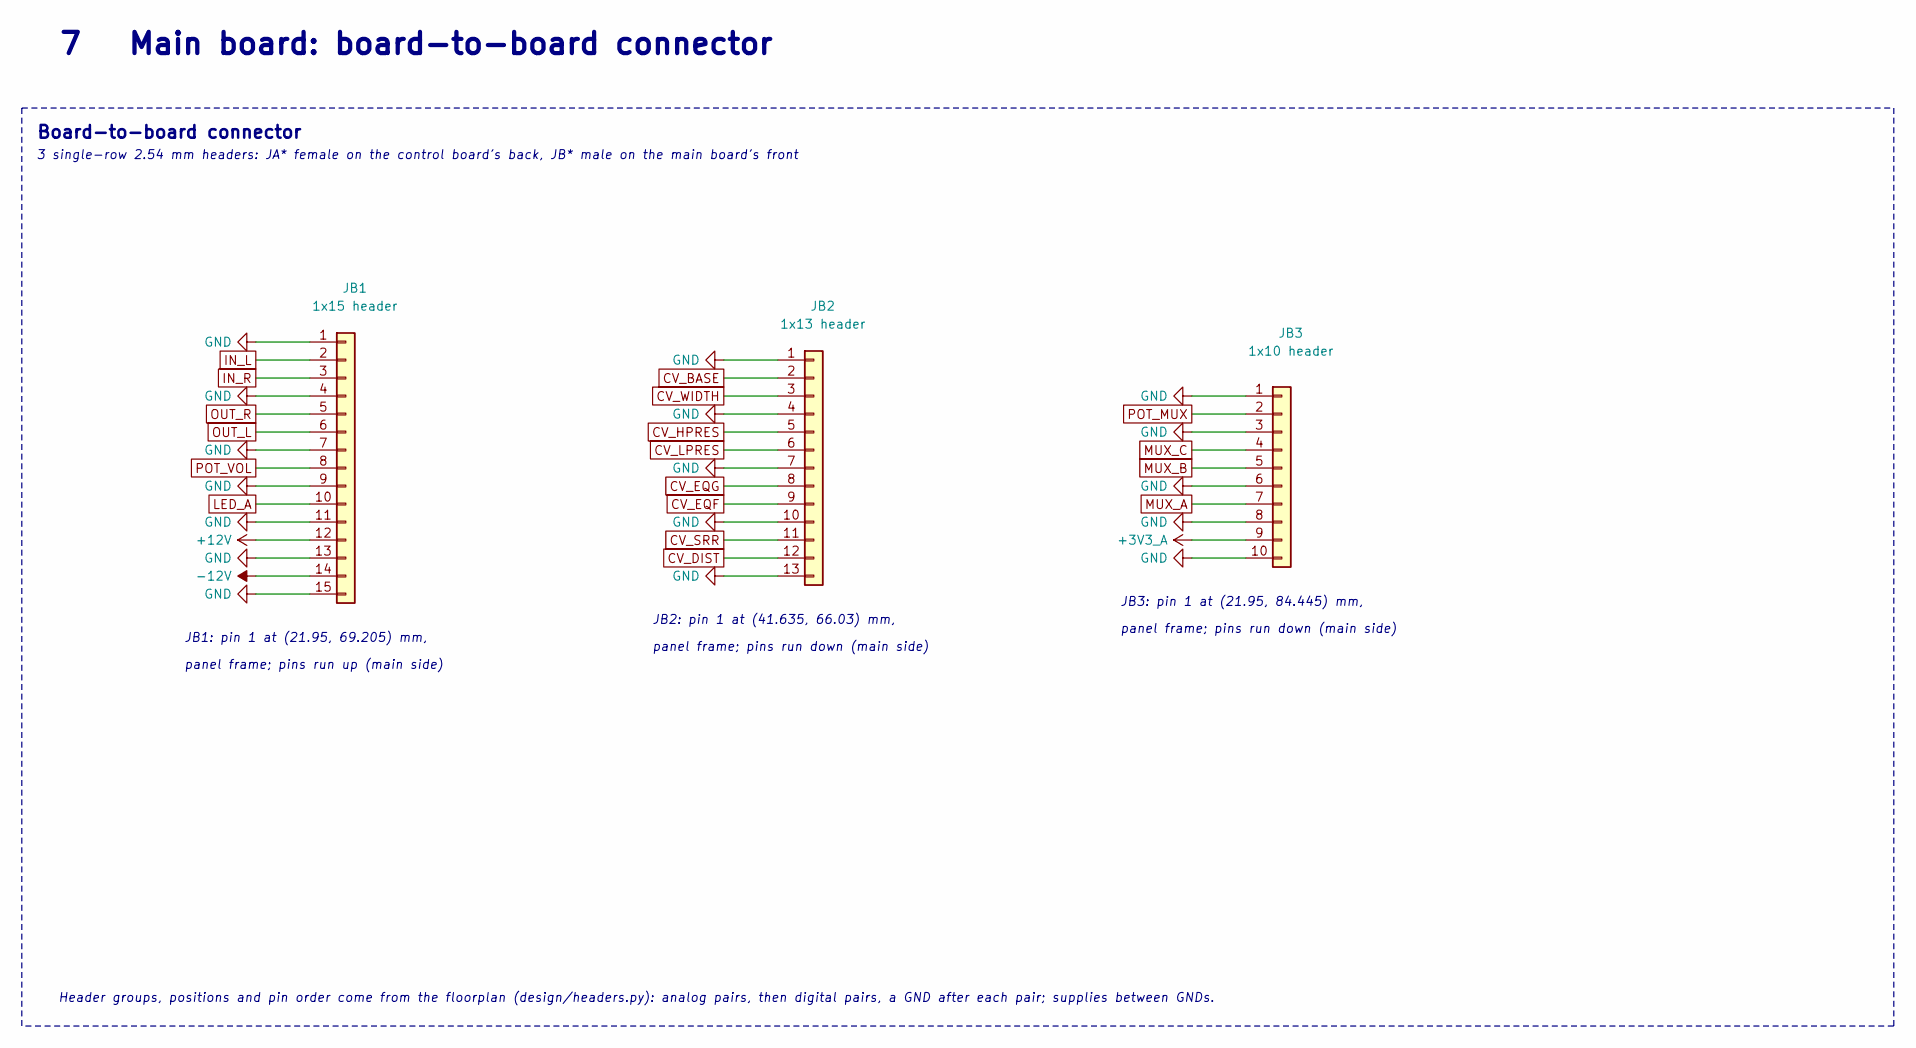
[picture p30: schematic main-connector.kicad_sch, MACHINE FILTER]

Parts:
JB1: 1x15 header; PinHeader_1x15_P2.54mm_Vertical; MPN 2.54 mm male pin header 1x15
JB2: 1x13 header; PinHeader_1x13_P2.54mm_Vertical; MPN 2.54 mm male pin header 1x13
JB3: 1x10 header; PinHeader_1x10_P2.54mm_Vertical; MPN 2.54 mm male pin header 1x10

Connections:
+3V3_A: JB3.9; also elsewhere on the board
+12V: JB1.12; also elsewhere on the board
-12V: JB1.14; also elsewhere on the board
CV_BASE: JB2.2; also elsewhere on the board
CV_DIST: JB2.12; also elsewhere on the board
CV_EQF: JB2.9; also elsewhere on the board
CV_EQG: JB2.8; also elsewhere on the board
CV_HPRES: JB2.5; also elsewhere on the board
CV_LPRES: JB2.6; also elsewhere on the board
CV_SRR: JB2.11; also elsewhere on the board
CV_WIDTH: JB2.3; also elsewhere on the board
GND: JB1.1, JB1.4, JB1.7, JB1.9, JB1.11, JB1.13, JB1.15, JB2.1, JB2.4, JB2.7, JB2.10, JB2.13, JB3.1, JB3.3, JB3.6, JB3.8, JB3.10; also elsewhere on the board
IN_L: JB1.2; also elsewhere on the board
IN_R: JB1.3; also elsewhere on the board
LED_A: JB1.10; also elsewhere on the board
MUX_A: JB3.7; also elsewhere on the board
MUX_B: JB3.5; also elsewhere on the board
MUX_C: JB3.4; also elsewhere on the board
OUT_L: JB1.6; also elsewhere on the board
OUT_R: JB1.5; also elsewhere on the board
POT_MUX: JB3.2; also elsewhere on the board
POT_VOL: JB1.8; also elsewhere on the board

Notes on the sheet:
Board-to-board connector
3 single-row 2.54 mm headers: JA* female on the control board's back, JB* male on the main board's front
JB1: pin 1 at (21.95, 69.205) mm,
panel frame; pins run up (main side)
JB2: pin 1 at (41.635, 66.03) mm,
panel frame; pins run down (main side)
JB3: pin 1 at (21.95, 84.445) mm,
Header groups, positions and pin order come from the floorplan (design/headers.py): analog pairs, then digital pairs, a GND after each pair; supplies between GNDs.
7 Main board: board-to-board connector
