daaaaaaaaaniel/claude-schematic-monomachine-workflow/pcb/machine-filter/machine-filter.kicad_pcb

## KiCad design pcb/machine-filter/machine-filter.kicad_pcb (continued)

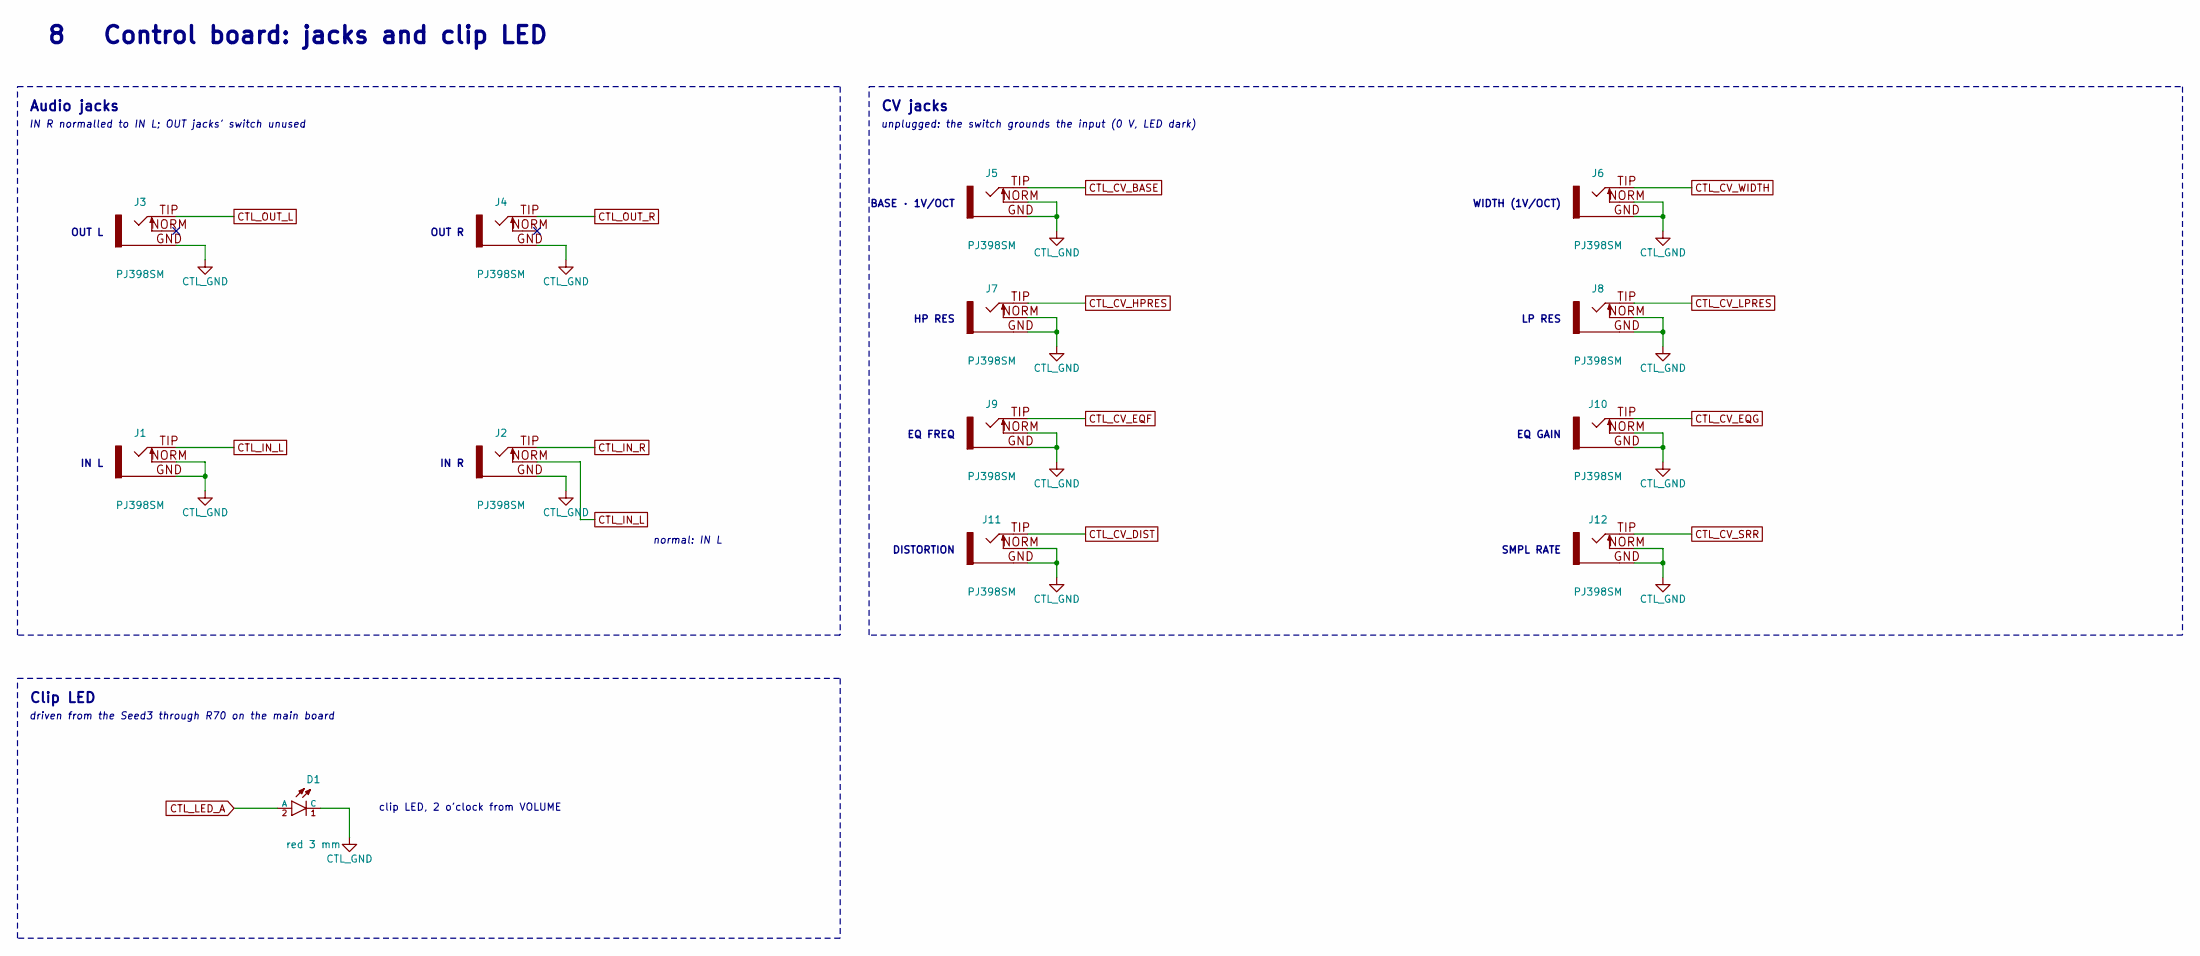
[picture p31: schematic control-jacks.kicad_sch, MACHINE FILTER]

Parts:
D1: red 3 mm; LED_3mm_C1A2; MPN 3 mm red LED, diffused
J1, J2, J3, J4: PJ398SM; PJ398SM_Jack_ES; MPN Thonkiconn PJ398SM
J5, J6, J7, J8, J9, J10, J11, J12: PJ398SM; PJ398SM_Jack_4ms_BentGND; MPN Thonkiconn PJ398SM, sleeve leg bent to 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

Connections:
CTL_CV_BASE: J5.TIP; also elsewhere on the board
CTL_CV_DIST: J11.TIP; also elsewhere on the board
CTL_CV_EQF: J9.TIP; also elsewhere on the board
CTL_CV_EQG: J10.TIP; also elsewhere on the board
CTL_CV_HPRES: J7.TIP; also elsewhere on the board
CTL_CV_LPRES: J8.TIP; also elsewhere on the board
CTL_CV_SRR: J12.TIP; also elsewhere on the board
CTL_CV_WIDTH: J6.TIP; also elsewhere on the board
CTL_GND: D1.1 (C), J1.GND, J1.NORM, J2.GND, J3.GND, J4.GND, J5.GND, J5.NORM, J6.GND, J6.NORM, J7.GND, J7.NORM, J8.GND, J8.NORM, J9.GND, J9.NORM, J10.GND, J10.NORM, J11.GND, J11.NORM, J12.GND, J12.NORM; also elsewhere on the board
CTL_IN_L: J1.TIP, J2.NORM; also elsewhere on the board
CTL_IN_R: J2.TIP; also elsewhere on the board
CTL_LED_A: D1.2 (A); also elsewhere on the board
CTL_OUT_L: J3.TIP; also elsewhere on the board
CTL_OUT_R: J4.TIP; also elsewhere on the board

Notes on the sheet:
Audio jacks
IN R normalled to IN L; OUT jacks' switch unused
OUT L
OUT R
IN L
IN R
normal: IN L
CV jacks
unplugged: the switch grounds the input (0 V, LED dark)
BASE · 1V/OCT
WIDTH (1V/OCT)
HP RES
LP RES
EQ FREQ
EQ GAIN
DISTORTION
SMPL RATE
Clip LED
driven from the Seed3 through R70 on the main board
clip LED, 2 o'clock from VOLUME
8 Control board: jacks and clip LED

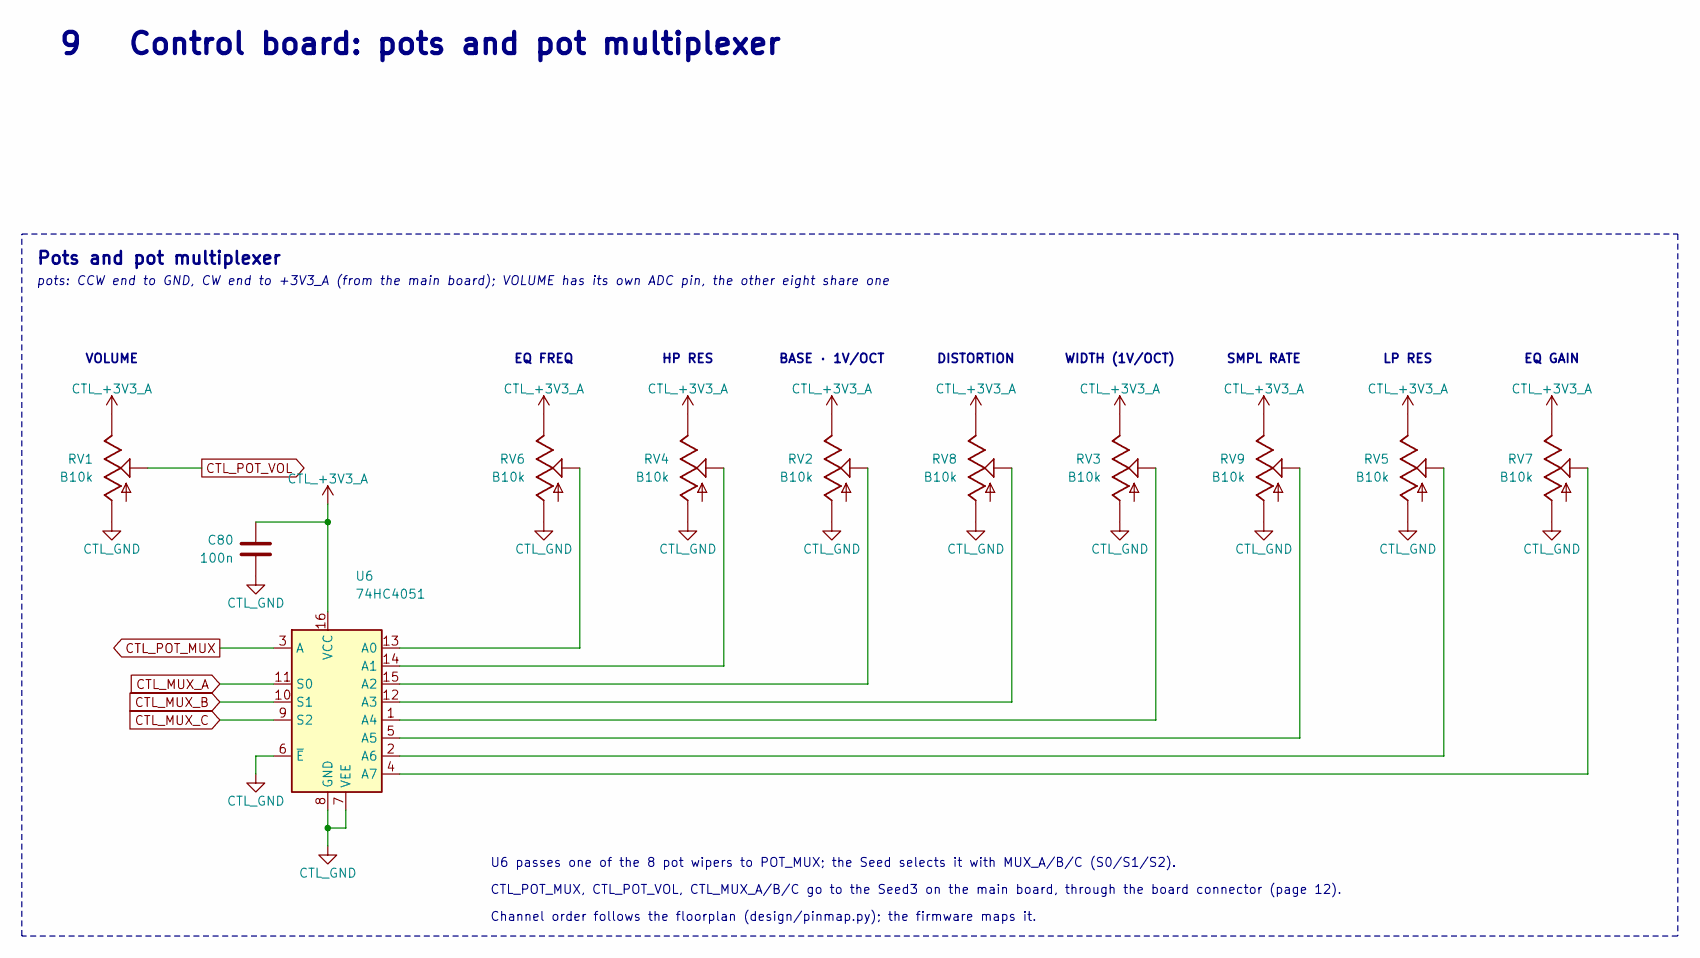
[picture p32: schematic control-pots.kicad_sch, MACHINE FILTER]

Parts:
C80: 100n; C_Disc_D3.0mm_W1.6mm_P2.50mm; MPN 100 nF 50 V X7R ceramic, 2.5 mm pitch
RV1, RV2, RV3, RV4, RV5, RV6, RV7, RV8, RV9: B10k; Pot_9mm_SnapIn_ES; MPN Alpha RD901F 9 mm B10k (any shaft)
U6: 74HC4051; SOIC-16_3.9x9.9mm_Pitch1.27mm; MPN 74HC4051D,653; LCSC C9386

Connections:
CTL_+3V3_A: C80.1, RV1.3, RV2.3, RV3.3, RV4.3, RV5.3, RV6.3, RV7.3, RV8.3, RV9.3, U6.16 (VCC); also elsewhere on the board
CTL_GND: C80.2, RV1.1, RV2.1, RV3.1, RV4.1, RV5.1, RV6.1, RV7.1, RV8.1, RV9.1, U6.6 (~E), U6.7 (VEE), U6.8 (GND); also elsewhere on the board
CTL_MUX_A: U6.11 (S0); also elsewhere on the board
CTL_MUX_B: U6.10 (S1); also elsewhere on the board
CTL_MUX_C: U6.9 (S2); also elsewhere on the board
CTL_POT_MUX: U6.3 (A); also elsewhere on the board
CTL_POT_VOL: RV1.2; also elsewhere on the board
unnamed: RV6.2, U6.13 (A0)
unnamed: RV4.2, U6.14 (A1)
unnamed: RV2.2, U6.15 (A2)
unnamed: RV8.2, U6.12 (A3)
unnamed: RV3.2, U6.1 (A4)
unnamed: RV9.2, U6.5 (A5)
unnamed: RV5.2, U6.2 (A6)
unnamed: RV7.2, U6.4 (A7)

Notes on the sheet:
Pots and pot multiplexer
pots: CCW end to GND, CW end to +3V3_A (from the main board); VOLUME has its own ADC pin, the other eight share one
EQ FREQ
HP RES
BASE · 1V/OCT
DISTORTION
WIDTH (1V/OCT)
SMPL RATE
LP RES
EQ GAIN
VOLUME
U6 passes one of the 8 pot wipers to POT_MUX; the Seed selects it with MUX_A/B/C (S0/S1/S2).
CTL_POT_MUX, CTL_POT_VOL, CTL_MUX_A/B/C go to the Seed3 on the main board, through the board connector (page 12).
Channel order follows the floorplan (design/pinmap.py); the firmware maps it.
9 Control board: pots and pot multiplexer

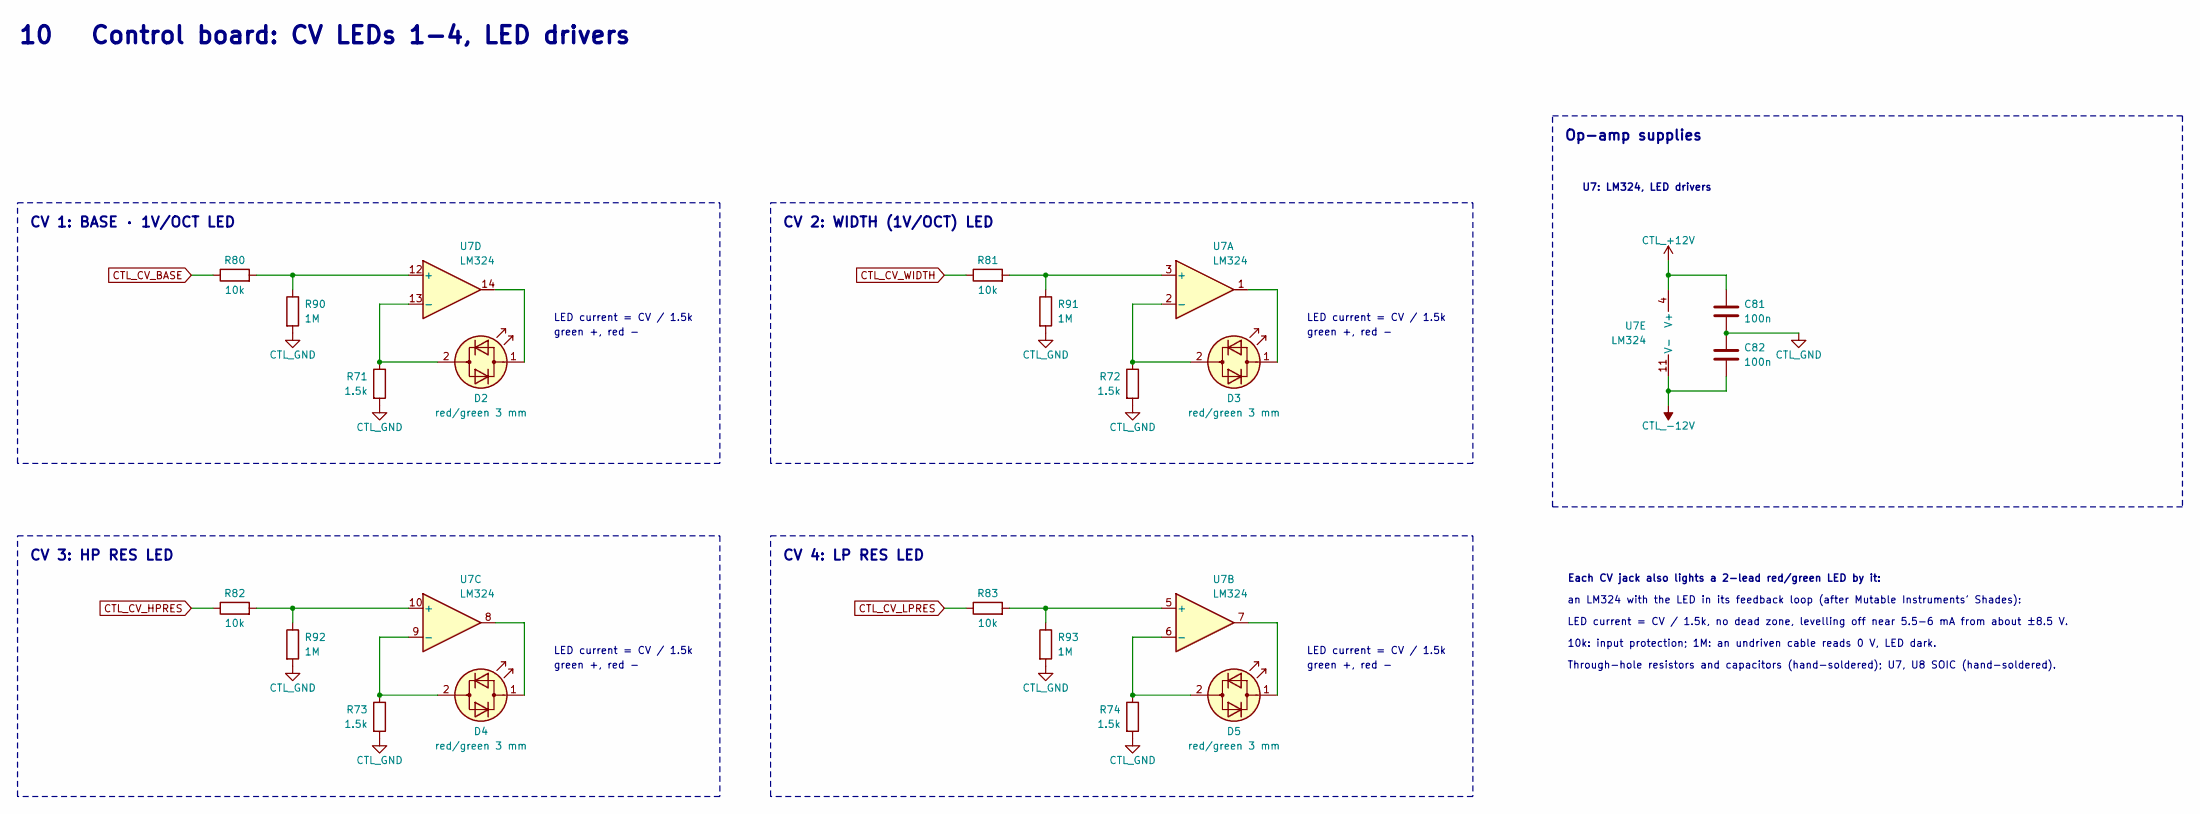
[picture p33: schematic control-cv-leds-1-4.kicad_sch, MACHINE FILTER]

Parts:
C81, C82: 100n; C_Disc_D3.0mm_W1.6mm_P2.50mm; MPN 100 nF 50 V X7R ceramic, 2.5 mm pitch
D2, D3, D4, D5: red/green 3 mm; LED_3mm_Raised; MPN 3 mm red/green bicolour LED, 2 leads (a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
R71, R72, R73, R74: 1.5k; R_Axial_DIN0204_L3.6mm_D1.6mm_P5.08mm_Horizontal; MPN 1.5k 1/8 W 1% metal film, axial DIN0204
R80, R81, R82, R83: 10k; R_Axial_DIN0204_L3.6mm_D1.6mm_P5.08mm_Horizontal; MPN 10k 1/8 W 1% metal film, axial DIN0204
R90, R91, R92, R93: 1M; R_Axial_DIN0204_L3.6mm_D1.6mm_P5.08mm_Horizontal; MPN 1M 1/8 W 1% metal film, axial DIN0204
U7: LM324; SOIC-14_3.9x8.65mm_Pitch1.27mm; MPN LM324DT; LCSC C71035

Connections:
CTL_+12V: C81.1, U7.4 (V+); also elsewhere on the board
CTL_-12V: C82.2, U7.11 (V-); also elsewhere on the board
CTL_CV_BASE: R80.1; also elsewhere on the board
CTL_CV_HPRES: R82.1; also elsewhere on the board
CTL_CV_LPRES: R83.1; also elsewhere on the board
CTL_CV_WIDTH: R81.1; also elsewhere on the board
CTL_GND: C81.2, C82.1, R71.2, R72.2, R73.2, R74.2, R90.2, R91.2, R92.2, R93.2; also elsewhere on the board
unnamed: D2.2 (AK), R71.1, U7.13 (-)
unnamed: D2.1 (KA), U7.14
unnamed: D3.2 (AK), R72.1, U7.2 (-)
unnamed: D3.1 (KA), U7.1
unnamed: D4.2 (AK), R73.1, U7.9 (-)
unnamed: D4.1 (KA), U7.8
unnamed: D5.2 (AK), R74.1, U7.6 (-)
unnamed: D5.1 (KA), U7.7
unnamed: R81.2, R91.1, U7.3 (+)
unnamed: R83.2, R93.1, U7.5 (+)
unnamed: R82.2, R92.1, U7.10 (+)
unnamed: R80.2, R90.1, U7.12 (+)

Notes on the sheet:
CV 1: BASE · 1V/OCT LED
LED current = CV / 1.5k
green +, red -
CV 2: WIDTH (1V/OCT) LED
CV 3: HP RES LED
CV 4: LP RES LED
Op-amp supplies
U7: LM324, LED drivers
Each CV jack also lights a 2-lead red/green LED by it:
an LM324 with the LED in its feedback loop (after Mutable Instruments' Shades):
LED current = CV / 1.5k, no dead zone, levelling off near 5.5-6 mA from about ±8.5 V.
10k: input protection; 1M: an undriven cable reads 0 V, LED dark.
Through-hole resistors and capacitors (hand-soldered); U7, U8 SOIC (hand-soldered).
10 Control board: CV LEDs 1-4, LED drivers

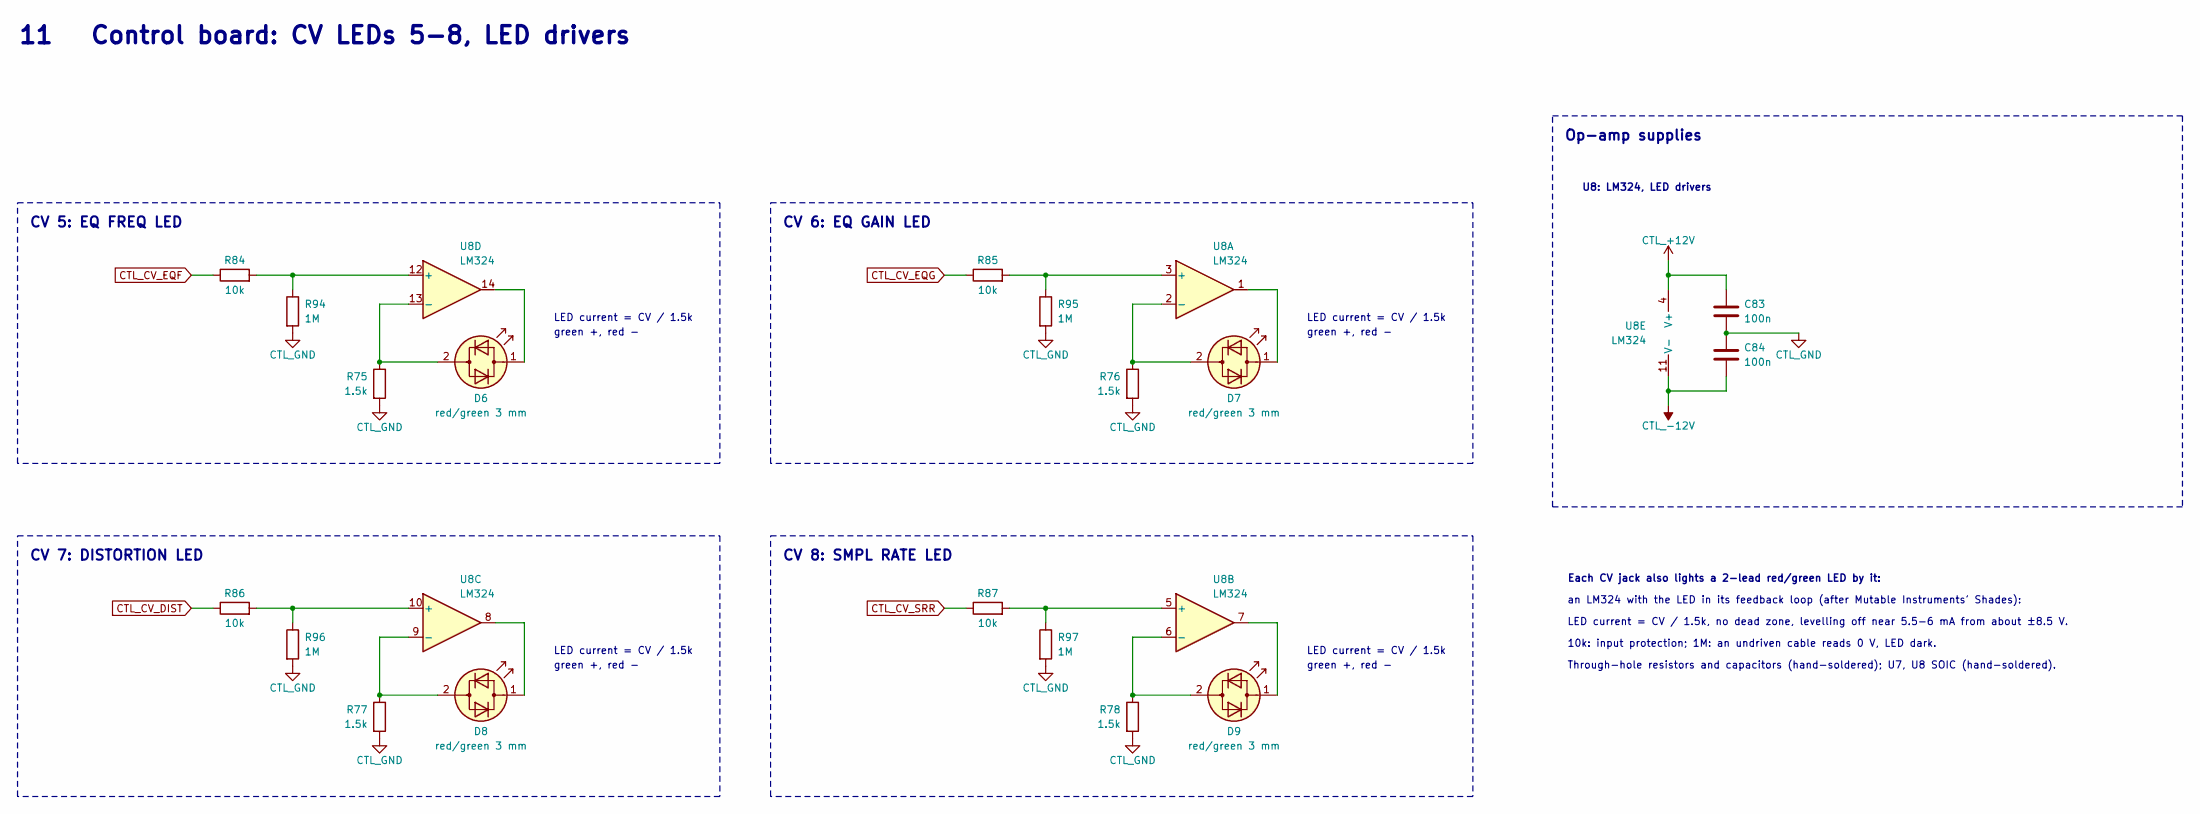
[picture p34: schematic control-cv-leds-5-8.kicad_sch, MACHINE FILTER]

Parts:
C83, C84: 100n; C_Disc_D3.0mm_W1.6mm_P2.50mm; MPN 100 nF 50 V X7R ceramic, 2.5 mm pitch
D6, D7, D8, D9: red/green 3 mm; LED_3mm_Raised; MPN 3 mm red/green bicolour LED, 2 leads (a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
R75, R76, R77, R78: 1.5k; R_Axial_DIN0204_L3.6mm_D1.6mm_P5.08mm_Horizontal; MPN 1.5k 1/8 W 1% metal film, axial DIN0204
R84, R85, R86, R87: 10k; R_Axial_DIN0204_L3.6mm_D1.6mm_P5.08mm_Horizontal; MPN 10k 1/8 W 1% metal film, axial DIN0204
R94, R95, R96, R97: 1M; R_Axial_DIN0204_L3.6mm_D1.6mm_P5.08mm_Horizontal; MPN 1M 1/8 W 1% metal film, axial DIN0204
U8: LM324; SOIC-14_3.9x8.65mm_Pitch1.27mm; MPN LM324DT; LCSC C71035

Connections:
CTL_+12V: C83.1, U8.4 (V+); also elsewhere on the board
CTL_-12V: C84.2, U8.11 (V-); also elsewhere on the board
CTL_CV_DIST: R86.1; also elsewhere on the board
CTL_CV_EQF: R84.1; also elsewhere on the board
CTL_CV_EQG: R85.1; also elsewhere on the board
CTL_CV_SRR: R87.1; also elsewhere on the board
CTL_GND: C83.2, C84.1, R75.2, R76.2, R77.2, R78.2, R94.2, R95.2, R96.2, R97.2; also elsewhere on the board
unnamed: D6.2 (AK), R75.1, U8.13 (-)
unnamed: D6.1 (KA), U8.14
unnamed: D7.2 (AK), R76.1, U8.2 (-)
unnamed: D7.1 (KA), U8.1
unnamed: D8.2 (AK), R77.1, U8.9 (-)
unnamed: D8.1 (KA), U8.8
unnamed: D9.2 (AK), R78.1, U8.6 (-)
unnamed: D9.1 (KA), U8.7
unnamed: R85.2, R95.1, U8.3 (+)
unnamed: R87.2, R97.1, U8.5 (+)
unnamed: R86.2, R96.1, U8.10 (+)
unnamed: R84.2, R94.1, U8.12 (+)

Notes on the sheet:
CV 5: EQ FREQ LED
LED current = CV / 1.5k
green +, red -
CV 6: EQ GAIN LED
CV 7: DISTORTION LED
CV 8: SMPL RATE LED
Op-amp supplies
U8: LM324, LED drivers
Each CV jack also lights a 2-lead red/green LED by it:
an LM324 with the LED in its feedback loop (after Mutable Instruments' Shades):
LED current = CV / 1.5k, no dead zone, levelling off near 5.5-6 mA from about ±8.5 V.
10k: input protection; 1M: an undriven cable reads 0 V, LED dark.
Through-hole resistors and capacitors (hand-soldered); U7, U8 SOIC (hand-soldered).
11 Control board: CV LEDs 5-8, LED drivers

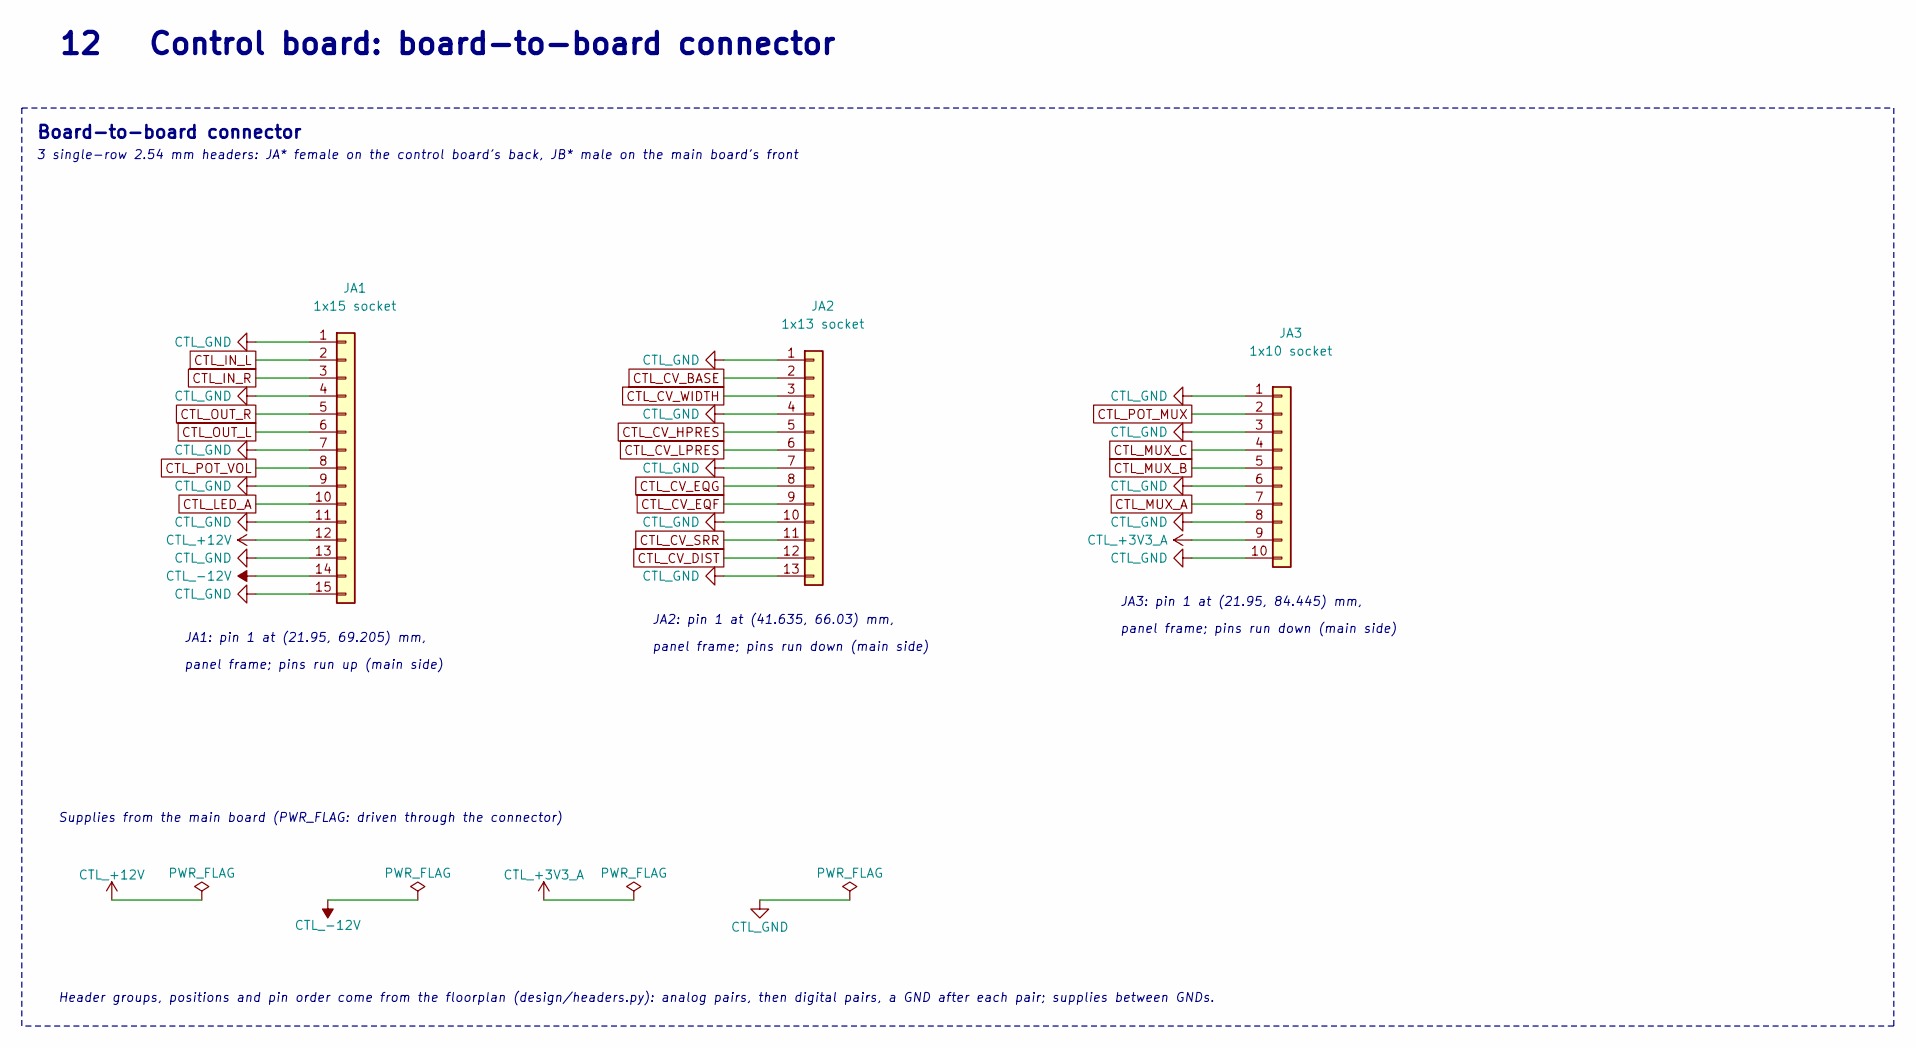
[picture p35: schematic control-connector.kicad_sch, MACHINE FILTER]

Parts:
JA1: 1x15 socket; PinSocket_1x15_P2.54mm_Vertical; MPN 2.54 mm female header 1x15, 8.5 mm (as 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
JA2: 1x13 socket; PinSocket_1x13_P2.54mm_Vertical; MPN 2.54 mm female header 1x13, 8.5 mm (as 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
JA3: 1x10 socket; PinSocket_1x10_P2.54mm_Vertical; MPN 2.54 mm female header 1x10, 8.5 mm (as 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

Connections:
CTL_+3V3_A: JA3.9; also elsewhere on the board
CTL_+12V: JA1.12; also elsewhere on the board
CTL_-12V: JA1.14; also elsewhere on the board
CTL_CV_BASE: JA2.2; also elsewhere on the board
CTL_CV_DIST: JA2.12; also elsewhere on the board
CTL_CV_EQF: JA2.9; also elsewhere on the board
CTL_CV_EQG: JA2.8; also elsewhere on the board
CTL_CV_HPRES: JA2.5; also elsewhere on the board
CTL_CV_LPRES: JA2.6; also elsewhere on the board
CTL_CV_SRR: JA2.11; also elsewhere on the board
CTL_CV_WIDTH: JA2.3; also elsewhere on the board
CTL_GND: JA1.1, JA1.4, JA1.7, JA1.9, JA1.11, JA1.13, JA1.15, JA2.1, JA2.4, JA2.7, JA2.10, JA2.13, JA3.1, JA3.3, JA3.6, JA3.8, JA3.10; also elsewhere on the board
CTL_IN_L: JA1.2; also elsewhere on the board
CTL_IN_R: JA1.3; also elsewhere on the board
CTL_LED_A: JA1.10; also elsewhere on the board
CTL_MUX_A: JA3.7; also elsewhere on the board
CTL_MUX_B: JA3.5; also elsewhere on the board
CTL_MUX_C: JA3.4; also elsewhere on the board
CTL_OUT_L: JA1.6; also elsewhere on the board
CTL_OUT_R: JA1.5; also elsewhere on the board
CTL_POT_MUX: JA3.2; also elsewhere on the board
CTL_POT_VOL: JA1.8; also elsewhere on the board

Notes on the sheet:
Board-to-board connector
3 single-row 2.54 mm headers: JA* female on the control board's back, JB* male on the main board's front
JA1: pin 1 at (21.95, 69.205) mm,
panel frame; pins run up (main side)
JA2: pin 1 at (41.635, 66.03) mm,
panel frame; pins run down (main side)
JA3: pin 1 at (21.95, 84.445) mm,
Supplies from the main board (PWR_FLAG: driven through the connector)
Header groups, positions and pin order come from the floorplan (design/headers.py): analog pairs, then digital pairs, a GND after each pair; supplies between GNDs.
12 Control board: board-to-board connector

Board: 4 copper layers, 154 parts (121 on the bottom side), 125 nets, no tracks yet.
