daaaaaaaaaniel/claude-schematic-monomachine-workflow/(commit log)

2026-10-06 MACHINE FILTER rev beta: two-board schematic, floorplan and handoff
    Eurorack filter module on a Daisy Seed3, split into a JLC-assembled main board
    and a hand-soldered control board, in one KiCad 10 project (KiKit multiboard).
    - SKiDL netlist (pcb/machine_filter.py) and generated hierarchical schematic
    (pcb/design/gen_sch.py), held together by tools/check_netlist.py
    - floorplan with KiCad footprints that sets pin assignments and header layout
    - ngspice checks, placement guide, design review, firmware changes
    - header-layout candidates in explore/header-candidates/ (open decision)
    Claude-Session: https://claude.ai/code/session_01Cf5qN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
    [bom.csv, control-connector.kicad_sch, control-cv-leds-1-4.kicad_sch, control-cv-leds-5-8.kicad_sch, control-jacks.kicad_sch, control-pots.kicad_sch, machine-filter.kicad_pcb, machine-filter.kicad_sch]
2026-10-06 PCB step 1: footprints into the PCB file; schematic frozen
    - design/place_first.py: brings all 154 footprints from the schematic's netlist
    into machine-filter.kicad_pcb with nets and schematic links. Panel parts,
    board-to-board headers, Seed3, ICs, connectors and bulky capacitors go to
    their decided positions; the 100 small passives are parked below their own
    board, grouped by schematic page. DRC schematic parity: 0 issues.
    - gen_sch.py: deterministic uuids (keyed by sheet, reference, unit, pin), so a
    rebuild no longer orphans the PCB's footprint-to-symbol links.
    - tools/render_pcb.py: review picture of the PCB file (out/pcb-placement.png).
    - HANDOFF.md, CLAUDE.md: schematic frozen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
    [control-connector.kicad_sch, control-cv-leds-1-4.kicad_sch, control-cv-leds-5-8.kicad_sch, control-jacks.kicad_sch, control-pots.kicad_sch, machine-filter.kicad_pcb, machine-filter.kicad_sch, main-audio.kicad_sch]
2026-10-06 atopile retry: 0.15.9 builds offline, but targets KiCad 9
    With pre-picked atomic parts the build skips the sign-in-only picker and
    completes offline (footprints, nets, LCSC BOM). But atopile 0.15.9 reads and
    writes KiCad 9 files; after KiCad 10 saves the board, the next ato build
    fails to parse it. Recorded in docs/toolchain.md; test design in
    explore/atopile-trial/.
